namontoy/RobertUN/README.md

# RobertUN
Exploration Rover, inspired by the NASA's rovers that are exploring Mars. Developed at Universidad Nacional de Colombia - Sede Medellín, with the financial support from a research project.
