namontoy/RobertUN/docs/dev/environment/PROJECT_CONTEXT_WHEEL_FW_REF_MCU.md

# RobertUN wheel firmware — reference: MCU, pins, CAN and firmware modules

> Reference tier. Moved verbatim from `PROJECT_CONTEXT_WHEEL_FW.md` on 2026-09-26.
> Do not read whole: `grep -n '^#' <this file>` and read the section you need.
> Contents: CAN peripheral and bit timing, pin allocation, timers, firmware modules (debug_uart, can_bus, console), CAN error counters, bus load

## CAN BUS — STM32 PERIPHERAL & BIT TIMING

### STM32 CAN peripheral
- **STM32F4xx uses bxCAN peripheral** (Basic Extended CAN)
  - Full layer 2 implementation in hardware: frame construction, arbitration,
    CRC, ACK, fault confinement, acceptance filters — all in silicon
  - bxCAN outputs logic-level CAN_TX / CAN_RX to the SN65HVD230 transceiver
  - No built-in transceiver — external IC always required (same as Jetson)
- **CAN1 pins on the WeAct board: PB9 (TX) / PB8 (RX).** The alternate CAN1
  mapping PA11/PA12 is wired to the board's USB-C connector and must not be
  used. Use CAN1, not CAN2 — on the F446 CAN2 is a slave peripheral that cannot
  run without CAN1's clock enabled anyway.
- **bxCAN SJW maxes out at 4 tq** (the register field is 2 bits wide), and must
  also be <= BS2. Orion's `sjw 16` therefore does *not* transfer literally to
  the STM32. The rule that carries across is **"set SJW explicitly on every
  node, at the highest value that node's hardware allows"** — not the number 16.

#### Bit timing @ 250 kbps (derived Aug 9, 2026, from 8 MHz HSE)

| Parameter | Value | Notes |
|---|---|---|
| HSE | 8 MHz | crystal on WeAct board, scope-verified |
| SYSCLK | 180 MHz | PLL M=4, N=180, P=2 — see divider note below |
| APB1 (bxCAN clock) | 45 MHz | /4 |
| Prescaler (BRP) | 12 | tq = 266.67 ns |
| Bit Segment 1 (BS1) | 12 tq | HAL: `CAN_BS1_12TQ` |
| Bit Segment 2 (BS2) | 2 tq | HAL: `CAN_BS2_2TQ` |
| SJW | 2 tq | HAL: `CAN_SJW_2TQ` — hardware max here (<= BS2) |
| Total | 15 tq | 15 x 266.67 ns = 4.0 us = 250 kbps |
| Sample point | 86.7% | (1+12)/15 — closest achievable to Orion's 87.5% |

**Why 180 MHz and not the conventional 168 MHz:** 45 MHz on APB1 divides into
250 kbps with a better sample point than 42 MHz does. Consequence: USB's 48 MHz
must come from PLLSAI rather than PLLQ. Irrelevant unless USB is ever needed.

**PLL dividers — record corrected Aug 9, 2026.** An earlier revision of this
table recorded M=8, N=360. Both pairs reach 180 MHz, but they are not
equivalent: M=8 gives a 1 MHz PLL input, M=4 gives 2 MHz. RM0390 requires the
PLL input to be 0.95-2.1 MHz and explicitly recommends **2 MHz to limit PLL
jitter**. The firmware uses **M=4, N=180, P=2**, which is the better of the two
and the pair to replicate to the other five boards in W7. Verify against
`SystemClock_Config()` rather than this table if they ever disagree again.

**Oscillator tolerance check.** df <= SJW/(20 x NBT): STM32 = 2/(20x15) = 0.67%;
Orion = 16/(20x200) = 0.40%. Orion is the binding node. Two crystals at +/-30 ppm
(0.003%) sit two orders of magnitude inside that margin. This is the calculation
that rules out HSI (+/-1%) — see the W1 debrief in the roadmap.

- **bxCAN receives nothing until an acceptance filter is configured AND
  activated.** Default state is all filters disabled. Presents as "TX works
  perfectly, RX is dead" and gets misdiagnosed as wiring or termination. For
  bring-up use filter bank 0, mask mode, ID 0x000 / mask 0x000 (accept
  everything); narrow it once the CAN ID table is real.
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
