namontoy/RobertUN/docs/dev/environment/PROJECT_CONTEXT_WHEEL_FW_REF_TASK6_CAN_LATENCY.md

# Task 6 — CAN RX polled-vs-interrupt: latency/jitter bench procedure

Setup: daedalus + CANable V2.0 Pro (`1d50:606f`), orion not required (see
`_REF_MCU` "OPEN — polled vs interrupt-driven CAN RX" for why the decision
doesn't depend on orion being on the bus).

## Bring up `can0` on daedalus

```
sudo ip link set can0 type can bitrate 250000
sudo ip link set can0 up
```

## Firmware console

USB-TTL adapter, `/dev/ttyUSB0`, 115200 8N1 (ST-Link has no VCP — see
`_REF_DEVENV` "Debug probes"). Sent via a short pyserial script, one command
per write, echo read back:

```
heartbeat on
```

## Method

TIM7 drives the heartbeat (ID `0x500`) at a nominal 500 ms period from the
main loop (`_REF_MCU` line ~128). If the RX path (polled or interrupt) delays
the main loop under load, heartbeat inter-arrival jitter is a proxy for that
latency/coupling — this is the gap the Aug 11 throughput ramp explicitly did
not measure.

1. Start capture: `candump -tz can0 > <file>`
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
