namontoy/RobertUN/docs/dev/environment/figures/velocity_loop_stair_21min.png

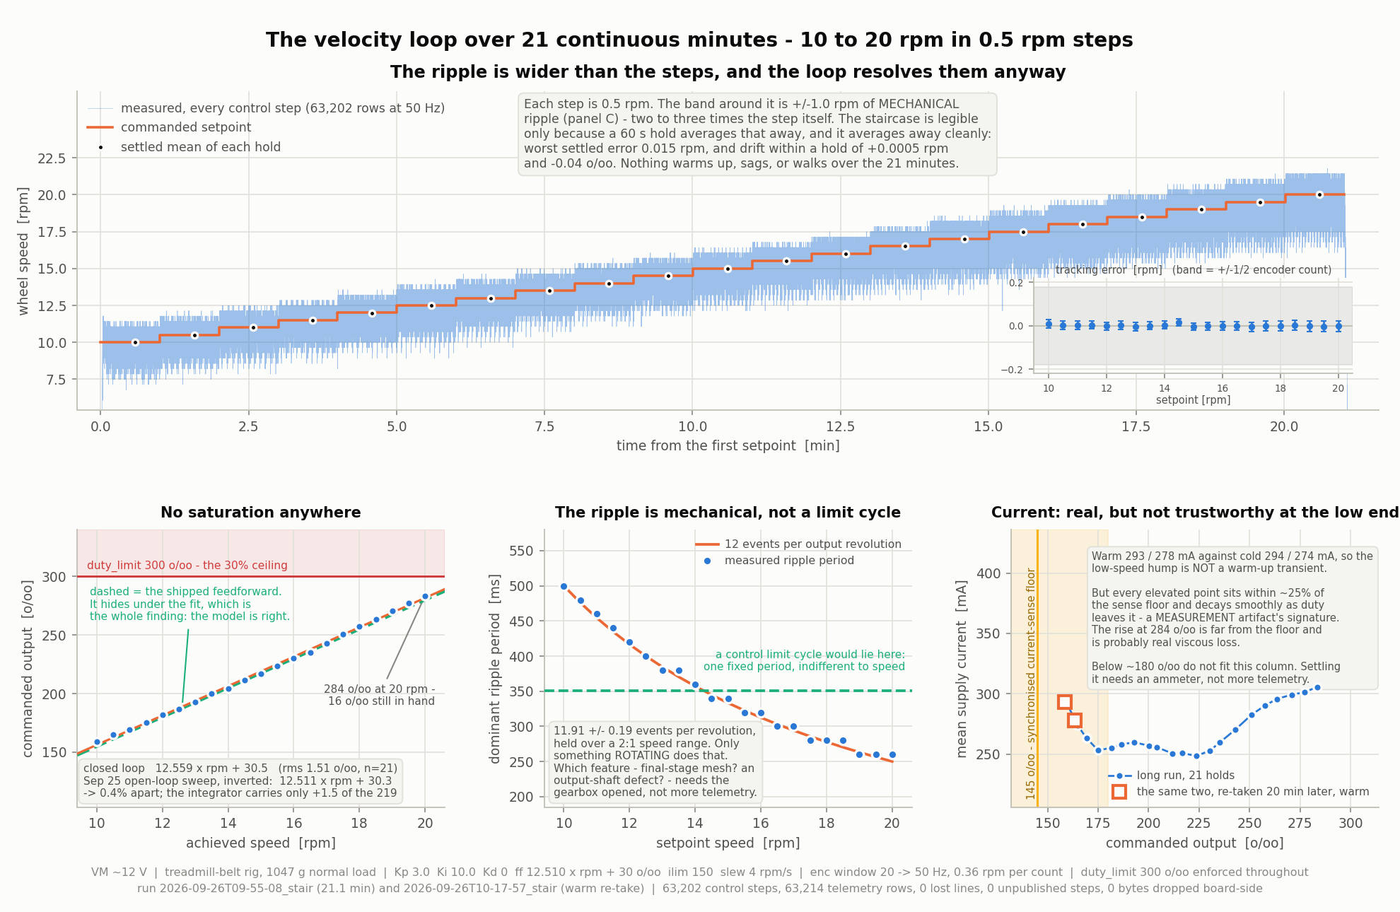
docs/dev/environment/figures/velocity_loop_stair_21min.png
