namontoy/RobertUN/docs/dev/environment/figures/velocity_loop_stair_direction.png

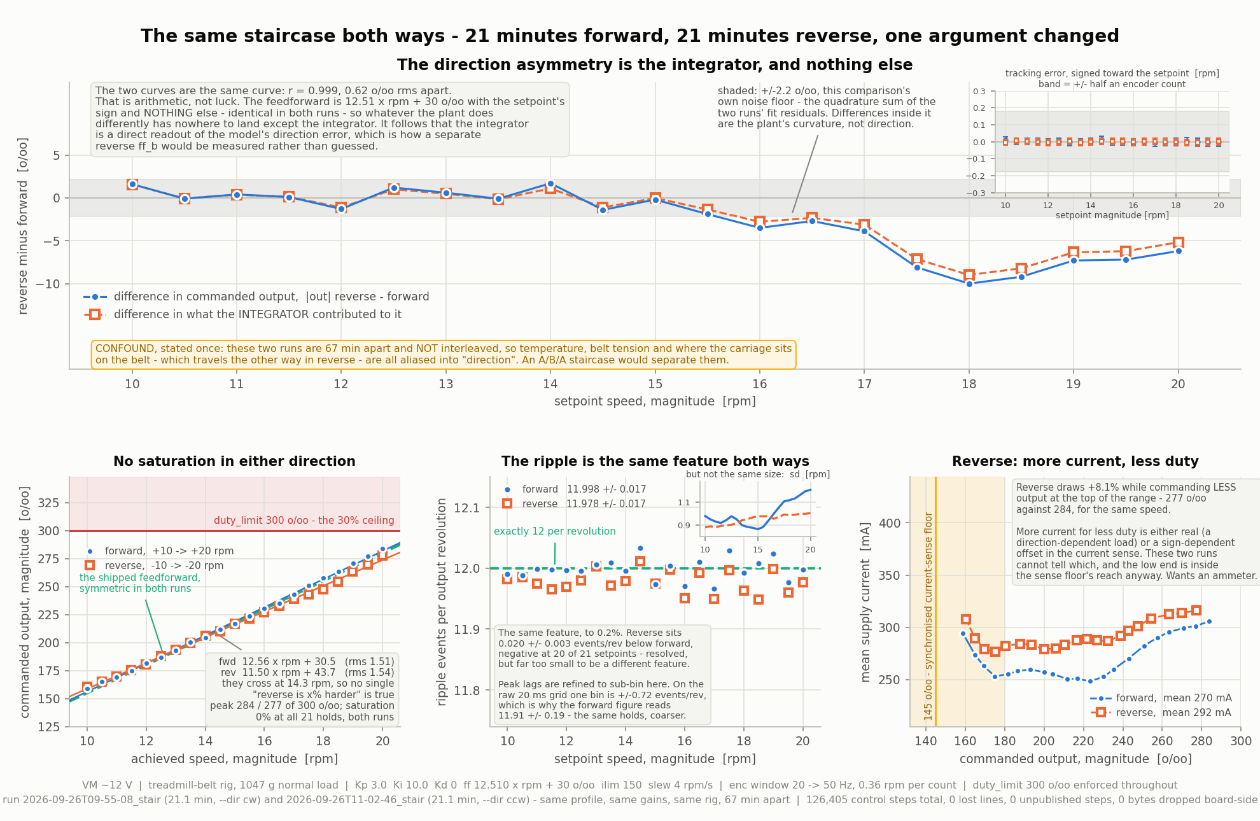
docs/dev/environment/figures/velocity_loop_stair_direction.png
