namontoy/RobertUN/docs/figures/driverwheels_bottom_mask.png

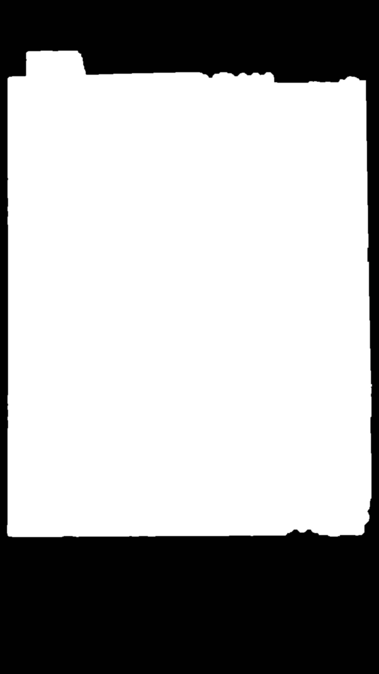
docs/figures/driverwheels_bottom_mask.png
