namontoy/RobertUN/docs/figures/driverwheels_mask.png

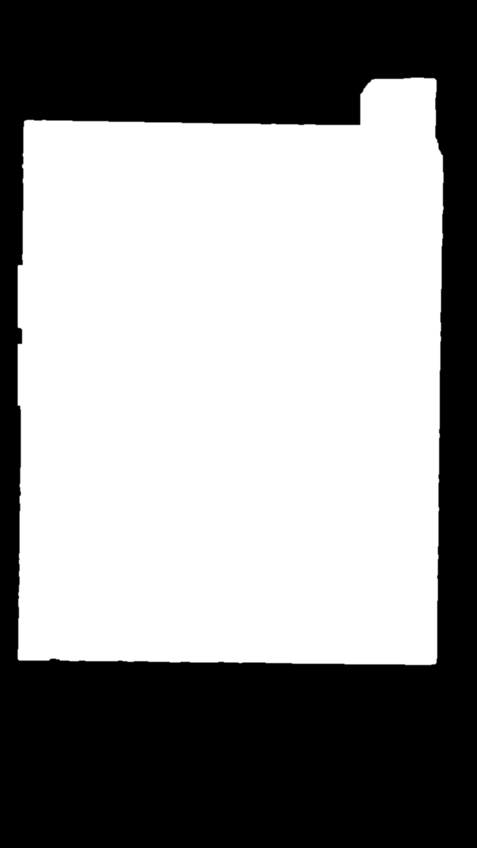
docs/figures/driverwheels_mask.png
