namontoy/RobertUN/docs/images/other_rovers/005_MarsRover_Fredj21.jpg

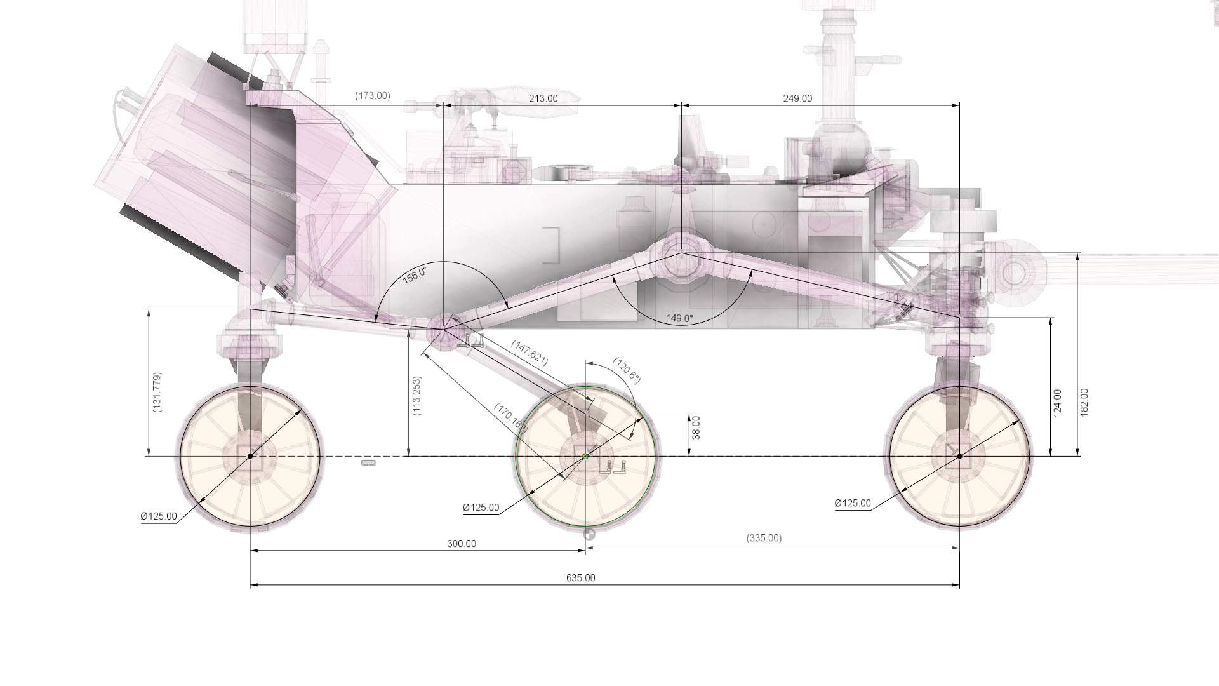
docs/images/other_rovers/005_MarsRover_Fredj21.jpg
