namontoy/RobertUN/docs/images/other_rovers/Mars_Exploration_Rover.jpg

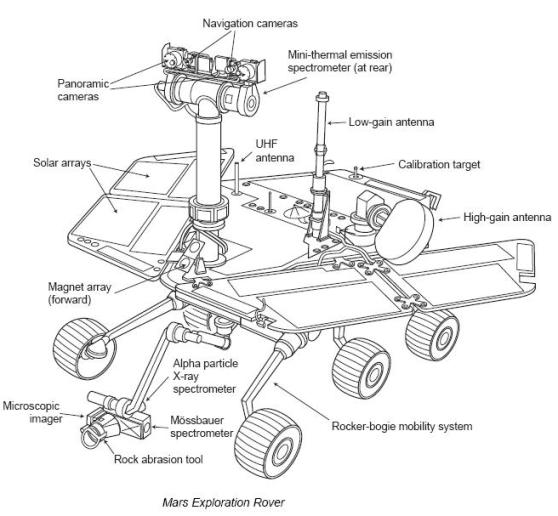
docs/images/other_rovers/Mars_Exploration_Rover.jpg
