namontoy/RobertUN/docs/images/other_rovers/MarsRover_Fredj21_no_meas.jpg

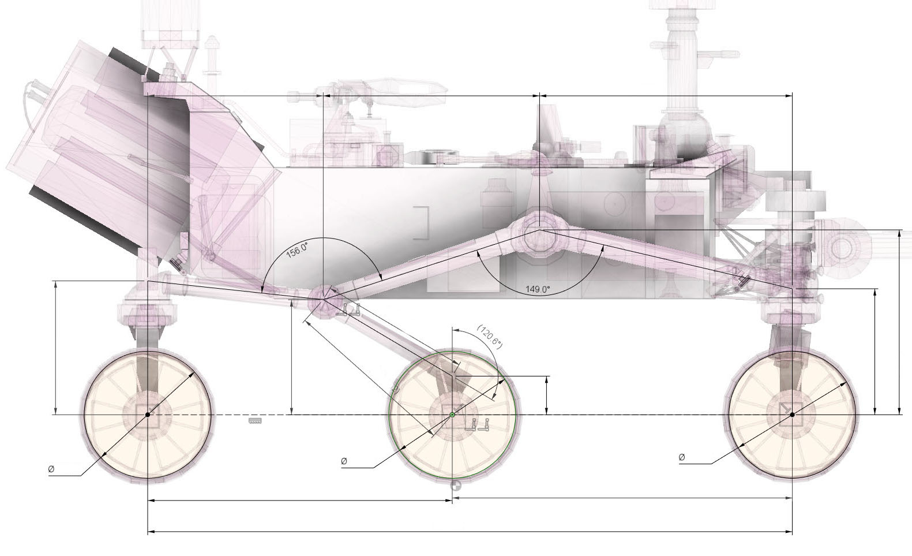
docs/images/other_rovers/MarsRover_Fredj21_no_meas.jpg
