namontoy/RobertUN/docs/images/other_rovers/MERs-bythenumbers-infographic.jpg

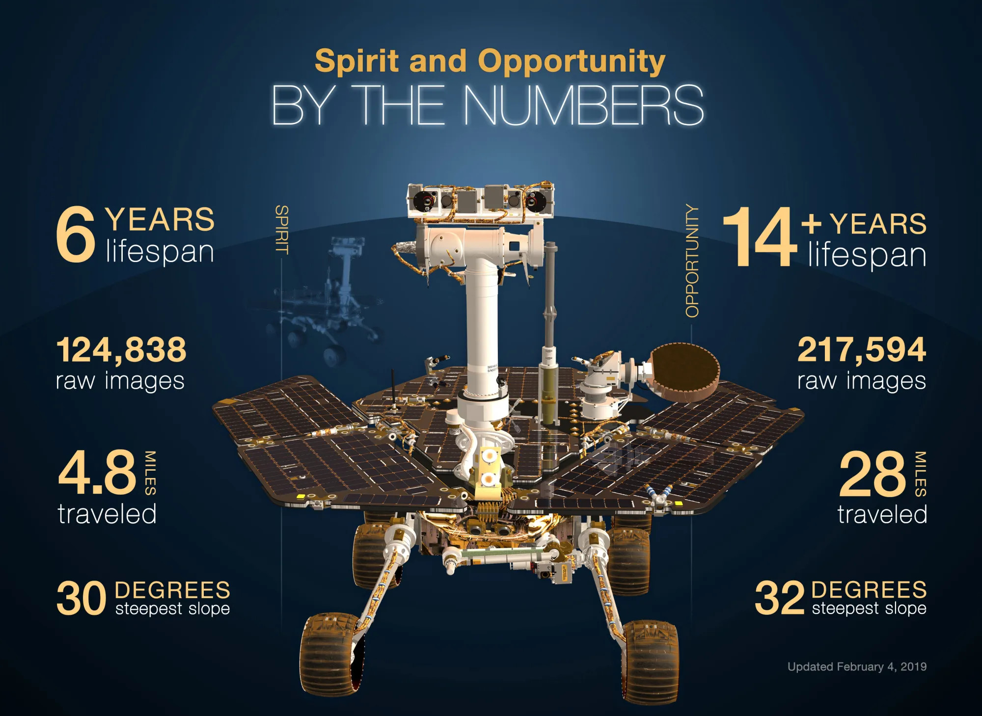
docs/images/other_rovers/MERs-bythenumbers-infographic.jpg
