namontoy/RobertUN/docs/images/other_rovers/Oppy_Front.png

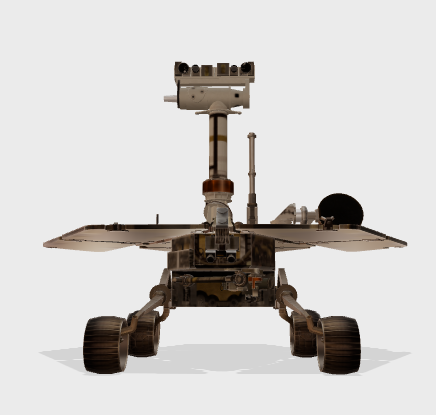
docs/images/other_rovers/Oppy_Front.png
