namontoy/RobertUN/docs/images/other_rovers/Oppy_Side.png

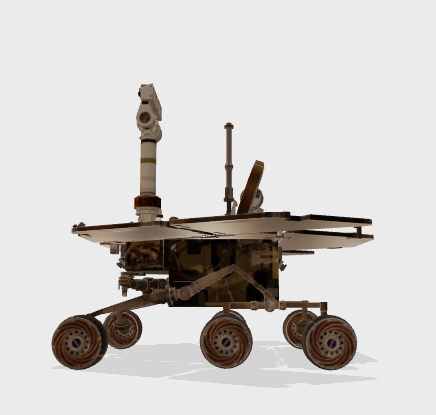
docs/images/other_rovers/Oppy_Side.png
