namontoy/RobertUN/docs/images/other_rovers/Rocker-Bogie_RoverUN_over_Curiosity.jpg

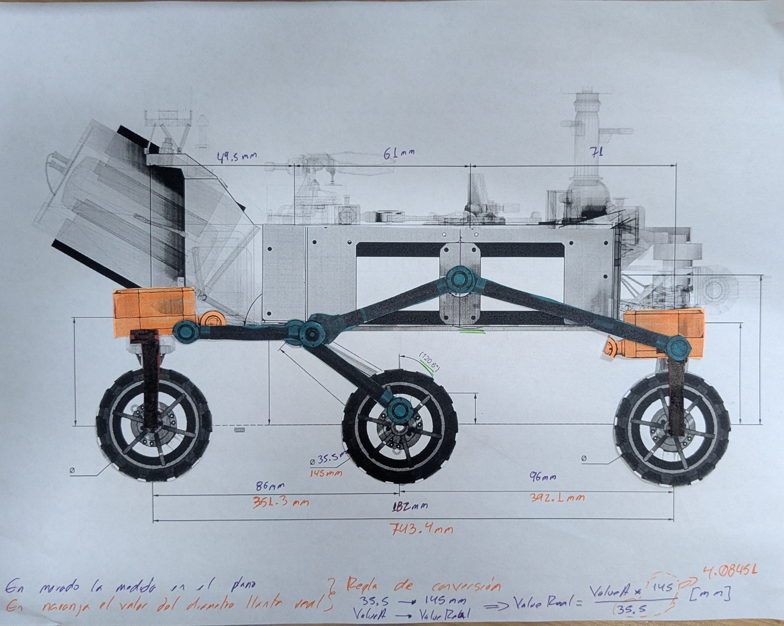
docs/images/other_rovers/Rocker-Bogie_RoverUN_over_Curiosity.jpg
