namontoy/RobertUN/docs/images/other_rovers/Rocker-Bugie-RoverUN_actual.jpg

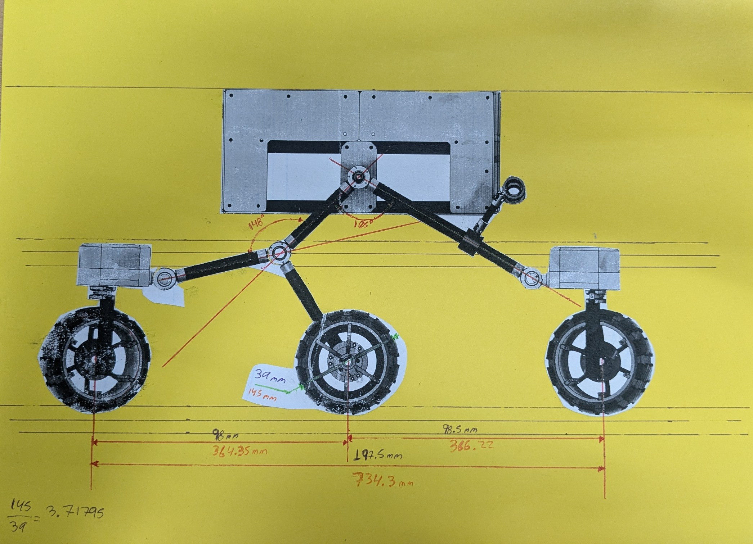
docs/images/other_rovers/Rocker-Bugie-RoverUN_actual.jpg
