namontoy/RobertUN/docs/images/other_rovers/Rocker-Bugie-RoverUN_modificacion.jpg

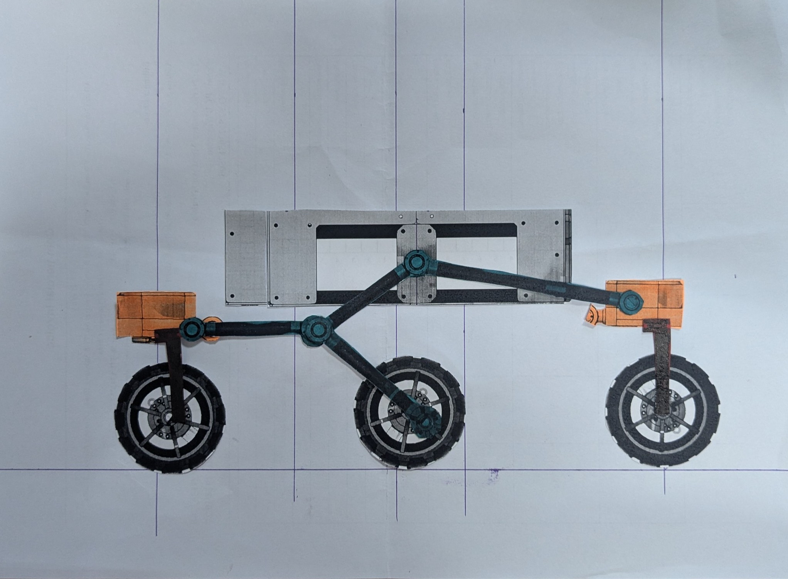
docs/images/other_rovers/Rocker-Bugie-RoverUN_modificacion.jpg
