namontoy/RobertUN/docs/images/other_rovers/Rover_UN_model.PNG

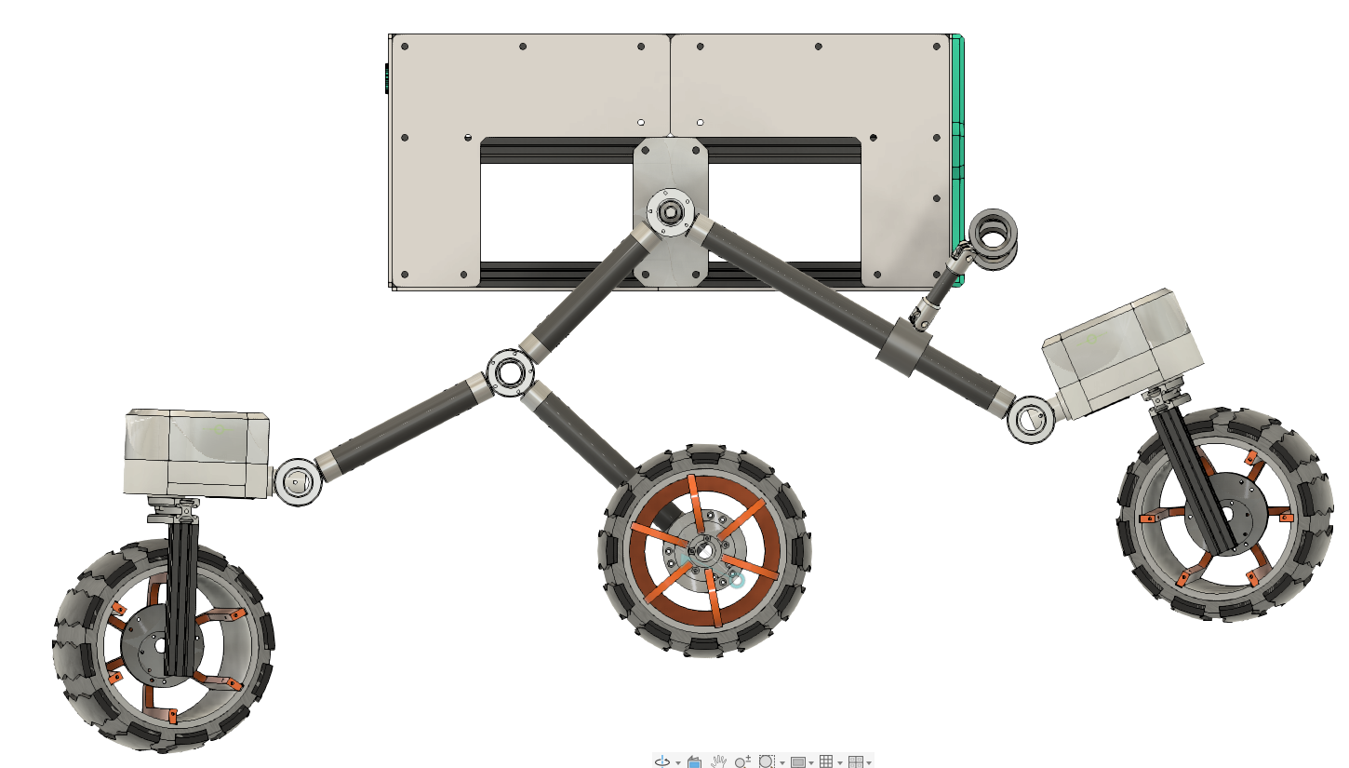
docs/images/other_rovers/Rover_UN_model.PNG
