namontoy/RobertUN/docs/images/other_rovers/Rover_UN_model_disasembled.jpg

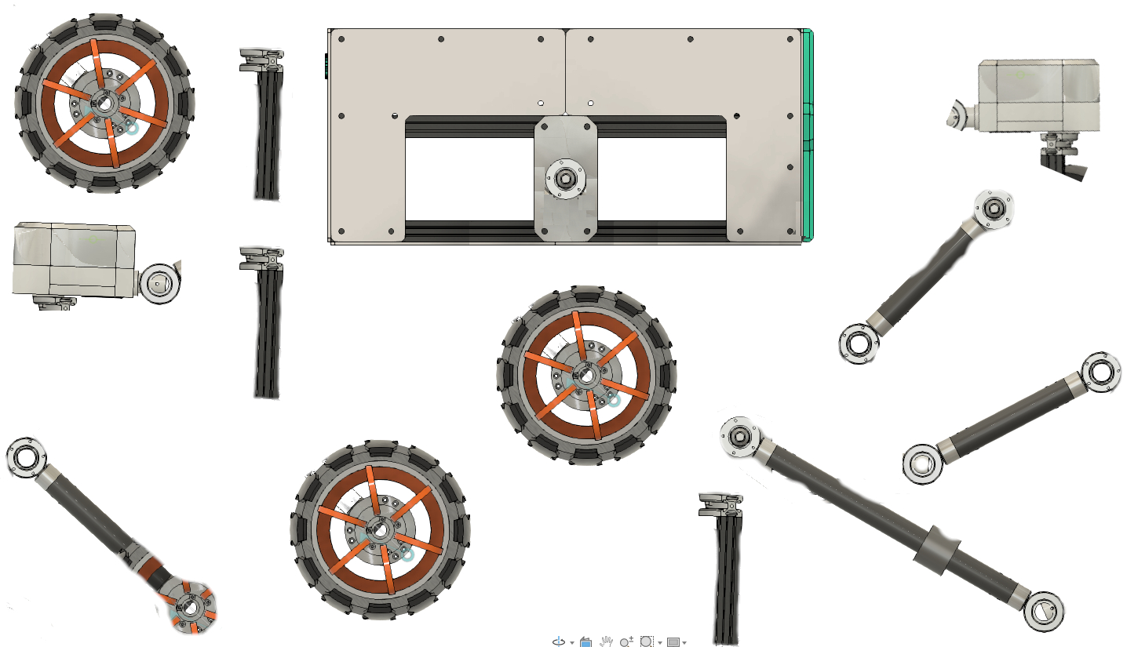
docs/images/other_rovers/Rover_UN_model_disasembled.jpg
