namontoy/RobertUN/docs/images/other_rovers/Rover_UN_model_Top.PNG

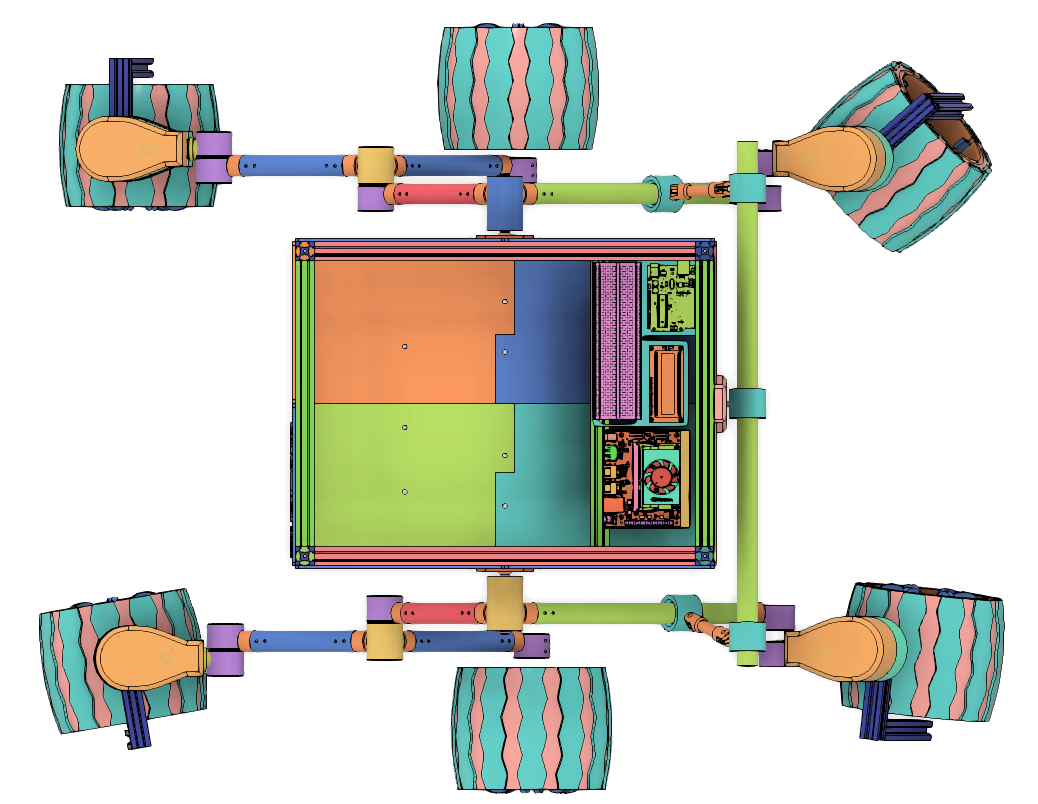
docs/images/other_rovers/Rover_UN_model_Top.PNG
