namontoy/RobertUN/docs/images/other_rovers/Scketch_TopView_OpportunityRover.png

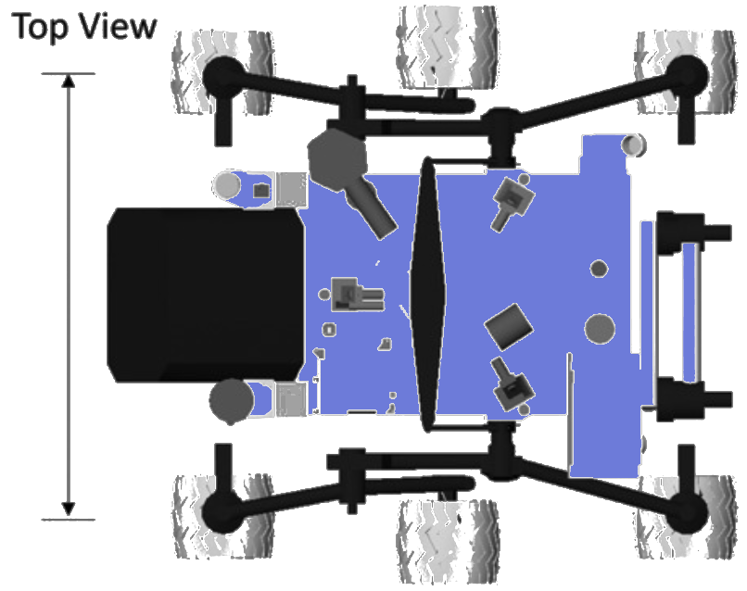
docs/images/other_rovers/Scketch_TopView_OpportunityRover.png
