namontoy/RobertUN/docs/images/other_rovers/Wheels_detail_of_ExoMars_Amalia_rover.jpg

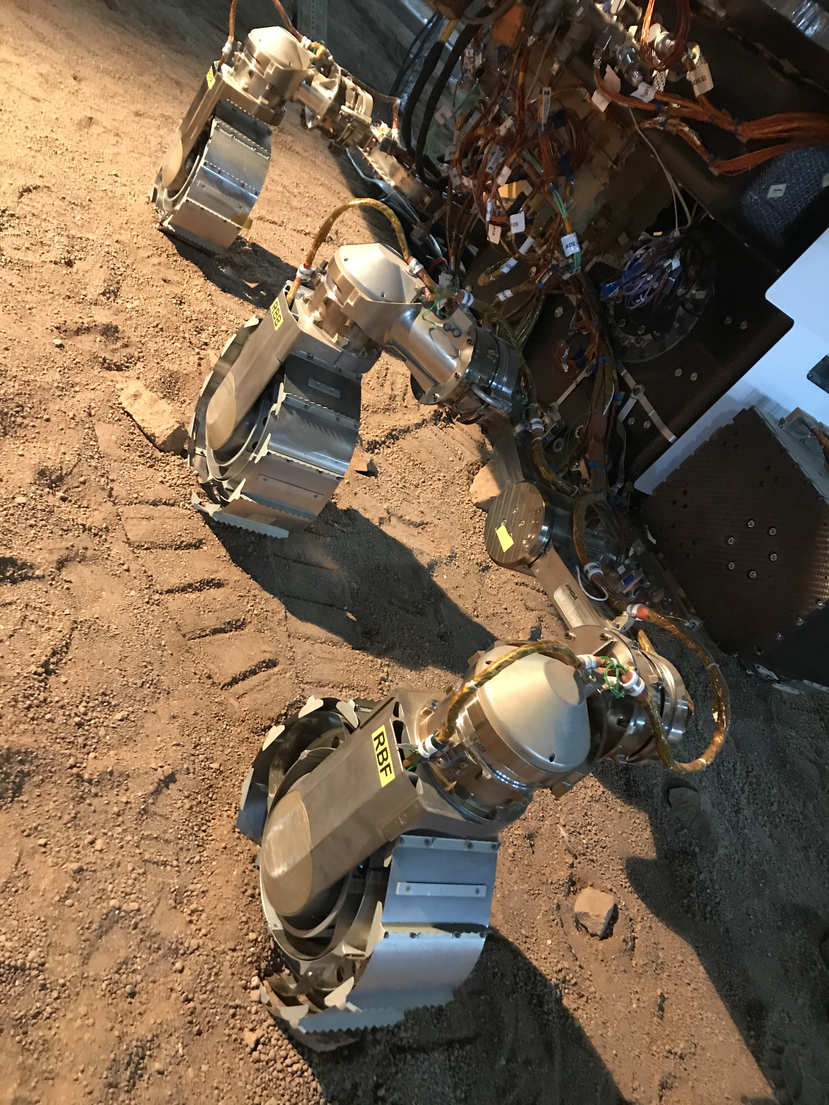
docs/images/other_rovers/Wheels_detail_of_ExoMars_Amalia_rover.jpg
