namontoy/RobertUN/docs/images/prototype/Prototype_DriverWheels.jpg

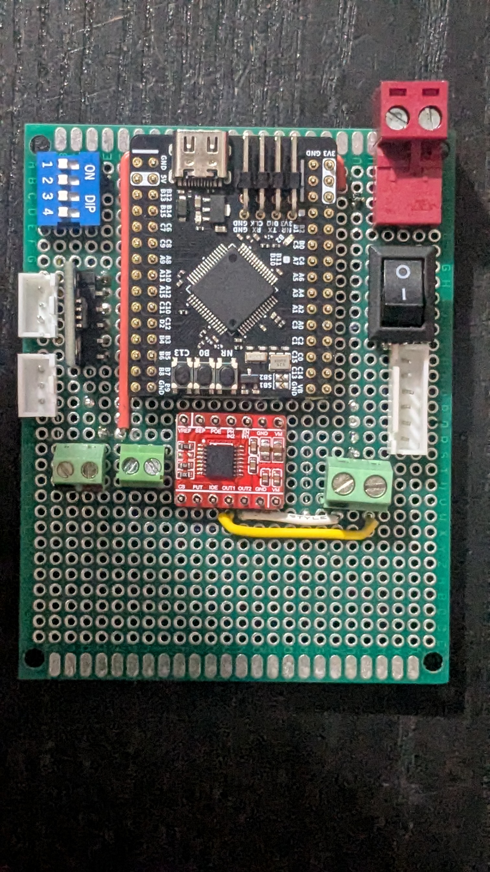
docs/images/prototype/Prototype_DriverWheels.jpg
