namontoy/RobertUN/docs/images/prototype/Prototype_DriverWheels_Bottom.jpg

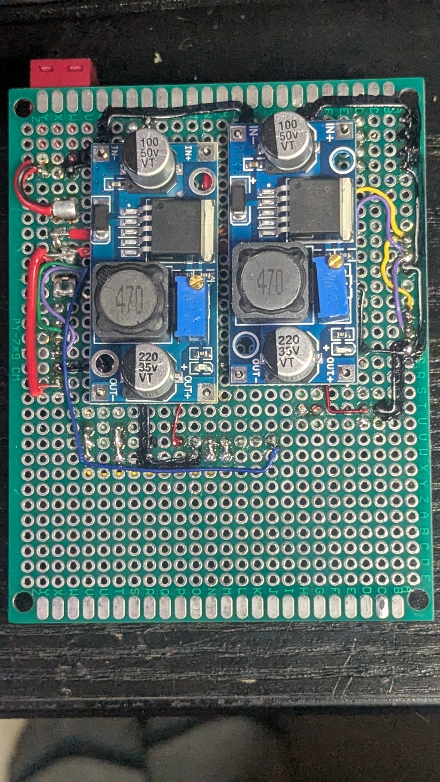
docs/images/prototype/Prototype_DriverWheels_Bottom.jpg
