namontoy/RobertUN/docs/images/prototype/Prototype_DriverWheels_Bottom_boxes.jpg

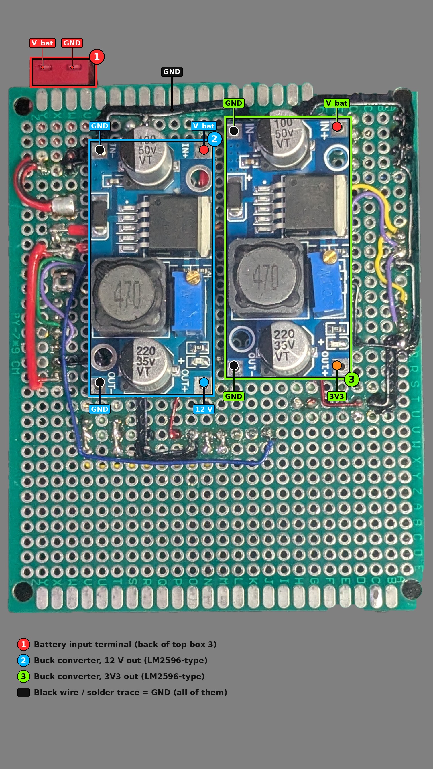
docs/images/prototype/Prototype_DriverWheels_Bottom_boxes.jpg
