namontoy/RobertUN/docs/images/prototype/Prototype_DriverWheels_boxes.jpg

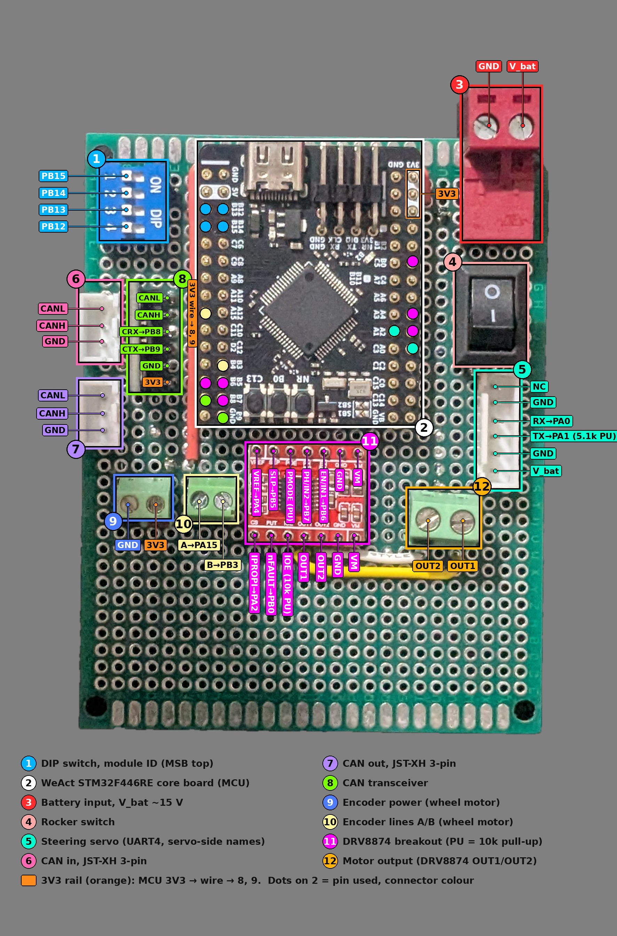
docs/images/prototype/Prototype_DriverWheels_boxes.jpg
