namontoy/RobertUN/docs/dev/environment/figures/velocity_step_slew_anchor.png

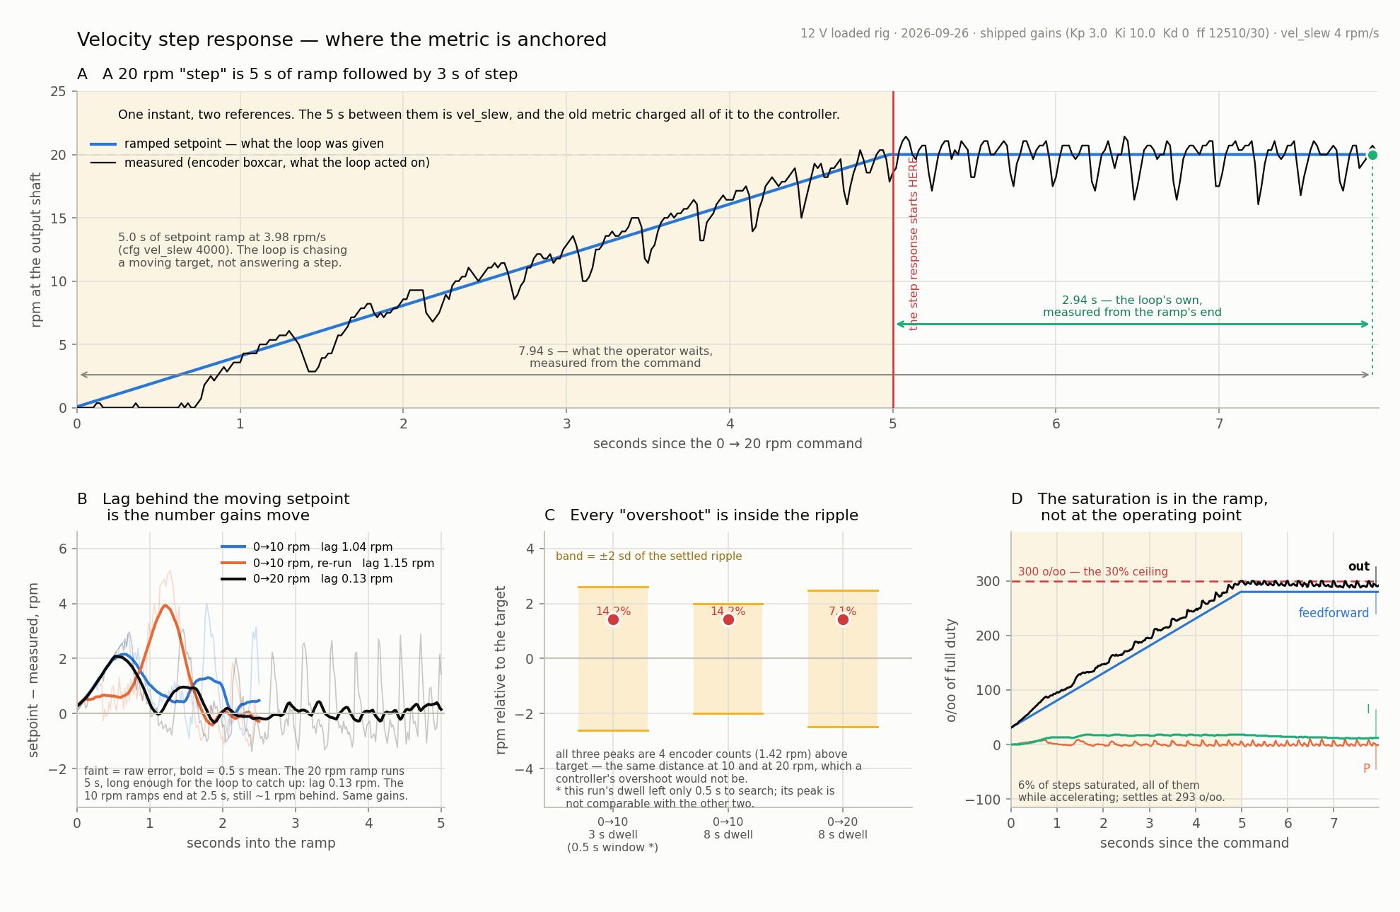
docs/dev/environment/figures/velocity_step_slew_anchor.png
