namontoy/RobertUN/hardware/BoardRover2/BoardRover2-B_Cu.pdf

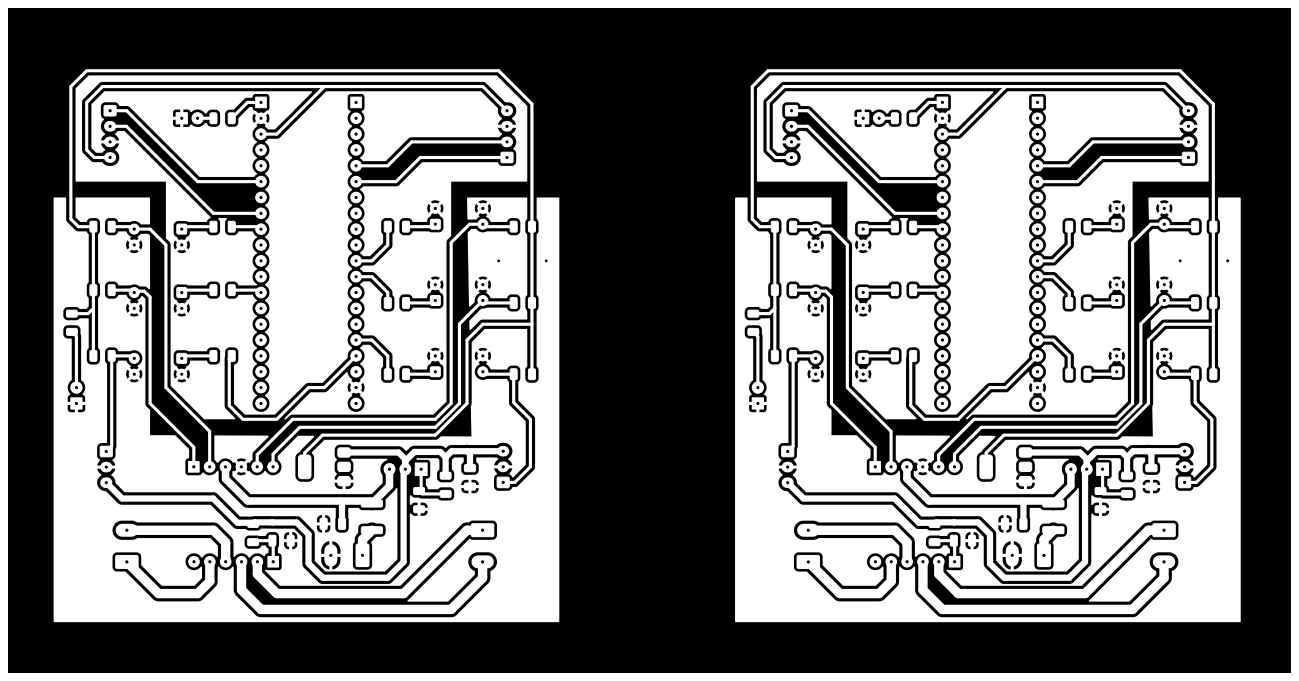
[picture p27: page 1]
