namontoy/RobertUN/hardware/BoardRover2/BoardRover2-Edge_Cuts.pdf

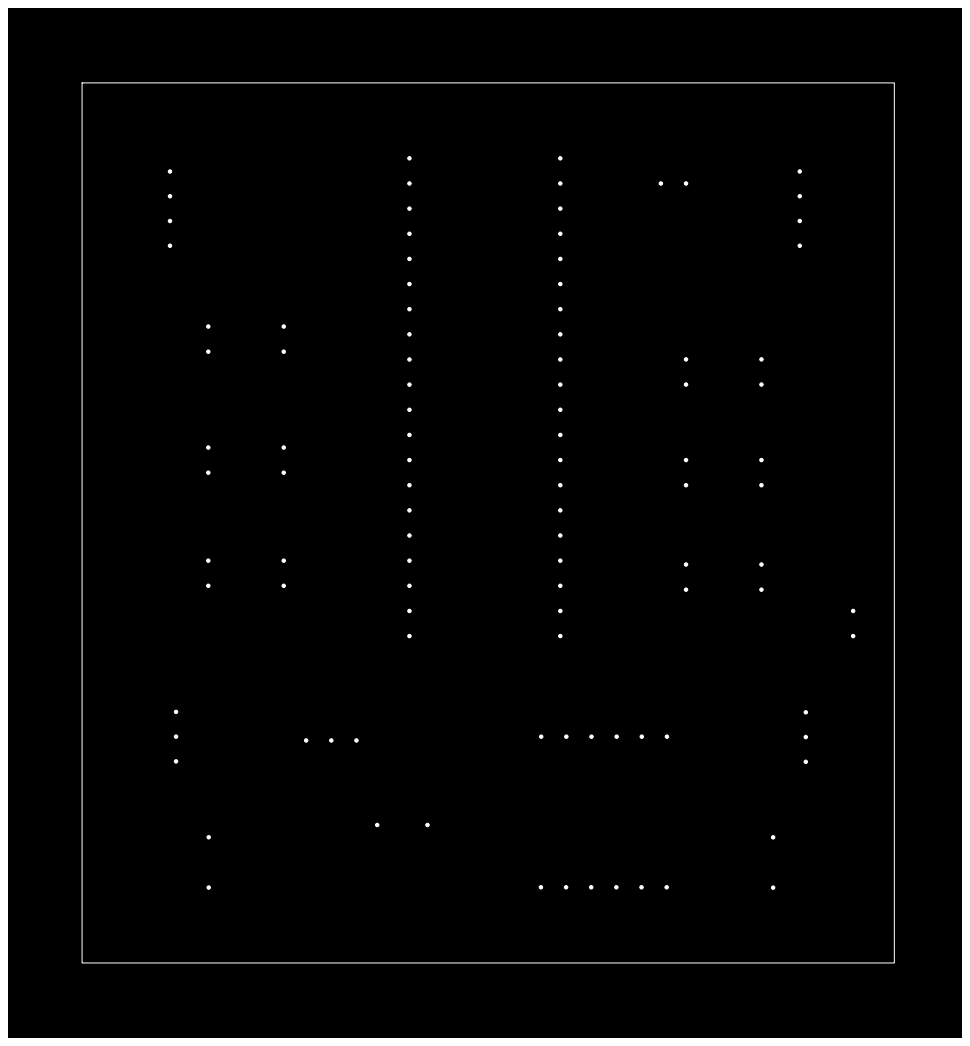
[picture p28: page 1]
