namontoy/RobertUN/hardware/BoardRover2/BoardRover2-Margin.pdf

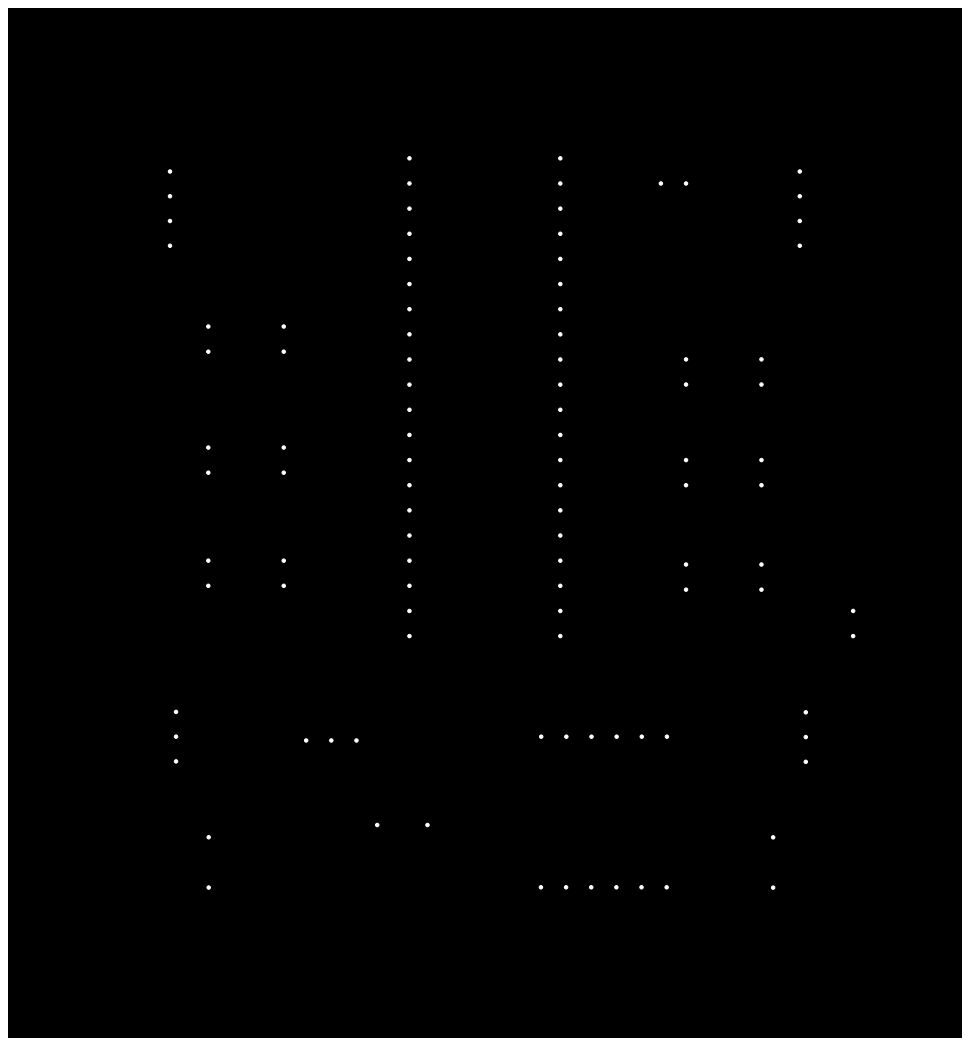
[picture p29: page 1]
