namontoy/RobertUN/hardware/BoardRover2/pdfBoard.pdf

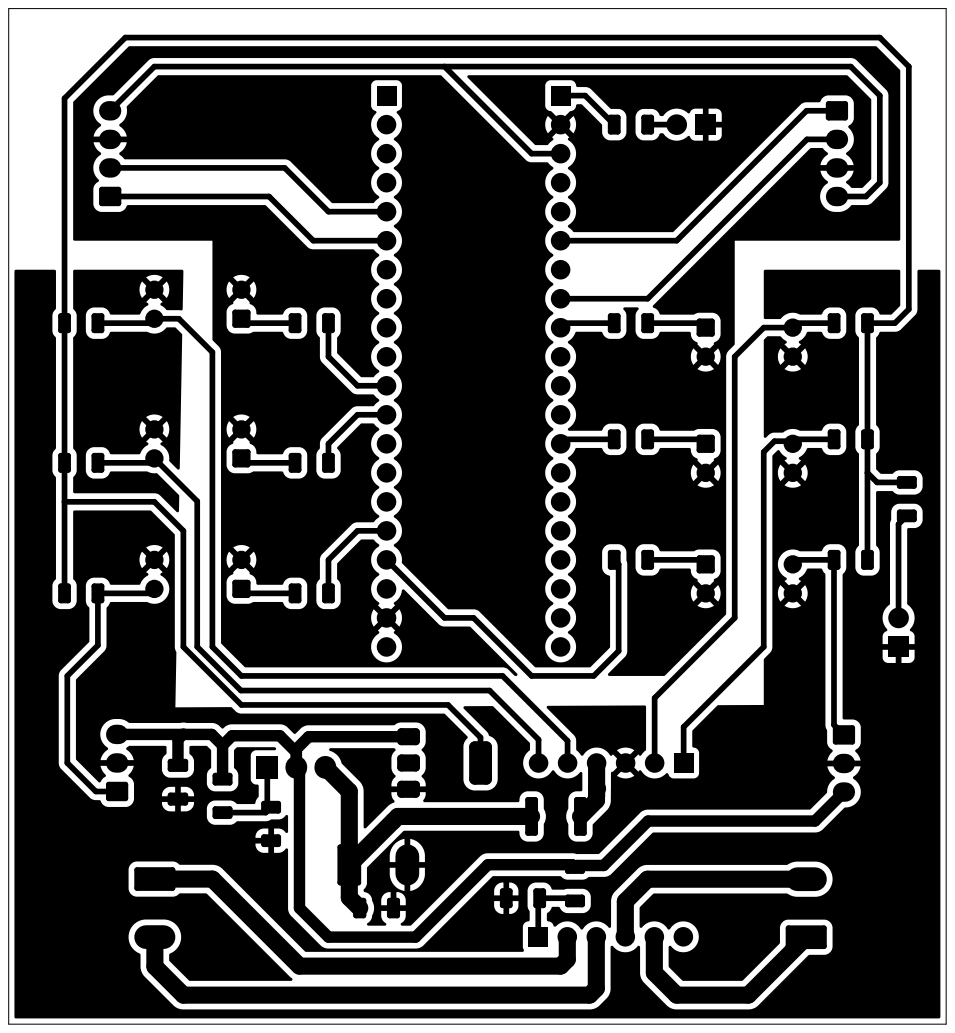
[picture p30: page 1]
