namontoy/RobertUN/hardware/BoardRover2/BoardRover2.kicad_pcb

## KiCad design hardware/BoardRover2/BoardRover2.kicad_pcb (2026-01-29)

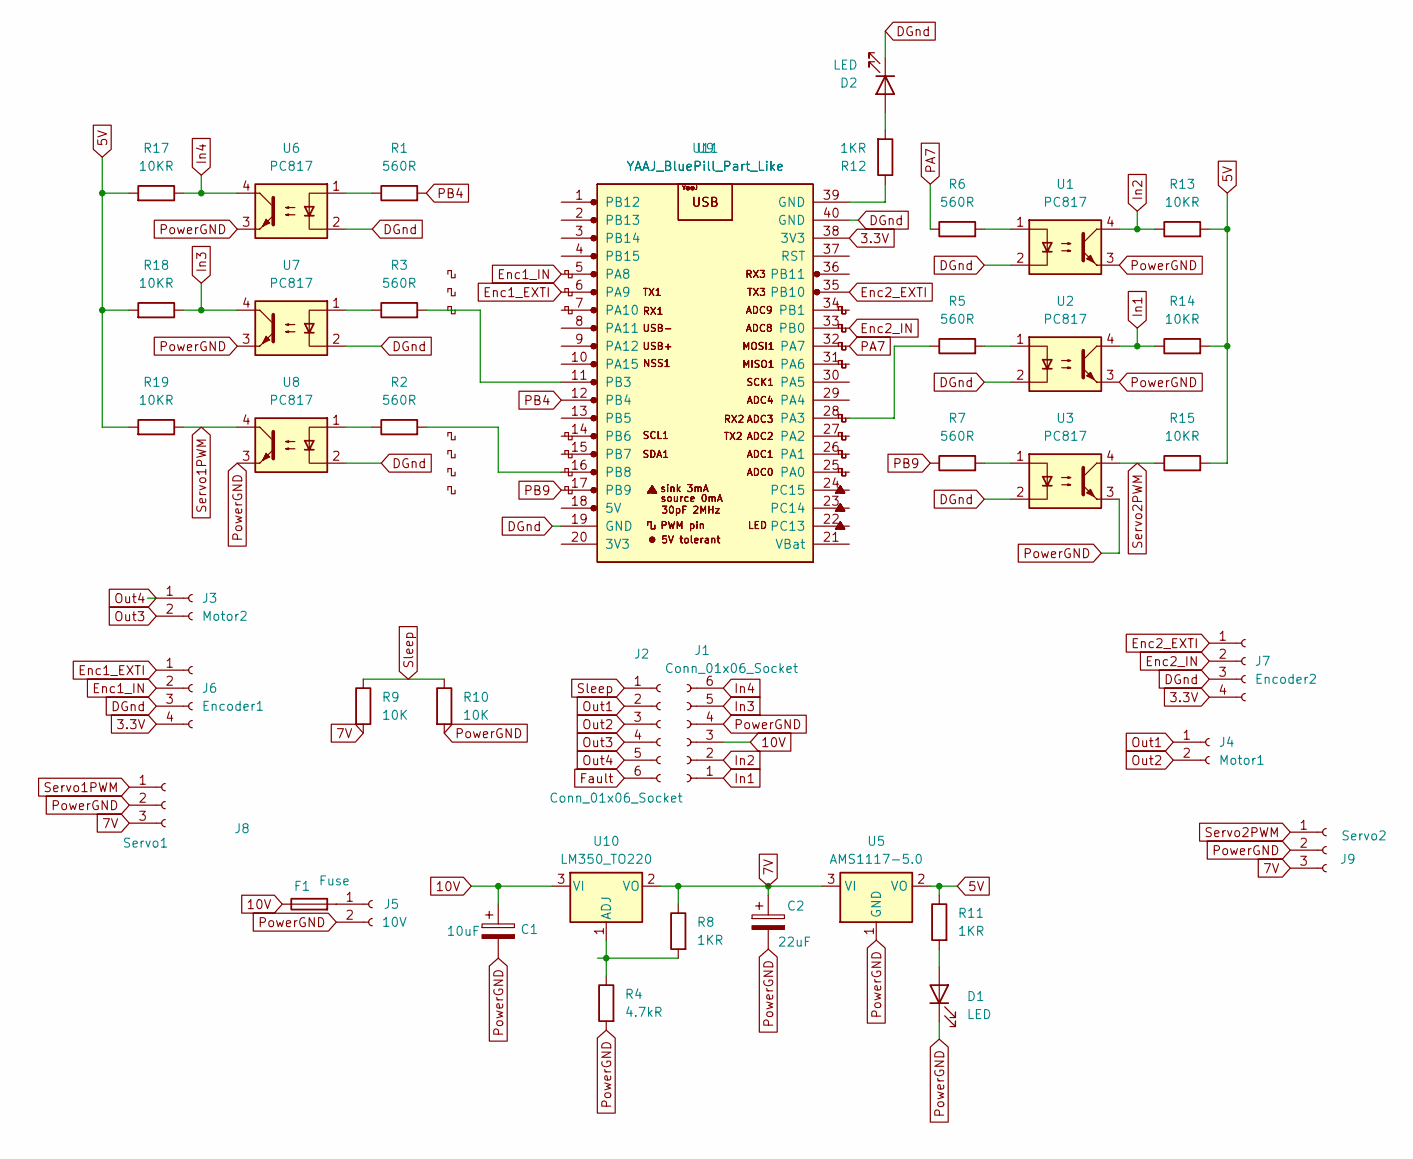
[picture p31: schematic BoardRover2.kicad_sch]

Parts:
C1: 10uF; C_1206_3216Metric
C2: 22uF; C_1206_3216Metric
D1, D2: LED; LED_D3.0mm_Clear
F1: Fuse; Fuse_1812_4532Metric
J1, J2: Conn_01x06_Socket; PinSocket_1x06_P2.54mm_Vertical
J3: Motor2; PhoenixContact_MSTBA_2,5_2-G-5,08_1x02_P5.08mm_Horizontal
J4: Motor1; PhoenixContact_MSTBA_2,5_2-G-5,08_1x02_P5.08mm_Horizontal
J5: 10V; PhoenixContact_MSTBA_2,5_2-G-5,08_1x02_P5.08mm_Horizontal
J6: Encoder1; JST_EH_S4B-EH_1x04_P2.50mm_Horizontal
J7: Encoder2; JST_EH_S4B-EH_1x04_P2.50mm_Horizontal
J8: Servo1; JST_EH_S3B-EH_1x03_P2.50mm_Horizontal
J9: Servo2; JST_EH_S3B-EH_1x03_P2.50mm_Horizontal
R1, R2, R3, R5, R6, R7: 560R; R_1206_3216Metric
R4: 4.7kR; R_1206_3216Metric
R8, R11, R12: 1KR; R_1206_3216Metric
R9, R10: 10K; R_1206_3216Metric
R13, R14, R15, R17, R18, R19: 10KR; R_1206_3216Metric
U1, U2, U3, U6, U7, U8: PC817; DIP-4_W7.62mm
U5: AMS1117-5.0; SOT-223-3_TabPin2
U9, U11: YAAJ_BluePill_Part_Like; PinSocket_1x20_P2.54mm_Vertical
U10: LM350_TO220; TO-220-3_Vertical

Connections:
3.3V: J6.4, J7.4, U11.38 (3V3)
5V: R11.1, R13.2, R14.2, R15.2, R17.2, R18.2, R19.2, U5.2 (VO)
7V: C2.1, J8.3, J9.3, R8.1, R9.2, U5.3 (VI), U10.2 (VO)
10V: C1.1, F1.1, J1.3 (MotorGND), U10.3 (VI)
DGnd: D2.1 (K), J6.3, J7.3, U1.2, U2.2, U3.2, U6.2, U7.2, U8.2, U9.19 (GND), U11.40 (GND)
Enc1_EXTI: J6.1, U9.6 (PA9)
Enc1_IN: J6.2, U9.5 (PA8)
Enc2_EXTI: J7.1, U11.35 (PB10)
Enc2_IN: J7.2, U11.33 (PB0)
Fault: J2.6 (Fault)
In1: J1.1 (In4), R14.1, U2.4
In2: J1.2 (In3), R13.1, U1.4
In3: J1.5 (In2), R18.1, U7.4
In4: J1.6 (In1), R17.1, U6.4
unnamed: D1.2 (A), R11.2
unnamed: D2.2 (A), R12.2
unnamed: F1.2, J5.1
unnamed: R1.1, U6.1
unnamed: R2.1, U8.1
unnamed: R3.1, U7.1
unnamed: R5.2, U2.1
unnamed: R6.2, U1.1
unnamed: R7.2, U3.1
unnamed: R12.1, U11.39 (GND)
unnamed: R3.2, U9.11 (PB3)
unnamed: R2.2, U9.16 (PB8)
unnamed: R4.1, R8.2, U10.1 (ADJ)
unnamed: R5.1, U11.28 (PA3)
Out1: J2.2 (Out1), J4.1
Out2: J2.3 (Out2), J4.2
Out3: J2.4 (Out3), J3.2
Out4: J2.5 (Out4), J3.1
PA7: R6.1, U11.32 (PA7)
PB4: R1.2, U9.12 (PB4)
PB9: R7.1, U9.17 (PB9)
PowerGND: C1.2, C2.2, D1.1 (K), J1.4 (MotorVCC), J5.2, J8.2, J9.2, R4.2, R10.2, U1.3, U2.3, U3.3, U5.1 (GND), U6.3, U7.3, U8.3
Servo1PWM: J8.1, R19.1, U8.4
Servo2PWM: J9.1, R15.1, U3.4
Sleep: J2.1 (Sleep), R9.1, R10.1

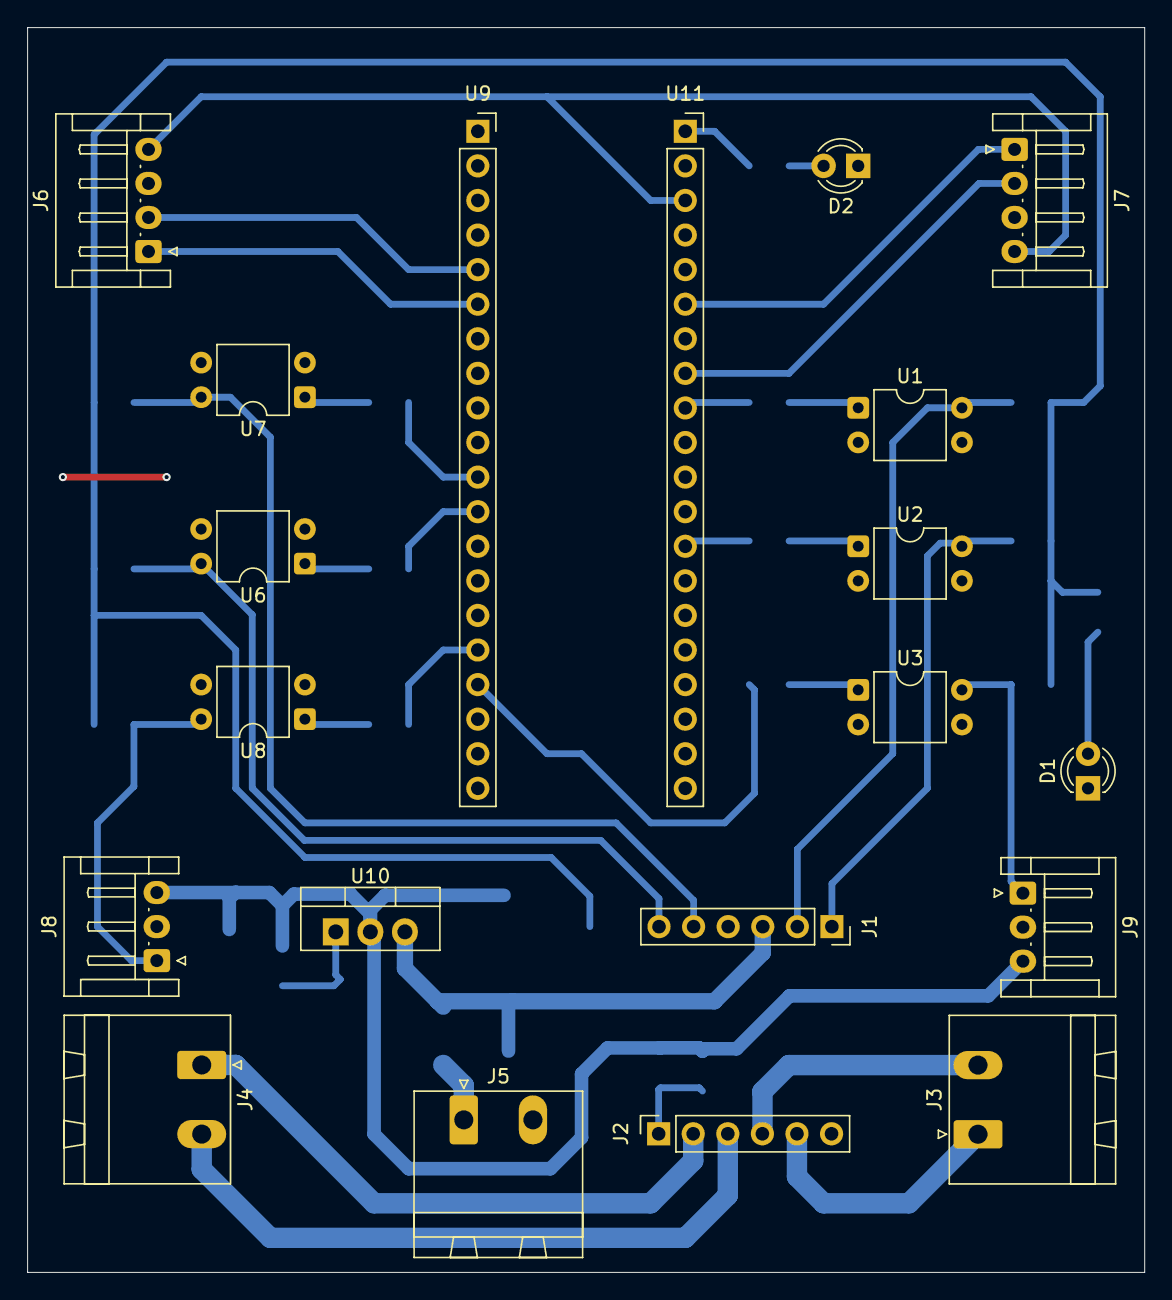
[picture p32: board BoardRover2.kicad_pcb from above]

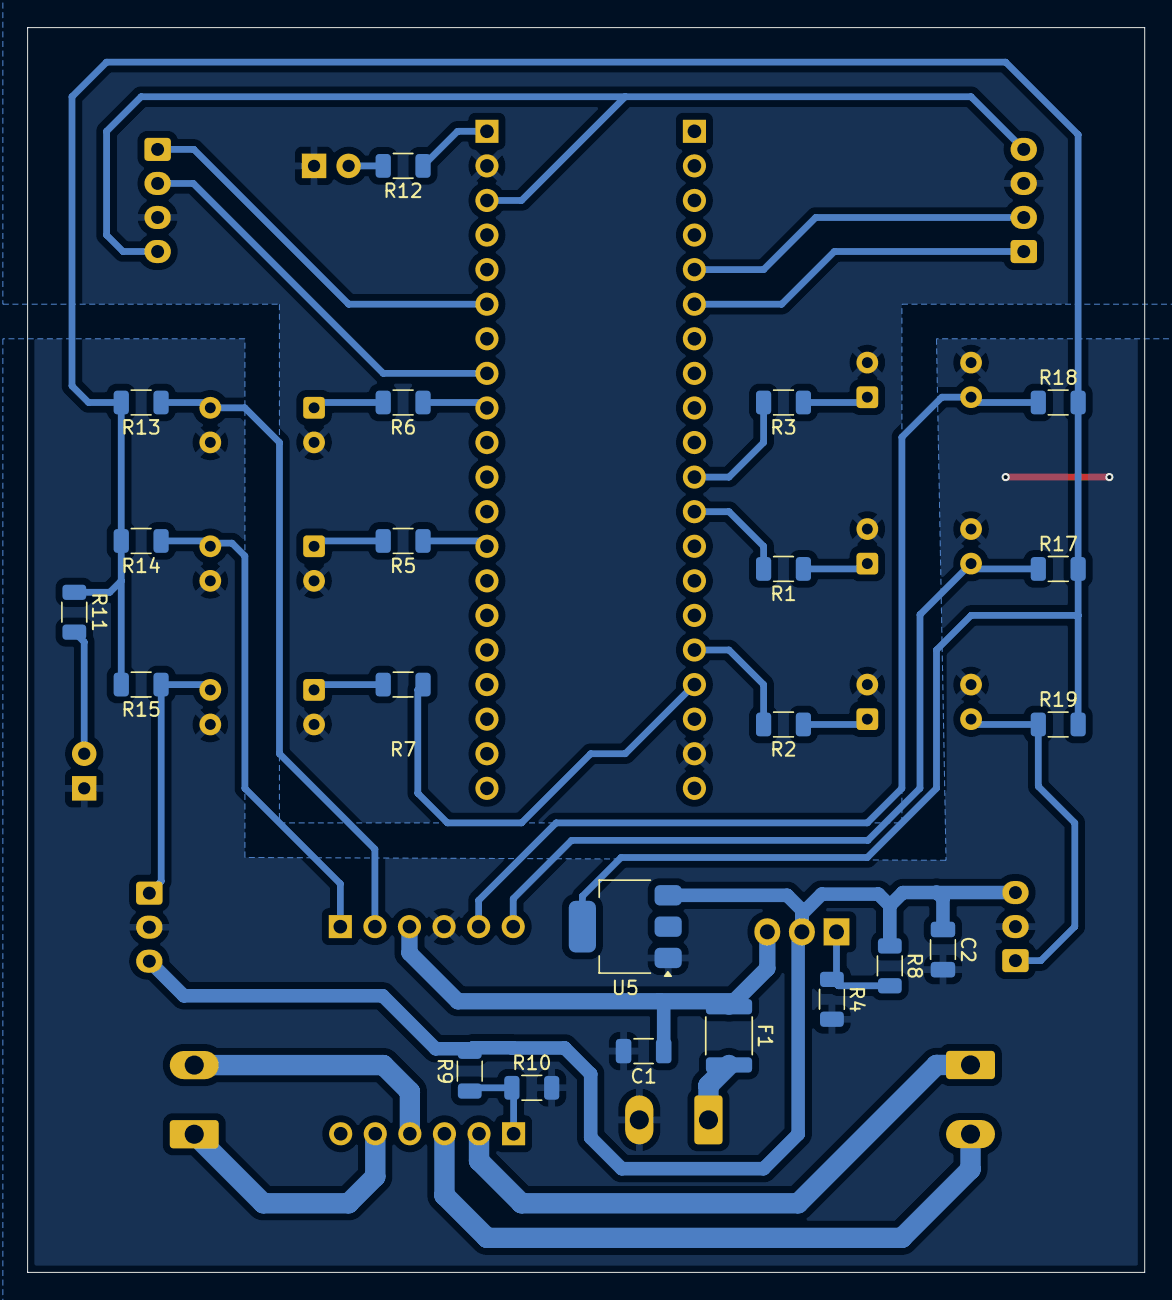
[picture p33: board BoardRover2.kicad_pcb from below]

Board: 2 copper layers, 82.1 x 91.4 mm, 42 parts (22 on the bottom side), 38 nets.
