namontoy/RobertUN/firmware/projects/RobertUN_ModuleNode/Core/Src/main.c

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
/* Includes ------------------------------------------------------------------*/
#include "main.h"

/* USER CODE BEGIN Includes */
/* claude --resume 436a6188-32d4-441d-abe8-485a62b8645e */
#include "debug_uart.h"
#include "can_bus.h"
#include "console.h"
#include "mks_servo.h"
#include "encoder.h"
#include "drive.h"
#include "velocity.h"
#include "isense.h"
#include "config.h"
#include "dipsw.h"
#include "motion.h"
#include "can_cmd.h"
#include "steer.h"
/* USER CODE END Includes */

ADC_HandleTypeDef hadc1;

CAN_HandleTypeDef hcan1;

DAC_HandleTypeDef hdac;

TIM_HandleTypeDef htim2;
TIM_HandleTypeDef htim4;
TIM_HandleTypeDef htim6;
TIM_HandleTypeDef htim7;

UART_HandleTypeDef huart4;
UART_HandleTypeDef huart1;
DMA_HandleTypeDef hdma_uart4_rx;
DMA_HandleTypeDef hdma_uart4_tx;
DMA_HandleTypeDef hdma_usart1_rx;
DMA_HandleTypeDef hdma_usart1_tx;

/* USER CODE BEGIN PV */
static volatile bool heartbeat_due;   /* set by the TIM7 ISR, cleared in main */
/* USER CODE END PV */

void SystemClock_Config(void);
static void MX_GPIO_Init(void);
static void MX_DMA_Init(void);
static void MX_CAN1_Init(void);
static void MX_TIM2_Init(void);
static void MX_TIM4_Init(void);
static void MX_TIM6_Init(void);
static void MX_TIM7_Init(void);
static void MX_USART1_UART_Init(void);
static void MX_UART4_Init(void);
static void MX_ADC1_Init(void);
static void MX_DAC_Init(void);
/**
  * @brief  The application entry point.
  * @retval int
  */
int main(void)
{

  /* MCU Configuration--------------------------------------------------------*/

  /* Reset of all peripherals, Initializes the Flash interface and the Systick. */
  HAL_Init();

  /* Configure the system clock */
  SystemClock_Config();

  /* Initialize all configured peripherals */
  MX_GPIO_Init();
  MX_DMA_Init();
  MX_CAN1_Init();
  MX_TIM2_Init();
  MX_TIM4_Init();
  MX_TIM6_Init();
  MX_TIM7_Init();
  MX_USART1_UART_Init();
  MX_UART4_Init();
  MX_ADC1_Init();
  MX_DAC_Init();
  /* USER CODE BEGIN 2 */
  /* Identity first, and never again - see dipsw.h. Nothing below may read the
     pins; everything reads the latch. */
  dipsw_init();

  /* FIRST. drive_init() takes its duty cap from here and isense_init() takes
     the trip and the whole current scale, so anything that reads a config key
     must start after this line. Reported below, once the console is up. */
  config_load_t cfg_status = config_init();

  /* Assert the off state by name, rather than depending on a reader noticing
     that Pulse = 0 in generated code. */
  drive_init();
  encoder_init();
  isense_init();

  /* AFTER drive_init() and encoder_init(): it reads drive_limit() to know its
     own output ceiling and encoder_velocity_seq() to seed its freshness test.
     It comes up DISARMED - velocity_enable() is a deliberate act. */
  velocity_init();

  debug_uart_status_t uart_status = debug_uart_init();

  debug_uart_puts("\r\n\r\n=== RobertUN node - USART1 console up (115200 8N1) ===\r\n");

  if (uart_status != DEBUG_UART_OK)
  {
    debug_uart_puts("WARNING: RX not running - set USART1_RX DMA to Circular in CubeMX\r\n");
  }

  if (!can_bus_init())
  {
    debug_uart_puts("ERROR: CAN1 failed to start\r\n");
  }

  can_cmd_init();

  if (!mks_init())
  {
    debug_uart_puts("ERROR: MKS link not running - check UART4_RX DMA is Circular\r\n");
  }

  {
    uint16_t used, total;
    config_usage(&used, &total);

    debug_uart_printf("config: %s (slot %u/%u)\r\n",
                      config_load_str(cfg_status), (unsigned)used, (unsigned)total);
  }

  /* Said twice on purpose. A board silently running on defaults because its
     stored record failed a CRC looks exactly like one deliberately left at
     defaults, and the difference matters when the numbers stop adding up. */
  if ((cfg_status == CONFIG_LOAD_CORRUPT) ||
      (cfg_status == CONFIG_LOAD_VERSION) ||
      (cfg_status == CONFIG_LOAD_CLAMPED))
  {
    debug_uart_puts("WARNING: stored configuration was not usable as-is."
                    " Check 'cfg', then 'cfg save' to rewrite it.\r\n");
  }

  debug_uart_printf("module: ID %u, %s\r\n",
                    (unsigned)dipsw_id(), dipsw_role_str(dipsw_role()));

  /* The one boot line that decides whether this board is allowed on the bus.
     0b1111 is what an unfitted switch block reads, so this fires on a bare
     bench board - which is the design working, not a fault. The role text
     above already says which invalid code it is (unconfigured or broadcast). */
  if (!dipsw_valid())
  {
    debug_uart_puts("WARNING: no module identity - CAN transmit is disabled."
                    " Set DIP_SW_0..3 (PB12..PB15) to an ID 1-14.\r\n");
  }
  else
  {
    debug_uart_printf("        CAN node ID 0x%03lX\r\n",
                      (unsigned long)dipsw_can_id());
  }

  debug_uart_printf("drive: disabled (nSLEEP low, PWM 0%%, %u kHz), nFAULT=%s\r\n",
                    (unsigned)(DRIVE_PWM_HZ / 1000u),
                    drive_faulted() ? "ASSERTED" : "clear");
  debug_uart_printf("encoder: TIM2 32-bit, %.1f counts/output-rev, tick 1 kHz\r\n",
                    (double)ENCODER_COUNTS_PER_OUTPUT_REV);
  /* Both numbers, every boot. The carrier is modified — VREF is no longer
     tied to nSLEEP — so the ceiling and the trip are independent and a log
     that records only one of them cannot be interpreted later. */
  debug_uart_printf("isense: ADC1_IN2 on PA2, ceiling %u mA"
                    " (R_IPROPI %ld ohm, MODIFIED carrier)\r\n",
                    (unsigned)isense_full_scale_ma(),
                    (long)config_get(CFG_R_IPROPI_OHM));
  debug_uart_printf("vref:   DAC1_OUT1 on PA4, trip armed at %lu mA"
                    " (%u mV, buffer %s)\r\n",
                    (unsigned long)isense_trip_ma(),
                    (unsigned)isense_vref_mv(),
                    isense_vref_buffered() ? "on" : "off");

  if (isense_trip_ma() == 0u)
  {
    debug_uart_puts("WARNING: trip is 0 mA - VREF is not being driven, and the"
                    " motor will not turn.\r\n"
                    "  Check MX_DAC_Init() exists and PA4 is DAC_OUT1.\r\n");
  }

  console_init();
  /* USER CODE END 2 */

  /* Infinite loop */
  /* USER CODE BEGIN WHILE */
  while (1)
  {
    /* USER CODE END WHILE */

    /* USER CODE BEGIN 3 */
    console_poll();

    mks_poll();            /* advance the SERVO42C transaction state machine */
    motion_poll();         /* a pending ESTOP/STOP servo stop goes out here */
    steer_poll();          /* CAN steering: its own completions, queued target */
    console_report_mks();  /* print its outcome once it lands */
    console_report_encoder();  /* live counts while `enc watch on` */
    console_report_telem();    /* machine stream while `telem on`  */

    /* Heartbeat: one frame per TIM7 tick (~0.5 s), same cadence as the LED so
       the blink doubles as a visual "this node is transmitting". */
    if (heartbeat_due)
    {
      heartbeat_due = false;   /* cleared even when muted, so re-enabling
                                  waits for the next tick instead of firing
                                  on a stale flag */

      if (console_heartbeat_enabled())
      {
        static uint32_t seq;
        uint8_t payload[8];
        can_bus_err_t err;

        can_bus_errors(&err);   /* one ESR read for the frame and the log line */

        payload[0] = (uint8_t)(seq >> 24);
        payload[1] = (uint8_t)(seq >> 16);
        payload[2] = (uint8_t)(seq >> 8);
        payload[3] = (uint8_t)seq;
        payload[4] = err.tec;
        payload[5] = err.rec;
        payload[6] = err.lec;
        payload[7] = (uint8_t)((err.bus_off ? 0x04u : 0u) |
                               (err.passive ? 0x02u : 0u) |
                               (err.warning ? 0x01u : 0u));

        /* Identity gates the transmit, not just the ID. A board with no
           switches fitted would otherwise heartbeat at the base address and
           collide with module 0 - and on a six-node bus that does not present
           as "wrong ID", it presents as arbitration chaos. */
        bool sent = dipsw_valid() &&
                    can_bus_send(dipsw_can_id(), payload, sizeof(payload));
        seq++;

        /* TEC/REC and the last-error code are the on-chip equivalent of Orion's
           berr-counter — with no second node answering, expect lec=ack. */
        debug_uart_printf("hb %lu %s | tec %u rec %u lec %s%s%s%s\r\n",
                          (unsigned long)seq,
                          sent ? "queued"
                               : (dipsw_valid() ? "NO MAILBOX" : "NO ID"),
                          err.tec,
                          err.rec,
                          can_bus_lec_str(err.lec),
                          err.warning ? " WARN"    : "",
                          err.passive ? " PASSIVE" : "",
                          err.bus_off ? " BUS-OFF" : "");
      }
    }

    /* Drain anything the accept-all filter let through. The FIFO is emptied
       whether or not it is being printed — leaving frames queued would stall
       reception once all three slots fill. */
    can_frame_t rx;

    while (!console_can_hold_active() && can_bus_receive(&rx))
    {
      if (console_monitor_enabled())
      {
        debug_uart_printf("can rx %s 0x%03lX [%u] ",
                          rx.ext ? "ext" : "std",
                          (unsigned long)rx.id,
                          rx.dlc);
        debug_uart_write_hex(rx.data, rx.dlc);
        debug_uart_puts("\r\n");
      }

      can_cmd_handle(&rx);   /* W6 command layer: decode, act, answer */
    }

    can_cmd_poll();          /* pending FAULT frames, rate-limited */
  }
  /* USER CODE END 3 */
}

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
/* USER CODE BEGIN 4 */
void HAL_TIM_PeriodElapsedCallback(TIM_HandleTypeDef *htim){
  if(htim->Instance == TIM7){
      HAL_GPIO_TogglePin(LED_BLINKY_GPIO_Port, LED_BLINKY_Pin);
      heartbeat_due = true;   /* the frame itself is sent from the main loop */
  }
  else if(htim->Instance == TIM6){
      /* Sampled here rather than in the main loop on purpose: velocity is a
         difference divided by an interval, so jitter in WHEN the counter is
         read shows up directly as noise in the reading. The call reads one
         register and does integer arithmetic. */
      encoder_on_tick();

      /* nFAULT is open-drain and the driver may assert it for a few hundred
         microseconds and recover. Sampling here rather than in the main loop
         is what makes a transient visible at all: the console runs whenever it
         runs, and a fault that clears before the next `drv` leaves no trace. */
      drive_on_tick();

      /* LAST, and after drive_on_tick() specifically. The loop's output goes
         through drive_set_duty(), so it must run against a bridge whose slew
         limiter and watchdog have already advanced this tick - otherwise the
         loop reads drive_slewing() one tick stale and freezes its integrator
         at the wrong moments. It returns immediately unless the encoder's
         velocity window has closed, so it costs almost nothing 19 ticks in
         20. */
      velocity_on_tick();
  }
}
/* USER CODE END 4 */
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
