namontoy/RobertUN/firmware/projects/RobertUN_ModuleNode/RobertUN_ModuleNode.ioc

Mcu.UserName=STM32F446RETx
PA0-WKUP.Signal=UART4_TX
PA1.Signal=UART4_RX
PA10.Signal=USART1_RX
PA15.Signal=S_TIM2_CH1_ETR
PA2.Signal=ADCx_IN2
PA4.Signal=COMP_DAC1_group
PA8.Signal=RCC_MCO_1
PA9.Signal=USART1_TX
PB0.GPIO_Label=DRV_nFAULT
PB0.Signal=GPIO_Input
PB12.GPIO_Label=DIP_SW_0
PB12.Signal=GPIO_Input
PB13.GPIO_Label=DIP_SW_1
PB13.Signal=GPIO_Input
PB14.GPIO_Label=DIP_SW_2
PB14.Signal=GPIO_Input
PB15.GPIO_Label=DIP_SW_3
PB15.Signal=GPIO_Input
PB2.GPIO_Label=LED_BLINKY
PB2.Signal=GPIO_Output
PB3.Signal=S_TIM2_CH2
PB5.GPIO_Label=DRV_nSLEEP
PB5.Signal=GPIO_Output
PB6.Signal=S_TIM4_CH1
PB7.Signal=S_TIM4_CH2
PB8.Signal=CAN1_RX
PB9.Signal=CAN1_TX
PC14-OSC32_IN.Signal=RCC_OSC32_IN
PC15-OSC32_OUT.Signal=RCC_OSC32_OUT
PH0-OSC_IN.Signal=RCC_OSC_IN
PH1-OSC_OUT.Signal=RCC_OSC_OUT
