namontoy/RobertUN/firmware/projects/RobertUN_ModuleNode/Core/Inc/drive.h

/**
  ******************************************************************************
  * @file           : drive.h
  * @brief          : Drive-motor H-bridge control — TIM4 PWM + nSLEEP + nFAULT
  ******************************************************************************
  *
  * WHAT THIS IS FOR
  * ----------------
  * Owns the four pins that reach the motor driver, and nothing else. No PID,
  * no ramping, no policy — those belong above this layer, so that W5 can
  * change how the motor is commanded without touching how the bridge is
  * driven.
  *
  *     PB6  TIM4_CH1  ->  IN1 (+ IN3, paralleled)
  *     PB7  TIM4_CH2  ->  IN2 (+ IN4, paralleled)
  *     PB5  GPIO out  ->  nSLEEP     low = bridge disabled
  *     PB0  GPIO in   ->  nFAULT     open-drain, active low
  *
  *
  * DRIVER-AGNOSTIC BY DESIGN
  * -------------------------
  * The DRV8833 carrier in use today and the DRV8874 arriving ~Sep 15 share the
  * same IN1/IN2 truth table, the same active-low nSLEEP with a 1 ms wake, and
  * the same open-drain active-low nFAULT. Nothing in this module distinguishes
  * them, so the swap is a wiring change and a PMODE strap, not a firmware
  * change.
  *
  *
  * THE TRUTH TABLE, AND WHY BOTH DECAY MODES EXIST
  * -----------------------------------------------
  *     IN1  IN2   result
  *      0    0    coast   — outputs Hi-Z, current decays through the diodes
  *      1    0    forward
  *      0    1    reverse
  *      1    1    brake   — both outputs low, current recirculates
  *
  * Vendor documentation for the DRV8833 carrier calls both 00 and 11 "motor
  * off". They are not the same, and the difference is the whole reason this
  * module has a decay setting:
  *
  *   FAST decay (sign-magnitude) — PWM between drive and COAST.
  *     forward: IN1 = PWM(D), IN2 = 0
  *     Current falls quickly during the off phase, so duty maps less linearly
  *     onto speed at low duty, and ripple is larger.
  *
  *   SLOW decay (drive-brake) — PWM between drive and BRAKE.
  *     forward: IN1 = 1 (always), IN2 = PWM inverted, high for (1 - D)
  *     Current is held up by the shorted winding during the off phase. Better
  *     duty-to-speed linearity at low duty and smaller ripple, which is what a
  *     velocity PID wants. This is the default.
  *
  * Both are reachable because PB6 and PB7 are two independent PWM channels on
  * one timer. That was the reason for choosing two PWM outputs over a
  * PWM+direction pair, and it costs nothing to keep the choice open until W5
  * measures which behaves better.
  *
  *
  * ZERO DUTY IS COAST, IN BOTH MODES — AND THAT IS THE SAFE STOP
  * -------------------------------------------------------------
  * Setting duty 0 in slow-decay mode would, taken literally, mean 100% brake —
  * IN1 and IN2 both high, motor actively held. Duty 0 therefore always
  * produces coast (00) regardless of decay mode. Call drive_brake() to
  * actually brake.
  *
  * That default is not merely tidier, it is the safe one. Measured Aug 26,
  * 2026: Ke = 0.138 V/rpm at the output shaft, so a brake at speed drives
  * I = E / R_winding through the low-side FETs:
  *
  *     65 rpm -> 4.73 A        40 rpm -> 2.91 A
  *     50 rpm -> 3.64 A        20 rpm -> 1.45 A
  *
  * Braking from full speed draws essentially STALL current — above the DRV8833
  * carrier's 4 A paralleled peak — and dissipates it in the driver. Coasting
  * is a zero-current event at any speed; the residual inductive energy is
  * 1/2·L·I² = 19 uJ at 155 mA.
  *
  * **On the interim carrier, brake only below ~40 rpm.** Emergency stop should
  * be COAST, not brake: the 131.3:1 spur reduction holds the rover on any
  * slope it can climb, and if the emergency is a wiring fault then 4.7 A is
  * the worst possible current to have looking for a path.
  *
  * Note the two stops use different current LOOPS. Driving current runs out to
  * the PDB and back, so the branch return wire is inside the loop. Brake
  * current circulates locally — motor, OUT1, low-side FET, PGND, low-side FET,
  * OUT2 — and never traverses that wire. Braking is therefore less exposed to
  * the ground-loop failure mechanism, but it does put high current across the
  * board's local star point.
  *
  * The DRV8874's current regulation caps brake current at the VREF setting, so
  * the 40 rpm threshold can be lifted once it is fitted.
  *
  *
  * DUTY IS SIGNED PER-MILLE
  * ------------------------
  * -1000..+1000, sign selecting direction. Integer, so the control path never
  * needs floating point, and the resolution (0.1%) is finer than the timer's
  * 4500 steps can resolve anyway. Values outside the range are clamped, not
  * wrapped.
  *
  *
  * VERIFYING THE WAVEFORM — AND WHY TIME BEATS VOLTAGE
  * ---------------------------------------------------
  * For a rectangular wave switching between 0 and V_H at duty D:
  *
  *     V_avg = D      * V_H
  *     V_rms = sqrt(D) * V_H        (mean of v^2 is D*V_H^2, then square root)
  *
  * Rearranged, two voltmeter readings give both unknowns:
  *
  *     D    = (V_avg / V_rms)^2
  *     V_H  = V_rms^2 / V_avg       so V_rms is the geometric mean of the two
  *
  * The form factor V_rms/V_avg = 1/sqrt(D) is always >= 1 and grows as duty
  * falls — at 25% duty the RMS is twice the average.
  *
  * Both readings inherit the scope's DC gain AND offset error, though, and the
  * offset dominates at low duty where the true average is under a volt.
  * Measured on the bench Aug 26, 2026, this method returned a consistent
  * V_H of 3.08-3.25 V (correct for a 3.3 V pin) but a duty compressed toward
  * 50% — 33.5% read for 25% commanded, 75.5% for 80%.
  *
  * That compression cannot be real: CCR = duty * 4500 / 1000 is exact integer
  * division at both those points (1125 and 3600 of 4500). Cursor measurements
  * confirmed it — 12.6 us high of 50.0 us for 25%, 39.8 us of 49.8 us for 80%.
  *
  * **So measure the high TIME, not the voltage.** Timebase accuracy beats
  * vertical accuracy by orders of magnitude and is immune to offset entirely.
  * The same argument applies to frequency: the scope's counter read 19.92 kHz
  * at asymmetric duty, while the cursor period of 50.0 us gives 20.000 kHz.
  *
  * One consequence worth carrying into W5: V_avg sets the SPEED (back-EMF
  * balances the average applied voltage) while I_rms sets the HEATING. The
  * voltage form factor above looks alarming at low duty, but it does not reach
  * the winding — with L/R = 0.90 ms against a 50 us period the inductance
  * smooths the current to ~99 mA of ripple, so I_rms is very nearly I_avg.
  * That is the second, less obvious payoff of choosing 20 kHz.
  *
  *
  * nSLEEP NEEDS 1 ms
  * -----------------
  * Both drivers take up to 1 ms to wake. drive_enable() therefore BLOCKS for
  * 2 ms and must not be called from the control loop — enable once at start-up
  * or from the console, then command duty freely.
  *
  *
  * WHAT THIS MODULE DELIBERATELY DOES NOT DO
  * -----------------------------------------
  * It does not react to nFAULT. drive_faulted() is provided so the control
  * layer can act; this module never disables itself behind the caller's back.
  *
  * It DOES now slew-limit, which reverses a position this header held until
  * 2026-09-26, and the reversal is worth recording rather than quietly editing
  * away. The argument for keeping the ramp out of here was that a step from 0 to
  * full duty draws stall current — 5.0 A at the 9.5 V rail — because back-EMF is
  * zero at t=0, which is a fact about the MOTOR, so the response to it is policy
  * and policy belongs above. That is still true, and the rate still comes from
  * above; what changed is where the mechanism can physically live:
  *
  *   1. drive_set_duty() calls drive_kick(), deliberately, because a duty
  *      command is proof the caller is alive. A ramp module sitting above this
  *      one has to reach the bridge through that function, so it would refresh
  *      the command watchdog 1000 times a second forever and a dead host would
  *      never again be detected. The watchdog is the one safety property that
  *      exists specifically for the unattended case; a ramp that defeats it is a
  *      bad trade however clean the layering looks.
  *
  *   2. A limiter that any caller can go around is advisory. In here the
  *      invariant is unconditional: nothing can step the bridge, because there
  *      is no path to the CCRs that does not pass through the limiter.
  *
  * So this follows the command watchdog's split exactly — MECHANISM, NOT POLICY.
  * The rate defaults to 0, meaning step instantly, so nothing that worked before
  * behaves differently until something arms it. See the slew-limiter section
  * below.
  *
  * Ramping the velocity SETPOINT, once a loop exists, is a different thing and
  * does still belong to the control layer: limiting the setpoint is what keeps a
  * PID from winding up against its own ramp, and this module has no setpoint.
  *
  ******************************************************************************
  */
#ifndef DRIVE_H
#define DRIVE_H

#ifdef __cplusplus
extern "C" {
#endif

#include <stdbool.h>
#include <stdint.h>

/** @brief Full scale for the signed per-mille duty. */
#define DRIVE_DUTY_MAX  1000

/** @brief PWM carrier frequency, Hz — TIM4 at 90 MHz, PSC 0, ARR 4499.
  *        Chosen so that L/R = 0.90 ms is ~18x the 50 us period, which holds
  *        current ripple near 99 mA peak-to-peak. */
#define DRIVE_PWM_HZ    20000u

typedef enum
{
  DRIVE_DECAY_SLOW = 0,  /*!< drive-brake. Better low-duty linearity. Default */
  DRIVE_DECAY_FAST       /*!< sign-magnitude, PWM against coast               */
} drive_decay_t;

/**
  * @brief  Bring the driver up in its off state.
  *
  * Leaves nSLEEP low and both inputs low. Call after MX_TIM4_Init(); safe to
  * call again at any time.
  */
void drive_init(void);

/**
  * @brief  Raise nSLEEP and wait for the driver to wake.
  * @note   BLOCKS for 2 ms. Never call from the control loop.
  */
void drive_enable(void);

/** @brief Drop duty to zero, then drop nSLEEP. Order matters: the inputs reach
  *        a defined level before the bridge is torn down. */
void drive_disable(void);

/** @brief Whether nSLEEP is currently asserted high. */
bool drive_is_enabled(void);

/**
  * @brief  Command duty and direction.
  * @param  permille  -1000..+1000; clamped to that range and then to the
  *                   configured limit. 0 always produces coast.
  * @note   Does not touch nSLEEP. A non-zero duty with the driver disabled
  *         sets the pins and moves nothing, which is intentional — it lets the
  *         waveform be scoped with the bridge safely off.
  * @note   With the slew limiter armed this sets a TARGET and returns without
  *         touching the timer; the bridge arrives over the next few hundred ms.
  *         Read it back with drive_duty(), not by assuming. */
void drive_set_duty(int16_t permille);

/** @brief Duty the bridge is ACTUALLY running, after clamping and after any
  *        slew limiting. Equal to drive_duty_target() unless a ramp is in
  *        flight. This is the one telemetry prints. */
int16_t drive_duty(void);

/** @brief Both inputs high — actively brake. Duty reads back as 0. */
void drive_brake(void);

/** @brief Both inputs low — coast, outputs Hi-Z. Equivalent to duty 0. */
void drive_coast(void);

/** @brief True while nFAULT is pulled low (over-current, over-temperature or
  *        under-voltage). Note that a HIGH reading does not prove the driver
  *        is alive: with VM absent the pin floats up through the pull-up. */
bool drive_faulted(void);

/** @brief Select fast or slow decay. Takes effect on the next duty command. */
void drive_set_decay(drive_decay_t decay);

/** @brief Current decay mode. */
drive_decay_t drive_decay(void);

/**
  * @brief  Cap the magnitude of any commanded duty.
  * @param  permille  0..1000. Applied after the range clamp, so a limit of 400
  *                   turns a command of +1000 into +400.
  *
  * Exists for bench work on the interim DRV8833 carrier, whose paralleled peak
  * is 4 A against a 5.0 A stall at the 9.5 V rail. A limit of 400 keeps stall
  * current near 2 A. Defaults to no limit; set it deliberately.
  */
void drive_set_limit(uint16_t permille);

/** @brief Current duty limit, per-mille. */
uint16_t drive_limit(void);

/**
  * @brief  Sample nFAULT and latch it. Call from the 1 kHz control tick.
  *
  * OBSERVATION, NOT POLICY. This does not disable the bridge, drop the duty or
  * decide anything — the module still never acts behind the caller's back, and
  * what to DO about a fault is still W5's. All it does is make sure a fault
  * that happened leaves a mark.
  *
  * It exists because nFAULT was previously read only at boot and by the `drv`
  * command, which means an over-current that trips, auto-retries and clears
  * between two console commands is completely invisible. During a stall test
  * on a loaded wheel that is precisely the event worth knowing about, and it
  * is the one you are least likely to be looking at when it happens.
  */
void drive_on_tick(void);

/** @brief True if nFAULT has been seen low since the last clear. Sticky: it
  *        stays true after the pin recovers, which is the whole point. */
bool drive_fault_latched(void);

/** @brief Ticks (≈ms) nFAULT has been observed low since the last clear.
  *        1-2 is a glitch worth noting; hundreds is a driver shutting down
  *        and retrying. The distinction matters and costs one counter. */
uint32_t drive_fault_ticks(void);

/** @brief Duty commanded at the moment the latch first set. Answers "what were
  *        we doing when it faulted?" without a log. Zero if never latched. */
int16_t drive_fault_duty(void);

/** @brief Drop the latch. Deliberately manual — a fault record that clears
  *        itself is a fault record nobody reads. */
void drive_clear_fault(void);

/* --- Command watchdog ---------------------------------------------------- *
 *
 * MECHANISM, NOT POLICY — the same split as drive_on_tick() above. This module
 * provides a deadline and coasts when it passes; it does not decide whether
 * there is a deadline or how long it is. Disabled by default, so nothing that
 * worked before behaves differently.
 *
 * It exists because an UNATTENDED HOST is a new failure mode. A person typing
 * `drv duty 20` is themselves the watchdog — they are looking at the wheel.
 * A bench script that dies to SIGKILL, or a USB cable that falls out, leaves
 * the bridge driving at the last commanded duty indefinitely, and no amount of
 * cleanup code on the host can cover that case, because no host code runs.
 *
 * COAST, not brake, on expiry. Braking from speed drives I = E/R through the
 * low-side FETs — see the Ke table earlier in this file, where 50 rpm is 3.6 A —
 * and a dead host is precisely when nobody is watching the driver dissipate it.
 * Coasting is a zero-current event at any speed.
 * -------------------------------------------------------------------------- */

/**
  * @brief  Arm the command watchdog, and kick it.
  * @param  ms  deadline in milliseconds; 0 disables.
  *
  * Re-issuing the same value refreshes the deadline, so a host keepalive needs
  * no separate verb. Arming also clears the expiry latch, since arming is a
  * deliberate act that starts a new run.
  */
void drive_set_timeout(uint32_t ms);

/** @brief Configured watchdog period in ms; 0 when disabled. */
uint32_t drive_timeout(void);

/**
  * @brief  Refresh the deadline without changing the period.
  *
  * Called implicitly by drive_set_duty(), so a live command stream keeps itself
  * alive and only a genuinely silent host expires. Does NOT clear the expiry
  * latch — see drive_timeout_expired().
  */
void drive_kick(void);

/** @brief Milliseconds until expiry; 0 when disabled or already expired. */
uint32_t drive_timeout_remaining(void);

/**
  * @brief  True if the watchdog has expired since it was last armed.
  *
  * Sticky, and deliberately NOT cleared by drive_kick(), for the same reason
  * the fault latch is sticky: a motor that stopped itself must not be
  * indistinguishable from one that was told to stop. A host reconnecting after
  * a crash needs to be able to find out which happened. drive_set_timeout()
  * clears it.
  */
bool drive_timeout_expired(void);

/* --- Duty slew limiter --------------------------------------------------- *
 *
 * MECHANISM, NOT POLICY, like the watchdog above: a rate the caller arms, and
 * nothing more. Disabled by default.
 *
 * WHY IT EXISTS. An un-ramped duty step was tripping the 1580 mA regulation
 * limit on the loaded rig. The same 12 -> 29% move walked up at 5%/s peaked at
 * 572 mA - 2.8x headroom - measured 2026-09-25. Back-EMF opposes the applied
 * voltage, and at the instant of a step there is none, so the winding sees the
 * whole terminal voltage across 1.87 ohms. Giving the wheel time to spin up is
 * the entire trick.
 *
 * COMMANDED IS NOT APPLIED. With a rate armed, drive_set_duty() sets a TARGET
 * and returns; drive_on_tick() walks the bridge toward it. drive_duty() keeps
 * reporting what the bridge is actually running - that is what telemetry prints
 * and what the plant fits, so the ramp shows up in the data as a ramp, which is
 * how it gets measured. drive_duty_target() is the commanded value.
 *
 * THE RATE IS BOUNDED AT BOTH ENDS. Too fast and it is a step again: the plant's
 * fast pole is 0.219 s (measured two independent ways, 2026-09-25), and on the
 * rover, whose inertia is ~2.87x the rig's, it is longer still - the rig's tau
 * is a LOWER bound. Too slow and the wheel sits energised below breakaway, which
 * is stall current with no back-EMF - see drive_set_ramp_floor().
 *
 * WHAT IS NOT RAMPED, AND WHY. coast and brake are immediate. Coast is the safe
 * stop and the watchdog's action; a dead host is not the moment to ease off over
 * six seconds. Brake is an explicit act. The standing "ramp duty down before
 * braking" policy is therefore written ABOVE this module, as
 * drive_set_duty(0) -> wait for !drive_slewing() -> drive_brake(), which is what
 * drive_slewing() is for. Tightening drive_set_limit() is immediate too: it is
 * protection, not a command.
 * -------------------------------------------------------------------------- */

/**
  * @brief  Arm the slew limiter.
  * @param  permille_per_s  0..10000. 0 disables it - duty steps immediately,
  *                         which is the behaviour this module had before the
  *                         limiter existed.
  *
  * 50 (5%/s) is the rate proven on the loaded rig. Arming takes effect on the
  * next tick and does not disturb a ramp already in flight.
  *
  * DISARMING MID-RAMP HOLDS THE BRIDGE WHERE IT IS - the target is adopted from
  * the applied duty rather than the other way round. A configuration command
  * must not produce the very current step this exists to prevent.
  */
void drive_set_ramp(uint16_t permille_per_s);

/** @brief Configured slew rate, per-mille per second; 0 when disabled. */
uint16_t drive_ramp(void);

/**
  * @brief  Duty the ramp jumps straight to when leaving rest.
  * @param  permille  0..300; 0 disables the floor.
  *
  * A ramp that starts at zero crosses the whole sub-breakaway band slowly. At
  * 5%/s and a breakaway of 9-11% duty that is two seconds stalled with no
  * back-EMF, drawing 275-467 mA measured - exactly the condition the trip is
  * there to catch. So the ramp starts ABOVE breakaway and walks up from there,
  * which is what bench.py's --ramp-from did by hand.
  *
  * It applies only when departing rest, never at a zero crossing: a reversal
  * walks +200 -> -200 through zero with the wheel still turning, and a turning
  * wheel has back-EMF and does not need the floor. The jump is clipped to the
  * target, so a command smaller than the floor is not overshot.
  *
  * The right value is a property of the LOAD - about 120 on the loaded rig,
  * 60-70 on a free wheel - which is why it is set here and stored in config
  * rather than compiled in.
  */
void drive_set_ramp_floor(uint16_t permille);

/** @brief Configured ramp floor, per-mille; 0 when disabled. */
uint16_t drive_ramp_floor(void);

/** @brief Duty most recently COMMANDED, after clamping. Differs from
  *        drive_duty() only while a ramp is in flight. */
int16_t drive_duty_target(void);

/** @brief True while the applied duty has not yet reached the target. The hook
  *        for "ramp down, then brake" — see the section header. */
bool drive_slewing(void);

/* --- PWM phase, for synchronised current sampling ------------------------ *
 *
 * The bridge draws from VM for only part of each 50 us period, and with the
 * carrier's 20 kOhm IMODE strap IPROPI is BLANKED for the rest of it. A sampler
 * that free-runs across the period therefore measures I_motor x D at best - and
 * at worst aliases against the carrier and measures nothing at all. That is not
 * hypothetical: on 2026-09-14 a 1024-sample average at 13% duty returned raw 1
 * while the wheel was visibly turning under load, with raw 16 and raw 12 either
 * side of it. Averaging harder cannot fix it, because every sample lands at the
 * same wrong phase.
 *
 * The fix is to sample at a KNOWN phase instead of hoping an average covers the
 * period. This module places that trigger, because this module owns TIM4 and is
 * the only thing that knows where the drive phase sits: it moves with the duty
 * AND with the decay mode, which put it at opposite ends of the period. Slow
 * decay holds one input high and inverts the other, so the drive phase is the
 * TAIL of the period; fast decay drives from the start, so it is the HEAD.
 * isense.c owns the ADC and consumes the trigger - see isense.h.
 *
 * TIM4_CH4 raises the event. It maps to PB9, which is CAN1_TX on this board, so
 * the channel is configured and enabled but never routed to a pin: the compare
 * event is internal and the CAN pin is untouched. isense.h called this door
 * when the 28-cycle sampling time was chosen; this is it being opened.
 * -------------------------------------------------------------------------- */

/* ---------------------------------------------------------------------------
   THE SAMPLING TIMING BUDGET - MEASURED 2026-09-20
   ---------------------------------------------------------------------------
   Every number below is in TIM4 ticks: 11.11 ns at 90 MHz, 4500 to the 50 us
   period. They live here rather than in isense.h because they are properties of
   the DRIVE WINDOW, and because drive.c cannot include isense.h without a
   circular include - isense.c already includes this file.

   The settle figure is the one that was wrong for four days. The DRV8874
   datasheet quotes 1.6 us of tDELAY for IPROPI; the bench says 5.6 us. At 20%
   duty the drive edge is at tick 3600 and the reading rings through 1757, 212,
   1659, 1275 and 994 raw before going flat from tick 4100. Almost certainly the
   sense network rather than the mirror itself, but the cause does not change the
   budget - what matters is that a guard band derived from the datasheet admitted
   readings that were pure ringing, and the console reported them as current.

   Placement follows from these directly: back off the END of the window by
   APERTURE + MARGIN, and refuse any window that cannot hold all three. See
   place_trigger() in drive.c.
   --------------------------------------------------------------------------- */

/** @brief How long IPROPI takes to settle after the bridge turns on. MEASURED,
  *        5.6 us - 3.5x the datasheet tDELAY. Do not restore the datasheet
  *        figure without re-running the iscan that produced this one. */
#define DRIVE_IPROPI_SETTLE_TICKS   500u

/** @brief The ADC's sampling aperture: 28 cycles at PCLK2/4 = 22.5 MHz is
  *        1.24 us. Only the SAMPLE needs the input stable - the 12 conversion
  *        cycles that follow hold the charge - so this is the aperture, not the
  *        1.78 us full conversion. */
#define DRIVE_ADC_APERTURE_TICKS    112u

/** @brief Guard band between the end of the aperture and the falling edge.
  *        0.44 us of slop for jitter and for the settle figure being a little
  *        optimistic on some other board. */
#define DRIVE_TRIGGER_MARGIN_TICKS   40u

/** @brief Narrowest drive window that can hold a defensible sample: settle,
  *        then the aperture, then the guard. 652 ticks is 14.5% duty.
  *
  *        This replaced a floor of 192 ticks (4.3% duty) on 2026-09-20, which
  *        was derived from the aperture alone and ignored the settle entirely -
  *        so it green-lit readings whose whole window was shorter than the time
  *        IPROPI needs to be worth reading. Everything measured below ~13% duty
  *        before that date is ringing, including two figures that were recorded
  *        as real: 87 mA at 13% duty and 211 mA at 8%. */
#define DRIVE_PHASE_MIN_TICKS  (DRIVE_IPROPI_SETTLE_TICKS + \
                                DRIVE_ADC_APERTURE_TICKS + \
                                DRIVE_TRIGGER_MARGIN_TICKS)

/** @brief How long IPROPI takes to settle after the drive->brake edge. MEASURED
  *        2026-09-26, stalled iscans at 5-20% duty: ringing (1774, 854, 665,
  *        792 ...) is gone by ~1000 ticks (11 us) - twice the drive-side settle. */
#define DRIVE_DECAY_SETTLE_TICKS   1000u

/** @brief Width of the brake-phase region a spread burst averages over, ending
  *        at the end-relative trigger. The plateau slopes ~1% per 500 ticks, and
  *        the 0.690 calibration was taken near its end, so the region stays
  *        near the end rather than spanning the whole (long) brake phase. */
#define DRIVE_DECAY_SPAN_TICKS      500u

/**
  * @brief Which phase of the PWM period the ADC trigger samples.
  *
  * DRIVE - the drive phase, >= DRIVE_PHASE_MIN_TICKS wide; reads motor current
  *         1:1 (verified +0.4% against D x Vm / R, 2026-09-21).
  * DECAY - slow decay only, when the drive phase is too narrow: the brake phase,
  *         where the low-side mirror reads a FIXED FRACTION of motor current
  *         (0.690, 2026-09-26). isense.c applies the fraction and the minimum
  *         duty; this module only reports the geometry.
  * NONE  - nothing defensible to sample (coast, brake, duty 0, or a narrow
  *         drive window in fast decay, whose off phase is uncalibrated coast).
  */
typedef enum
{
  DRIVE_SENSE_NONE = 0,
  DRIVE_SENSE_DRIVE,
  DRIVE_SENSE_DECAY
} drive_sense_t;

/** @brief The phase the trigger currently samples. See drive_sense_t. */
drive_sense_t drive_sense_kind(void);

/** @brief First and last admissible trigger tick of the settled region inside
  *        the sensed phase - what a spread burst may use. Both 0 when the kind
  *        is DRIVE_SENSE_NONE. */
uint16_t drive_sense_first(void);
uint16_t drive_sense_last(void);

/**
  * @brief  Width of the drive phase, in TIM4 ticks (11.11 ns each, 4500 to the
  *         period).
  * @return 0 when there is no drive phase at all - duty 0, or braking.
  *
  * The whole timing budget above has to fit inside this. Callers compare against
  * DRIVE_PHASE_MIN_TICKS rather than assuming: at 20 kHz a 4% duty is only 2 us
  * wide, which is shorter than IPROPI takes to settle, never mind sampling it.
  */
uint16_t drive_phase_ticks(void);

/**
  * @brief  First tick of the drive phase.
  * @return 0 when there is no drive phase - check drive_phase_ticks() first.
  *
  * Slow decay drives the TAIL of the period and fast decay the head, so this is
  * not derivable from the duty alone. It is also not derivable from
  * drive_phase_trigger() any more: the trigger used to sit at the midpoint, and
  * `drv iscan` reconstructed the window as `trigger - ticks/2` from it. That
  * arithmetic broke the moment the trigger moved to the end of the window, which
  * is why this accessor exists rather than the caller doing the sum.
  */
uint16_t drive_phase_start(void);

/**
  * @brief  TIM4 count at which the ADC trigger is armed - near the END of the
  *         drive phase, or of the brake phase when drive_sense_kind() is
  *         DRIVE_SENSE_DECAY, or CCR_FULL when there is no phase to sample.
  * @note   Diagnostic. `drv current` prints it, so a reading taken at the wrong
  *         phase shows up as a number rather than being inferred from nonsense
  *         further down the line.
  */
uint16_t drive_phase_trigger(void);

/**
  * @brief  Park the ADC trigger at an arbitrary tick, ignoring the drive phase.
  * @param  tick  0..CCR_FULL; CCR_FULL means "never fire"
  *
  * DIAGNOSTIC ONLY. This deliberately breaks the invariant the rest of this
  * module exists to hold - that the trigger is inside the driven window - so
  * that the IPROPI waveform can be mapped across the whole period instead of
  * guessed at. Every ordinary CCR write reasserts the correct placement, so an
  * override survives only until the next duty, brake or coast command; call
  * drive_trigger_restore() to end it deliberately.
  */
void drive_trigger_override(uint16_t tick);

/** @brief Put the trigger back where the current duty says it belongs. */
void drive_trigger_restore(void);

#ifdef __cplusplus
}
#endif

#endif /* DRIVE_H */
