namontoy/RobertUN/firmware/projects/RobertUN_ModuleNode/tools/bench/bench.py

#!/usr/bin/env python3
"""
Bench runner for the RobertUN wheel node.

    ./bench.py list
    ./bench.py run sweep --duty 5,10,15,20,25,30 --dwell 4
    ./bench.py run sweep --dir ccw
    ./bench.py run step --rpm 20           # velocity-loop step response
    ./bench.py status                      # last run
    ./bench.py status runs/2026-...._sweep

WHY IT IS SHAPED LIKE THIS
--------------------------
The point of this tool is the run you are NOT watching. So there is no daemon
and no IPC: the runner owns the port for the duration, and everything an
observer wants is a file on disk. `status.json` is rewritten once a second and
is the cheap thing to read when checking in — one small file, rather than
tailing a CSV that is still growing.

SAFETY, IN THE ORDER IT MATTERS
-------------------------------
1. try/finally around everything, plus a SIGTERM handler, so a normal exit, an
   exception, Ctrl-C, or `kill` all end at the same stop sequence.
2. `drv timeout` armed on the board and kicked while dwelling. This is the part
   try/finally CANNOT do: SIGKILL and a yanked USB cable run no Python at all.
   The board stops itself.
3. A duty ceiling, defaulting to the rover's stated operating band.
4. Pre-flight refusal on a latched fault, rather than a run whose conditions
   were already wrong at the start.
5. Post-flight integrity: tx_dropped and seq gaps are recorded, and a run with
   either is marked SUSPECT. A stream with holes must not be quietly fitted.
"""

from __future__ import annotations

import argparse
import csv
import datetime
import json
import os
import signal
import statistics
import sys
import time

sys.path.insert(0, os.path.dirname(os.path.abspath(__file__)))
from node import Node, NodeError, Telem, Veloc  # noqa: E402

COUNTS_PER_REV = 8403.2          # TIM2 quadrature, at the output shaft
RUNS_DIR = os.path.join(os.path.dirname(os.path.abspath(__file__)), "runs")

DEFAULT_MAX_DUTY = 30.0          # percent; the rover runs slow — 30% is the stated ceiling
# The setpoint ceiling is the duty ceiling pushed through the plant fit:
# 0.7993 x 300 o/oo / 10 - 2.42 = 21.6 rpm at 30% duty. 22 is that, rounded up.
# Ask for more only the way --max-duty is asked for: explicitly.
DEFAULT_MAX_RPM = 22.0
WATCHDOG_MS = 2000
KICK_INTERVAL = 0.5
# How long after the setpoint stops moving an overshoot peak is still an
# overshoot. The loaded plant's slow pole is 2.75 s (figures/plot_plant_12v_tau.py),
# so everything the loop is going to do it has done by 3 s. The bound matters
# because the peak is a MAXIMUM: search a longer window and the +/-1 rpm
# mechanical ripple alone hands back a larger "overshoot", which would make the
# number a function of --dwell rather than of the gains.
OVERSHOOT_WINDOW_S = 3.0


class Aborted(Exception):
    """SIGTERM arrived. Exists so the finally-block stop runs for a kill the
    same way it does for Ctrl-C."""


def _on_sigterm(signum, frame):
    raise Aborted("SIGTERM")


# -- run directory ---------------------------------------------------------


class Run:
    """One run directory and the files in it."""

    def __init__(self, profile: str, args: argparse.Namespace):
        stamp = datetime.datetime.now().strftime("%Y-%m-%dT%H-%M-%S")
        self.dir = os.path.join(RUNS_DIR, f"{stamp}_{profile}")
        os.makedirs(self.dir, exist_ok=True)
        self.profile = profile
        self.args = args
        self.t0 = time.monotonic()
        self.started_iso = datetime.datetime.now().isoformat(timespec="seconds")

        self.raw = open(os.path.join(self.dir, "console.log"), "w", buffering=1)

        self._telem_f = open(os.path.join(self.dir, "telemetry.csv"), "w", newline="")
        self.telem = csv.writer(self._telem_f)
        self.telem.writerow(
            ["host_s", "seq", "board_ms", "duty_permille", "count", "mrpm", "ma", "flags"]
        )

        # The V channel gets its own file rather than more columns on
        # telemetry.csv: the two streams are sampled on different clocks (T on
        # the telem timer, V once per control step) and every committed run
        # directory holds a 7-field telemetry.csv. Joining them is the
        # analysis's job, on board_ms, and only when an analysis wants both.
        self._veloc_f = open(os.path.join(self.dir, "velocity.csv"), "w", newline="")
        self.veloc = csv.writer(self._veloc_f)
        self.veloc.writerow(
            ["host_s", "seq", "board_ms", "sp_mrpm", "meas_mrpm",
             "out", "ff", "p", "i", "d", "flags"]
        )

        self._events_f = open(os.path.join(self.dir, "events.csv"), "w", newline="")
        self.events = csv.writer(self._events_f)
        self.events.writerow(["host_s", "kind", "detail"])

        self.samples: list[Telem] = []
        self.velocs: list[Veloc] = []
        self.state = "starting"
        self._status_due = 0.0

    def elapsed(self) -> float:
        return time.monotonic() - self.t0

    def sink(self, s: Telem) -> None:
        """Called by Node for every telemetry line. Writes through to disk
        immediately AND keeps the sample, so a profile can compute a settled
        figure without re-reading its own file."""
        self.samples.append(s)
        self.telem.writerow(
            [f"{s.host_t - self.t0:.4f}", s.seq, s.ms, s.duty, s.count, s.mrpm, s.ma, s.flags]
        )

    def veloc_sink(self, v: Veloc) -> None:
        """Called by Node for every V line. Same contract as sink(): written
        through immediately, and kept so a profile can compute its metrics
        without re-reading its own file."""
        self.velocs.append(v)
        self.veloc.writerow(
            [f"{v.host_t - self.t0:.4f}", v.seq, v.ms, v.sp_mrpm, v.meas_mrpm,
             v.out, v.ff, v.p, v.i, v.d, v.flags]
        )

    def event(self, kind: str, detail: str = "") -> None:
        self.events.writerow([f"{self.elapsed():.4f}", kind, detail])
        self._events_f.flush()

    def write_meta(self, meta: dict) -> None:
        with open(os.path.join(self.dir, "meta.json"), "w") as f:
            json.dump(meta, f, indent=2)

    def write_status(self, node: Node, force: bool = False, **extra) -> None:
        """Rewritten once a second. Deliberately tiny — this is what gets read
        by someone checking in mid-run."""
        now = time.monotonic()
        if not force and now < self._status_due:
            return
        self._status_due = now + 1.0

        last = self.samples[-1] if self.samples else None
        status = {
            "profile": self.profile,
            "state": self.state,
            "elapsed_s": round(self.elapsed(), 1),
            "samples": node.telem_count,
            "seq_gaps": node.telem_gaps,
            "echo_mismatches": node.echo_mismatches,
            "veloc_samples": node.veloc_count,
            "veloc_gaps": node.veloc_gaps,
            "veloc_steps_missed": node.veloc_steps_missed,
            "last": None
            if last is None
            else {
                "duty_pct": last.duty_pct,
                "rpm_filtered": last.rpm,
                "mA": last.ma,
                "count": last.count,
                "sync": last.sync,
                "fault": last.fault,
                "saturated": last.saturated,
                "watchdog_expired": last.watchdog,
            },
        }
        status.update(extra)
        # Flush the telemetry buffer on the same beat. A SIGKILL runs no Python,
        # so whatever is still sitting in stdio is lost; at 8 kB of default
        # buffering that was ~2 s of samples. console.log is line-buffered and
        # keeps them regardless, but the CSV should not need recovering from it.
        self._telem_f.flush()
        self._veloc_f.flush()
        # Write-then-rename, so a reader never catches a half-written file.
        tmp = os.path.join(self.dir, "status.json.tmp")
        with open(tmp, "w") as f:
            json.dump(status, f, indent=2)
        os.replace(tmp, os.path.join(self.dir, "status.json"))

    def close(self) -> None:
        self._telem_f.flush()
        self._telem_f.close()
        self._veloc_f.flush()
        self._veloc_f.close()
        self._events_f.close()
        self.raw.close()


# -- shared mechanics ------------------------------------------------------


def dwell(node: Node, run: Run, seconds: float, vel_kick: int | None = None,
          **status_extra) -> None:
    """Spend time. Pumps the serial link, kicks the board watchdogs, and keeps
    status.json current. Never time.sleep() alone — that would let the OS
    buffer fill and destroy the arrival timing of everything in the gap.

    `vel_kick` is the current setpoint in MILLI-rpm, and must be passed for
    every dwell taken with the velocity loop armed. The loop carries its own
    setpoint watchdog (`vel_tmo`, 1000 ms by default) and **only `vel target`
    refreshes it** — `drv timeout` kicks the layer below and does nothing for
    it. Without this a 6 s dwell coasts the wheel one second in, in the middle
    of the measurement, and the data looks like a plant that cannot hold speed.
    """
    end = time.monotonic() + seconds
    next_kick = time.monotonic() + KICK_INTERVAL
    while True:
        node.pump()
        now = time.monotonic()
        if now >= end:
            break
        if now >= next_kick:
            node.command(f"drv timeout {WATCHDOG_MS}", timeout=1.0)
            if vel_kick is not None:
                # Re-commanding the same setpoint is a no-op to the loop other
                # than refreshing the countdown: velocity_set_setpoint() writes the
                # target and refreshes the countdown, and touches nothing else.
                node.command(f"vel target {vel_kick}m", timeout=1.0)
            next_kick = now + KICK_INTERVAL
        run.write_status(node, **status_extra)
        time.sleep(0.002)


def ramp(node: Node, run: Run, start: float, end: float, rate: float,
         hold_s: float = 0.0) -> None:
    """Walk duty from `start` to `end` at `rate` percent per second.

    A host-side stand-in for the firmware slew-rate limiter, which is still
    owed. Two honest limitations: `drv duty` takes integer PERCENT, so the
    finest available step is 1% and this is a staircase rather than a ramp;
    and each step costs a console round-trip, so the achieved rate is a little
    slower than the one asked for. The firmware could do both properly on the
    1 kHz tick at per-mille resolution.

    It exists because a step to a high duty from rest demands 12 V / 1.87 Ohm
    at the instant of the step, which is what fired the trip on every duty step
    in the Sep 23 session.

    `start` is stepped to directly and held: below breakaway the wheel does not
    move at all, so there is nothing for a ramp to do down there — it has to be
    crossed in one step, and then the ramp begins from a turning wheel.

    Telemetry through the ramp is recorded like any other. A ramp slow against
    the mechanical time constant is a quasi-static sweep in its own right, and
    can be read back against the settled points.
    """
    run.state = f"ramp {start:+.0f}% -> {end:+.0f}%"
    node.command(f"drv duty {int(round(start))}")
    run.event("ramp_start", f"{start:+.0f} -> {end:+.0f} @ {rate:g}%/s")
    if hold_s > 0:
        dwell(node, run, hold_s, point=f"ramp hold {start:+.0f}%")

    d, target = int(round(start)), int(round(end))
    step = 1 if target >= d else -1
    interval = 1.0 / rate if rate > 0 else 0.0
    while d != target:
        d += step
        node.command(f"drv duty {d}")
        if interval:
            dwell(node, run, interval, point=f"ramp {d:+.0f}%")
    run.event("ramp_end", f"{end:+.0f}")


def rpm_from_counts(samples: list[Telem]) -> float | None:
    """Velocity by least-squares slope of count against board time.

    `count` is the real measurement: exact and unfiltered. The `mrpm` column is
    a boxcar average over `enc window` ticks and lags the truth, so fitting it
    would partly measure the filter. Board `ms` is used rather than host arrival
    time because it is stamped at emission, before any USB or OS latency.
    """
    pts = [(s.ms, s.count) for s in samples]
    if len(pts) < 3:
        return None
    n = len(pts)
    mt = sum(p[0] for p in pts) / n
    mc = sum(p[1] for p in pts) / n
    num = sum((t - mt) * (c - mc) for t, c in pts)
    den = sum((t - mt) ** 2 for t, c in pts)
    if den == 0:
        return None
    counts_per_ms = num / den
    return counts_per_ms * 1000.0 * 60.0 / COUNTS_PER_REV


def preflight(node: Node, run: Run, expect_duty_zero: bool = True) -> dict:
    """Record the conditions rather than trusting them, and refuse to start on
    a latched fault.

    The fault check reads the telemetry `flags` bit instead of parsing the human
    `drv` text — the bit is defined by the line format this tool owns, so it
    cannot drift with a wording change in console.c.

    THE ORDER HERE IS THE WHOLE POINT. drive_faulted() reads the nFAULT pin
    directly, and the DRV8874 holds nFAULT low the entire time nSLEEP is low.
    So a freshly reset board ALWAYS reports a latched fault, and a check made
    before waking the driver would refuse every run on an artifact. Wake it,
    clear the latch, and only then look: a fault that re-asserts while the
    driver is awake and the duty is zero is a real one.
    """
    node.command("monitor off")      # CAN frame lines would interleave
    node.command("heartbeat off")

    conditions = {name: node.ask(name) for name in ("info", "cfg", "drv", "enc")}
    run.event("preflight", "captured info/cfg/drv/enc")

    node.command("drv enable")
    node.command("drv clearfault")
    run.event("preflight", "driver awake, fault latch cleared")

    node.command("telem rate 10")
    node.command("telem on")
    dwell_end = time.monotonic() + 0.8
    while time.monotonic() < dwell_end:
        node.pump()
        time.sleep(0.002)
    node.command("telem off")

    if not run.samples:
        raise NodeError(
            "no telemetry received during pre-flight. Either the firmware "
            "predates the `telem` command (reflash needed) or RX is not getting "
            "through."
        )
    s = run.samples[-1]
    if s.fault:
        raise NodeError(
            "nFAULT re-asserted with the driver awake and the duty at zero. "
            "That is a real fault, not the sleep-mode artifact — find out why "
            "before running. A run started into a fault produces data whose "
            "conditions were already wrong."
        )
    if expect_duty_zero and s.duty != 0:
        raise NodeError(f"motor is already commanded to {s.duty_pct:+.1f}% — stop it first.")

    run.samples.clear()             # pre-flight samples are not run data
    run.velocs.clear()
    return conditions


# -- profiles --------------------------------------------------------------


def profile_sweep(node: Node, run: Run, a: argparse.Namespace) -> dict:
    """Duty list, dwell at each, record settled speed and current.

    This is the task-17 table, automated — and it is how the CCW direction gets
    taken. Its acceptance test is that its CW numbers reproduce the hand-taken
    Sep 23 table.
    """
    duties = [float(x) for x in a.duty.split(",")]
    sign = -1.0 if a.dir == "ccw" else 1.0

    over = [d for d in duties if abs(d) > a.max_duty]
    if a.ramp_from is not None and abs(a.ramp_from) > a.max_duty:
        over.append(a.ramp_from)
    if over:
        raise NodeError(
            f"duty {over} exceeds the {a.max_duty:.0f}% ceiling. Raise it "
            f"explicitly with --max-duty if that is really intended."
        )

    window = 100 if a.window is None else a.window
    a.window = window               # so meta.json records what actually ran
    node.command(f"enc window {window}")
    # The boot default is 999 mA, which is BELOW the from-rest stall current
    # (12 V / 1.87 Ohm = 6.4 A demanded at the instant of a step), so current
    # regulation would chop every breakaway. Set it explicitly and record it,
    # rather than depending on whatever the last session left in RAM.
    node.command(f"drv trip {a.trip}")
    node.command(f"drv timeout {WATCHDOG_MS}")
    node.command("drv decay slow")   # the driver was woken during pre-flight
    node.command(f"telem rate {a.rate}")
    node.command("telem on")
    run.event("telem_on", f"{a.rate} Hz")

    # The entry ramp runs after `telem on`, so the ramp is in the data rather
    # than in the gap before it.
    if a.ramp_from is not None:
        ramp(node, run, sign * a.ramp_from, sign * duties[0], a.ramp, hold_s=1.0)

    results = []
    for duty in duties:
        commanded = sign * duty
        run.state = f"duty {commanded:+.1f}%"
        # `drv duty <n>p` commands per-mille directly, so fractional percent
        # duties (0.1% resolution) reach drive_set_duty() unrounded.
        node.command(f"drv duty {int(round(commanded * 10))}p")
        run.event("duty", f"{commanded:+.1f}")

        mark = len(run.samples)
        dwell(node, run, a.dwell, point=f"{commanded:+.1f}%")

        # Fit only the settled tail. The leading fraction is the transient,
        # and including it would bias the slope low on every ascending step.
        window = run.samples[mark:]
        tail = window[int(len(window) * a.settle):]
        rpm = rpm_from_counts(tail)
        ma = [s.ma for s in tail]
        sync = all(s.sync for s in tail) if tail else False

        row = {
            "duty_pct": commanded,
            "rpm": None if rpm is None else round(rpm, 3),
            "rpm_filtered": round(sum(s.rpm for s in tail) / len(tail), 3) if tail else None,
            "mA_mean": round(sum(ma) / len(ma), 1) if ma else None,
            "mA_min": min(ma) if ma else None,
            "mA_max": max(ma) if ma else None,
            # Below 14.5% duty the phase-synchronised window does not exist, so
            # the current figure is supply current, not motor current. Recorded
            # per point because it changes partway up any sweep that starts low.
            "current_is_motor": sync,
            "samples": len(tail),
        }
        results.append(row)
        run.event("point", json.dumps(row))
        print(
            f"  {commanded:+6.1f}%  {row['rpm'] if row['rpm'] is not None else float('nan'):7.2f} rpm"
            f"  {row['mA_mean']:6.1f} mA  {'Imot' if sync else 'Isup'}  n={row['samples']}"
        )

    run.state = "stopping"
    # The braking half. safe_stop() in the runner's finally block stays a hard
    # stop on purpose — that is the emergency path, and it must not be slow.
    if a.ramp and duties:
        ramp(node, run, sign * duties[-1], 0.0, a.ramp)
    node.command("drv duty 0")
    node.command("telem off")

    with open(os.path.join(run.dir, "sweep.csv"), "w", newline="") as f:
        w = csv.DictWriter(f, fieldnames=list(results[0].keys()))
        w.writeheader()
        w.writerows(results)

    return {"points": results}


def step_metrics(rows: list[Veloc], from_rpm: float, to_rpm: float) -> dict:
    """Reduce one step segment to the four numbers a tuning decision is made
    from, plus the three that say whether those numbers mean anything.

    READ THE CAVEAT BEFORE READING THE NUMBERS. Every timing here is computed
    from `meas_mrpm`, which is encoder_rpm() — the boxcar over `enc window`
    ticks. That is deliberate: it is what the controller actually saw and acted
    on, so these figures describe the closed loop as the loop experienced it,
    which is the right frame for choosing gains. It is NOT the frame for a
    plant time constant: the same warning that governs rpm_from_counts() applies
    with more force inside a loop, because the filter's lag is now inside the
    feedback path. Plant-side timing comes from the T rows and `count`.

    Time is board `ms`, relative to the first row after the step command, so
    host scheduling and USB latency are outside every figure below.

    THE SLEW ANCHOR — why overshoot and settling are not measured from the
    command. `vel_slew` ramps the SETPOINT, and it ships at 4 rpm/s, so a
    0 -> 10 rpm "step" spends its first 2.5 s with the loop tracking a moving
    target. Nothing in that window is a step response: there is no step for the
    loop to overshoot, and a rise time measured across it is a division of the
    step size by the slew rate with the controller barely involved. The first
    version of this function anchored everything at the command instant and so
    reported the slew limiter's properties under the loop's name — a 0 -> 10 rpm
    step returned "rise 2.0 s" no matter what Kp was, which is the tell.

    So the segment is split at the instant the RAMPING flag clears, which is
    when the setpoint stops moving and the loop is first regulating to a fixed
    number:

      during the ramp   `track_lag_rpm` — how far behind the moving setpoint
                        the loop runs. This is the real measure of loop
                        bandwidth when a ramp is in force, and it is the same
                        estimator the Sep 25 tau figure used on the entry ramp.
      after the ramp    `overshoot_pct`, `settle_s` — anchored at ramp end,
                        because that is the only part that is a regulation
                        problem.

    `rise_s` is still reported from the command instant, because that is the
    conventional definition and it is a true statement about the response. It
    is reported NEXT TO `rise_slew_floor_s`, the rise time the ramp alone would
    produce against an infinitely fast loop: when the two are close, `rise_s`
    measured the ramp, and `ramp_limited` says so outright rather than leaving
    it to be noticed. Run with `--slew 0` to measure the loop's own rise.
    """
    out: dict = {
        "from_rpm": round(from_rpm, 3),
        "to_rpm": round(to_rpm, 3),
        "samples": len(rows),
    }
    if not rows:
        return out

    t0 = rows[0].ms
    t = [(r.ms - t0) / 1000.0 for r in rows]
    y = [r.meas_rpm for r in rows]
    change = to_rpm - from_rpm
    sign = 1.0 if change >= 0 else -1.0

    # Health of the segment first. These are fractions of the steps taken, and
    # they are what says whether the timing figures are describing the
    # controller or describing something that got in its way.
    n = float(len(rows))
    frozen = [r for r in rows if r.frozen]
    out["sat_fraction"] = round(sum(1 for r in rows if r.saturated) / n, 4)
    out["freeze_fraction"] = round(len(frozen) / n, 4)
    # Split by reason, because they want opposite corrections. Anti-windup
    # freezing under saturation is the mechanism working; freezing because the
    # bridge is unavailable or drv's own slew limiter is active means the run
    # measured the obstruction, not the loop.
    out["freeze_antiwindup"] = round(
        sum(1 for r in frozen if not r.slewing and not r.nobridge) / n, 4)
    out["freeze_drv_slewing"] = round(sum(1 for r in frozen if r.slewing) / n, 4)
    out["freeze_no_bridge"] = round(sum(1 for r in frozen if r.nobridge) / n, 4)
    out["watchdog_expired"] = any(r.watchdog for r in rows)
    out["steps_missed"] = sum(1 for r in rows if r.missed)

    # The settled tail: the last quarter of the segment.
    tail = rows[int(len(rows) * 0.75):] or rows[-1:]
    mean_tail = sum(r.meas_rpm for r in tail) / len(tail)
    out["final_rpm"] = round(mean_tail, 3)
    out["ss_error_rpm"] = round(mean_tail - to_rpm, 3)
    # How much the integrator is carrying once everything has settled is how
    # much the feedforward missed by, in the units the output is written in.
    # A large steady i with a small ss error means ff_a/ff_b want re-fitting,
    # not that Ki wants raising.
    out["i_at_rest_permille"] = round(sum(r.i for r in tail) / len(tail), 1)
    out["ff_at_rest_permille"] = round(sum(r.ff for r in tail) / len(tail), 1)
    out["out_at_rest_permille"] = round(sum(r.out for r in tail) / len(tail), 1)
    # The noise the overshoot figure has to be judged against. On this rig it is
    # ~1 rpm of mechanical ripple at 12 events per output revolution, which is
    # not the loop's doing and must not be read as the loop's overshoot.
    if len(tail) > 1:
        m = sum(r.meas_rpm for r in tail) / len(tail)
        out["tail_sd_rpm"] = round(
            (sum((r.meas_rpm - m) ** 2 for r in tail) / len(tail)) ** 0.5, 3)
    else:
        out["tail_sd_rpm"] = None

    # -- the slew anchor -----------------------------------------------------
    # Where the commanded setpoint stopped moving. The firmware says so
    # directly via VFLAG_RAMPING, which is better than comparing sp to target
    # here: the flag is set by the same code that does the ramping, so it
    # cannot disagree with it the way a host-side epsilon can.
    ramp_rows = [i for i, r in enumerate(rows) if r.ramping]
    if ramp_rows:
        i0, i1 = ramp_rows[0], min(ramp_rows[-1] + 1, len(rows) - 1)
        out["ramp_s"] = round(t[i1] - t[i0], 4)
        dt = t[i1] - t[i0]
        out["slew_rpm_s"] = (round((rows[i1].sp_rpm - rows[i0].sp_rpm) / dt, 3)
                             if dt > 1e-9 else None)
        # Skip the first fifth of the ramp: the lag needs roughly a plant time
        # constant to reach the constant value the estimator assumes, and
        # averaging the approach into it biases the answer low.
        lag_rows = rows[i0 + max(1, (i1 - i0) // 5):i1 + 1]
        out["track_lag_rpm"] = (
            round(sum(sign * (r.sp_rpm - r.meas_rpm) for r in lag_rows)
                  / len(lag_rows), 4) if len(lag_rows) >= 5 else None)
    else:
        i1 = 0
        out["ramp_s"] = 0.0
        out["slew_rpm_s"] = None
        out["track_lag_rpm"] = None
    out["anchor_s"] = round(t[i1], 4)

    if abs(change) < 1e-6:
        # A zero-magnitude step — `--rpm 0` from rest, which is the parser and
        # plumbing check. There is no rise time or overshoot to report, and
        # inventing one from noise would be worse than saying so.
        return out

    def first_at(frac: float) -> float | None:
        level = from_rpm + frac * change
        for ti, yi in zip(t, y):
            if sign * (yi - level) >= 0.0:
                return ti
        return None

    t10, t90 = first_at(0.10), first_at(0.90)
    out["t10_s"] = None if t10 is None else round(t10, 4)
    out["t90_s"] = None if t90 is None else round(t90, 4)
    out["rise_s"] = None if (t10 is None or t90 is None) else round(t90 - t10, 4)

    # What the ramp alone costs: the commanded setpoint's own 10->90% time. A
    # loop with infinite bandwidth cannot beat this, so a `rise_s` near it is a
    # measurement of `vel_slew` wearing the loop's name.
    floor = 0.8 * out["ramp_s"]
    out["rise_slew_floor_s"] = round(floor, 4)
    out["ramp_limited"] = bool(floor > 1e-6 and out["rise_s"] is not None
                               and out["rise_s"] < 1.3 * floor)

    # -- regulation, measured from the anchor --------------------------------
    after = rows[i1:]
    ta = [(r.ms - rows[i1].ms) / 1000.0 for r in after]
    ya = [r.meas_rpm for r in after]

    wt = [(tv, v) for tv, v in zip(ta, ya) if tv <= OVERSHOOT_WINDOW_S] or \
         list(zip(ta[:1], ya[:1]))
    peak = max((v for _, v in wt), key=lambda v: sign * v)
    out["peak_rpm"] = round(peak, 3)
    out["overshoot_rpm"] = round(max(0.0, sign * (peak - to_rpm)), 3)
    out["overshoot_pct"] = round(out["overshoot_rpm"] / abs(change) * 100.0, 2)
    # A maximum over a SHORTER window is a smaller maximum. If --dwell did not
    # leave OVERSHOOT_WINDOW_S of data after the ramp, this run's overshoot is
    # not comparable with one that did, and saying which window was actually
    # searched is the only way a reader can tell.
    out["overshoot_window_s"] = round(wt[-1][0], 3)
    # Truncated means the DATA ran out early enough to matter, not that the
    # last sample landed at 2.98 s instead of 3.00. A 50 Hz stream never has a
    # sample exactly on the boundary, so the test allows one control period —
    # otherwise every run in existence is flagged and the flag means nothing.
    period = (ta[-1] - ta[0]) / max(1, len(ta) - 1)
    out["overshoot_window_truncated"] = bool(
        ta[-1] < OVERSHOOT_WINDOW_S - 2.0 * period)
    # A single maximum drawn from a rippling signal overshoots by construction.
    # The peak has to beat the settled tail's OWN worst excursion in the same
    # direction, plus one encoder count, before it is the controller's. The
    # first version compared it with 2 sd of the tail, which assumes the ripple
    # is roughly Gaussian — it is not: the 12-per-rev feature is a train of
    # sharp dips whose extremes sit well past 2 sd, so every down-step was
    # flagged for a dip the settled hold also shows (Sep 26, runs 19-31-06 and
    # 19-32-19: flagged minima one count from the tail's own). Comparing like
    # with like — an extreme against an extreme — is what separates "14%
    # overshoot, lower Kp" from "no overshoot resolvable on this rig".
    tail_exc = max(sign * (r.meas_rpm - to_rpm) for r in tail)
    out["tail_excursion_rpm"] = round(max(0.0, tail_exc), 3)
    quantum = 60000.0 / (COUNTS_PER_REV * 20.0)
    out["overshoot_above_ripple"] = (
        None if len(tail) < 2
        else bool(out["overshoot_rpm"] > out["tail_excursion_rpm"] + quantum))
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
