namontoy/RobertUN/(commit log)

2025-12-18 Board Kicad
    [BoardRover2.kicad_pcb, BoardRover2.kicad_sch]
2025-12-18 LED Y FUSIL
    [BoardRover2-B_Cu.gbr, BoardRover2-B_Mask.gbr, BoardRover2-B_Paste.gbr, BoardRover2-B_Silkscreen.gbr, BoardRover2-Edge_Cuts.gbr, BoardRover2-F_Cu.gbr, BoardRover2-F_Mask.gbr, BoardRover2-F_Paste.gbr]
2026-01-29 doble board y correxion
    [BoardRover2-B_Cu.gbr, BoardRover2-B_Mask.gbr, BoardRover2-B_Paste.gbr, BoardRover2-B_Silkscreen.gbr, BoardRover2-Edge_Cuts.gbr, BoardRover2-F_Cu.gbr, BoardRover2-F_Mask.gbr, BoardRover2-F_Paste.gbr]
2026-04-02 Add development environment context document for Dell, IsaacUN and Jetson setup
2026-04-02 Add initial development environment context - Dell laptop + Jetson setup (March 25, 2026)
2026-04-02 Add CAN bus research document - Jetson Orin Nano hardware and software guide
2026-04-02 Network update - gigabit switch installed, static Ethernet IPs, DDS over wired (April 2, 2026)
2026-04-03 ZED 2i camera fully operational - USB 3.00 verified, depth pipeline confirmed (April 2, 2026)
2026-04-04 ZED 2i camera fully operational - USB 3.00 verified, ZED ROS2 Wrapper installed (April 3, 2026)
2026-04-04 Add ZED SDK headers to Dev Container for IntelliSense support
    - Install ZED SDK 5.2.2 headers-only in Dev Container (ubuntu22/cu12)
    - Fix permissions: chmod a+rX on /usr/local/zed and /usr/local/zed/include
    - IntelliSense now resolves sl::Camera, sl::Mat, sl::InitParameters etc.
    - Add Cyclone DDS loopback peer (127.0.0.1) to host and devcontainer configs
2026-04-04 Update project_context and new file about ZED2i - Jetson - ROS2 (April 3, 2026)
2026-04-06 Update project_context - updating CAN bus ideas - CANopen OSI Layer (April 5, 2026)
2026-04-08 Actualizando el archivo .gitignore
2026-04-08 Actualizando documentacion: carpeta de comandos utlizados en linx, carpeta con documentos de desarrollo de otros Rocker-Bogie, carpeta con imagens que sirven de guia
2026-05-29 Archivos relacionados con la tarjeta xavier para analizar cual es el mejor modelo
2026-05-29 actualizacion del context y agregando el log de comandos del trabajo realizado con la xavier
2026-08-04 documentos relacionados con CAN bus: paginas importantes, proyectos de ejemplo, info sobre CANopen
2026-08-05 Actualizando el contexto con info de Forge y pruebas preliminares al CAN-bus en Orion
2026-08-07 Actualizancon del contexto, el CAN-Bus funciona por primera vez entre Orion y Deadelus
2026-08-07 Incluyendo las pruebas de torque de los motores de giro, que fue realizada el 8 de junio y no se incluyó en ese momento
2026-08-07 Corrigiendo una apresiación sobre la direccion de los motores stepper para el giro de las 4 ruedas de las esquinas. Es el mismo firmware para todas
2026-08-09 Iniciando la semana 2 del roadmap (phase 1). Se Configura el ambiente VScode para hacer el desarrollo del proyecto.
2026-08-11 Avances en la semana 2, el firmware básico del nodo está funcionando, pero hace falta preparar la conexion
2026-08-11 Semana 2 completa, se han realizado hasta pruebas de estres, todo parece funcionar con tres nodos: MCU, Orion, Deadelus
2026-08-11 Semana 2 completa. Agregando la informacion de las pruebas realizadas y de algunos temas pendiente para resolver a medida que se desarrolla el equipo.
2026-08-16 week 3 firmware working on test bench. Circuit on breadboard but with considerations for avoiding ground-loops
2026-08-16 Actualizando la forma como esta el resumen-log de los avances realizados dia a dia, ahora con bulle-points por cada dia reportado
2026-08-16 firmware: import module node firmware as RobertUN_ModuleNode
    The STM32F446 firmware started as a throwaway bench test called
    "Testing_F446RE_VScode" and lived outside version control for three
    weeks. After W2 (CAN bring-up) and W3 (MKS SERVO42C UART) it is now the
    real thing, so it moves into the repo under its own name.
    One binary serves all six modules - four steering corners and two centre
    drive modules - with identity coming from DIP switches at runtime, so the
    name deliberately says "ModuleNode" rather than "corner".
    Renamed in five places only: the .ioc filename, ProjectManager.ProjectName
    and .ProjectFileName inside it, CMAKE_PROJECT_NAME, and the .elf path in
    launch.json. Everythin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
2026-08-16 docs: track the roadmap, and close W3
    The roadmap was the last major artefact outside version control - it was
    being backed up by hand as roadmap.bak2 / roadmap.bak3, which is version
    control with worse ergonomics. It now lives in docs/, with a symlink left
    at the old ~/1_RoverUN/ path so existing references keep working.
    Also fixes a contradiction it had been carrying: the W3 row said its
    acceptance criterion was MET on Aug 13, while the status marker still said
    in-progress. W3 is now closed, on the same terms W1 and W2 were closed.
    The two items that were blocking it are not part of W3's criterion, which
    says bench test, single motor, no CAN. Both are re-homed to the week that
    actually o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
2026-08-16 docs(roadmap): record the real grounding answer in the W3 record
    Replaces the italic placeholder that asked what the specific measure was.
    The answer is the POWER DISTRIBUTION & GROUNDING section added to
    PROJECT_CONTEXT.md on Aug 14.
    Corrects one thing the W3 record implied: ground is deliberately shared,
    not avoided. The UART link is single-ended and has no valid signal
    reference without it, and MKS's own reference wiring ties STM32 GND to the
    12V supply negative. What is avoided is a SECOND ground path, not the
    first one.
    Pulls forward the two findings that change bench practice immediately -
    the power-sequencing rule and the no-back-powering rule - since both apply
    to the breadboard no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
2026-08-16 docs(roadmap): add hardware track HW1-HW4 parallel to W4-W7
    The roadmap described only firmware and bring-up. W7 assumes six populated
    node boards with DIP switches exist, but nothing in the plan produced them
    - that work lived only as item 16 of PROJECT_CONTEXT's NEXT TASKS.
    Boards are milled in-house on the ANT CNC, so there is no fab queue and no
    shipping wait. The schedule driver is replication effort instead: seven
    node boards plus a PDB to mill, populate and test by hand. The track
    mirrors the roadmap's own build order - HW3 proves one reference board
    during W6 integration, HW4 replicates it.
    The node PCB is a carrier, not an MCU board: the STM32 stays on the WeAct
    module, so the har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
2026-08-16 docs: record drive motor + DRV8833, and flag the 10.8V rail conflict
    Drive hardware is settled and in hand: 7x CQRobot DC geared motor with
    encoder (6V/12V, 131.3:1) and a commercial DRV8833 breakout per motor with
    both H-bridges paralleled. The driver is off-board, like steering's MKS, so
    the node PCB stays a carrier and HW1 no longer inherits W4/W5 risk.
    Two corrections that came out of checking the TI datasheet:
    1. The DRV8833's operating VM range is 2.7-10.8 V. The PDB branch rail is
    planned at 13-13.5 V to pre-compensate wire drop against the SERVO42C's
    12 V floor. The rail is above the driver's absolute maximum, so it cannot
    reach the DRV8833 directly. Recommended fix is a s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
2026-08-25 docs: commission lycus — second Orin Nano, ZED SDK 5.2.3, install guide
    Record the Aug 17 lycus commissioning in PROJECT_CONTEXT.md: SD-card boot
    with a 120GB SATA SSD at /data (the ASM1166 M.2-to-SATA adapter cannot be a
    boot target — SDK Manager fails its "nvme unavailable" check at ~18%), CUDA
    12.6, ROS 2 Humble with three-way Cyclone DDS peering across daedalus/orion/
    lycus, and ZED SDK 5.2.3 + zed-ros2-wrapper validated against real hardware.
    Two traps captured: a libusb-1.0-0 downgrade that segfaulted ZED_Diagnostic's
    USB enumeration, root-caused to the jammy-updates pocket missing from this
    board's apt sources; and MAXN_SUPER as a third nvpmodel mode, so -m 0 is 15W
    rather than m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
2026-08-25 docs: record the W4 pin allocation and characterise the DRV8833 carrier
    Pin map for the module node is settled and building clean. New PIN ALLOCATION
    section carries the full table plus the reasoning that is expensive to
    rediscover: encoder mode is CH1+CH2 only in silicon, which ruled out PA2/PA3;
    TIM2 and TIM5 are the only 32-bit counters and TIM5's CH1/CH2 are already the
    SERVO42C UART, so TIM2 on PA15/PB3 was the only route to a 32-bit encoder;
    PA5/PA6/PA7 and PB10/PB11 are held free for SPI1 and I2C2. Heartbeat moved
    TIM3 -> TIM7 to free the encoder interface, then the encoder moved again to
    TIM2 — rollover horizon 11.3 -> ~743,000 output revolutions.
    DRV8833 carrier characterised fro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
2026-08-25 firmware(W4): TIM2 encoder, TIM4 PWM, DRV8833 pins initialised disabled
    Opens W4 on the module node. Three peripheral changes plus the DRV8833
    safe-state handling.
    Heartbeat moved TIM3 -> TIM7. TIM7 is a basic timer on the same APB1 clock, so
    prescaler 1800 / period 25000 carry over unchanged at ~0.5 s. Being a basic
    timer it has no clock-source select and no CKD, so HAL_TIM_ConfigClockSource()
    is dropped — it would fail its IS_TIM_CLOCKSOURCE_INSTANCE check on TIM7. This
    frees TIM3's encoder interface, though the encoder ultimately went elsewhere.
    Encoder on TIM2 (PA15/PB3, AF1) in TIM_ENCODERMODE_TI12, period 0xFFFFFFFF.
    TIM2 is one of only two 32-bit counters on this part and TIM5's C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
    [RobertUN_ModuleNode.ioc, main.c, main.h]
2026-08-25 docs(W4): require scope verification of the PWM before a motor is connected
    Adds the bring-up gate that was missing from the W4 plan: the motor is the
    last thing wired, not the first. The PWM gets driven from new `drv` console
    commands and verified on a scope with nothing attached — frequency (which
    also catches a wrong APB1 timer-clock assumption, since a x2 error shows as
    10 or 40 kHz), duty linearity, channel alignment, the waveform pair for the
    chosen drive scheme, direction reversal, and that disable returns both pins
    to 0 V and drops nSLEEP.
    The `drv` commands follow the existing `mks <sub>` pattern in console.c, for
    the same reason that module exists: the probe is an ST-Link/V2 wit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
2026-08-25 docs(research): capture the drive motor and DRV8833 carrier source pages
    Two new reference documents under docs/research/drive-motor/, each carrying
    the vendor content verbatim plus a clearly separated derived section.
    The motor spec overturns a recorded assumption: the encoder is 64 CPR at the
    motor shaft, not the estimated 11 PPR. Output-shaft resolution is therefore
    8403.2 counts/rev under x4 decoding, not 5777.2 — about 45% higher. This also
    makes the W4 hand-rotation test diagnostic rather than merely confirmatory,
    since 8403 / 4202 / 2101 distinguish x4 / x2 / x1 decoding.
    It also shows the motor comfortably out-muscles the driver. Winding
    resistance cross-checks cleanly at ~2.18 o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
2026-08-25 docs: change the drive driver to DRV8874, and correct the encoder resolution
    Two findings from the CQRobot motor spec, recorded across PROJECT_CONTEXT.md
    and a new four-way driver comparison in docs/research/drive-motor/.
    Encoder resolution: 64 CPR at the motor shaft, not the estimated 11 PPR.
    Output-shaft figure is 8403.2 counts/rev under x4 decoding, 45% higher than
    the 5777.2 on record. This also makes the W4 hand-rotation test diagnostic —
    8403 / 4202 / 2101 distinguish x4 / x2 / x1 decoding.
    Driver: winding resistance cross-checks at 2.18 ohm from both stall points,
    giving 4.1 A stall at 9 V and 6.2 A at the 13.5 V branch rail, against the
    DRV8833 carrier's ~1.7 A continuous. Starti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
2026-08-25 docs: record measured motor electricals, and set the motor rail at 9.5 V
    Two units measured on the bench. The first stall reading was taken while the
    supply sagged unnoticed; re-run with the terminal voltage read, it gives
    4.1 A at 7.8 V, so R ~= 1.90 ohm rather than the 2.18 ohm derived from the
    datasheet. Recorded as provisional, since the supply was current-limiting and
    the measurement therefore only bounds R from above. The clean way to pin it
    down is noted: set the limit to 1 A, stall, read the terminal voltage.
    Motor rail set at 9.5 V. Stall is then 5.0 A, inside the DRV8874's 6 A peak,
    which is simpler than feeding the 13.5 V branch rail direct and relying on
    current regulation to ho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
2026-08-25 docs: confirm the motor resistance with a clean low-current stall
    Supply set to CC at 1 A and the terminal voltage read: 2.042 V / 1.020 A =
    2.00 ohm, and 2.3 V / 1.00 A = 2.30 ohm with the leads reversed. The direction
    difference is rotor position rather than polarity - reversing torques the rotor
    the other way, so different armature coils sit on the brushes.
    Combining with the earlier 4.1 A / 7.8 V point separates the winding from the
    brush drop: R_w = 1.87 ohm with a 0.14 V fixed drop, which is why the
    high-current test appeared to read lower. Stall at the 9.5 V rail works out at
    5.0 A either way, so the recorded design figure stands and only loses its
    provisional caveat.
    Co-Authored-By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
2026-08-26 W4: encoder firmware, and the acceptance criterion is met
    Ten hand turns of the output shaft gave 83 949 counts = 8394.9 per revolution
    against the predicted 8403.2, 0.1% low. Both the 64 CPR and the 131.3:1
    figures are confirmed and no constant changes. The accumulator matched the raw
    counter difference exactly across 84 000 counts and 1310 motor revolutions, so
    the delta arithmetic loses nothing.
    Firmware added:
    - encoder.c/h — TIM2 read as a signed delta into a 64-bit accumulator, never
    as an absolute position. Velocity is averaged over a window because a single
    1 kHz tick quantises to 7.14 rpm against a motor that tops out near 60.
    - drive.c/h — TIM4 PWM, nSLEEP and nFAULT, driv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
2026-08-26 chore: ignore KiCad local preferences and the context export
    *.kicad_prl holds per-user window and view state, not design data, so it
    churns on every open and shows up as spurious working-tree noise. It was
    already tracked, so it is untracked here as well as ignored — the local file
    is left in place, but it will disappear on the next checkout elsewhere.
    Uses the *.kicad_prl pattern rather than the single path, since HW1-HW4 will
    add the node PCB and PDB projects alongside BoardRover2.
2026-08-27 W4: PWM scope-verified — 20.000 kHz, both decay modes correct
    The gate before any actuator is wired, run with the motor disconnected and the
    driver left disabled so the MCU pins could be scoped with nothing able to move.
    All four quadrants behave: in fast decay the driven pin carries the PWM and the
    other sits low; in slow decay the other sits high and the PWM'd pin is
    inverted, so its LOW time is the drive fraction. Brake and coast as expected.
    Two readings initially looked wrong and were both the instrument:
    The frequency counter reported 19.92 kHz at asymmetric duty and 20.0 kHz at
    50%. The period cannot vary with duty — it is set by ARR alone, and CCR only
    moves the compare point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
    [drive.h]
2026-08-27 W4: first powered motion, and the plant turns out to be very linear
    Free shaft, no load, console-driven on the interim DRV8833 carrier.
    Least-squares fit over both directions gives rpm = 0.672 * duty% - 1.8 with a
    2.6% deadband. The per-step increments vary by only +/-1.5% across 20-100%,
    so W5 will not need gain scheduling - the most useful thing this test settled.
    Sign convention confirmed: positive duty drives CW and produces positive
    encoder counts, consistent at every point, so no lead swap is needed and the
    PID sign follows directly.
    Drive-scheme choice is now closed rather than merely defaulted. Slow decay's
    deadband is ~2.6% duty against fast decay's >20% - fast decay would not mo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
2026-08-27 W4: stop policy is coast, and the motor rail is confirmed at 9.35 V
    Measured 9.45 V at the supply and 9.35 V at the motor terminals under 100%
    duty, a ~1% drop. So the rail was never near the DRV8833's 10.8 V ceiling and
    the earlier 65.5 vs 60.2 rpm discrepancy is simply the motor running ~11%
    faster than its datasheet - 7.01 rpm/V measured against a specified 6.33.
    Ordinary spec conservatism, and it closes that open item.
    That measurement gives Ke = 0.138 V/rpm at the output shaft, which settles how
    the motor should be stopped.
    Coast and brake are not two flavours of the same thing. Coasting is a
    zero-current event at any speed; the residual inductive energy is 19 uJ.
    Braking shorts the w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
    [drive.h]
2026-09-12 W5 opens: harness closed, DRV8874 in hand, and a loaded wheel rig exists
    The three-week gap in the log was bench and delegation work, not a stall.
    All seven motors (six wheels plus the spare) have had their encoders
    checked and their cable extensions re-terminated with crimped joints to
    NASA-STD-8739.4A, so the broken-VCC conductor found on two motors Aug 25
    is now ruled out fleet-wide rather than assumed. That closes both of W4's
    outstanding harness items.
    The DRV8874 arrived ahead of the ~Sep 15 estimate, so the HW3 collision
    the Aug 16 roadmap revision warned about never happened, and the bench is
    no longer capped at the DRV8833's ~1.7 A.
    The more consequential change is a static tread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
2026-09-12 DRV8874: connection map, and PA2/ADC1_IN2 prepared for IPROPI
    The bridges stop being paralleled. The DRV8833 carrier tied IN1+IN3 and
    IN2+IN4 together to share current across two half-bridge pairs; the
    DRV8874 is one full bridge rated 6 A on its own, so PB6 drives EN/IN1 and
    PB7 drives PH/IN2 directly. Any jumper still paralleling inputs is wrong.
    drive.c is untouched and should stay that way — nSLEEP polarity, the 1 ms
    wake, the IN1/IN2 truth table and the open-drain nFAULT are identical on
    both parts, which is what the module was written driver-agnostic for.
    PA2 added to the .ioc as ADC1_IN2, labelled DRV_IPROPI. Sampling time is
    deliberately 28 cycles rather than the maximum 480: at P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
    [RobertUN_ModuleNode.ioc]
2026-09-12 isense: current sensing on PA2/ADC1_IN2, scaled to the carrier as measured
    The DRV8874 carrier's straps were measured rather than assumed, and two of
    the three change the design rather than just a constant.
    R_IPROPI is 2.48 kOhm, not the 2.2 kOhm the selection document guessed. With
    A_IPROPI = 450 uA/A that gives 1.1160 V/A, a 2.957 A full scale, and a 0.7219 mA
    LSB. Integer form, no float in the loop: I_mA = raw * 2957 / 4096.
    nSLEEP feeds VREF through 10 kOhm, so VREF sits at ~3.3 V whenever the driver
    is awake. That is why current sensing works with no other parts fitted, but it
    also means the chip now enforces a hardware current limit at 2.957 A where the
    DRV8833 had none - a stalled m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
    [console.c, isense.c, isense.h, main.c]
2026-09-13 VREF under software control: DAC1 on PA4, trip independent of the ceiling
    The bench carrier was modified by hand. The 10 kOhm between nSLEEP and VREF is
    gone and R_IPROPI is now 2.0k || 5.6k = 1.474 kOhm, down from 2.48 kOhm. Seven
    spare carriers remain stock.
    What that buys is separation. On the stock board VREF followed nSLEEP, so the
    ADC full scale and the current-regulation trip were the same number and could
    not be moved apart - both pinned at 2.957 A, below the 5.0 A the motor draws
    stalled at the 9.5 V rail. Now R_IPROPI alone fixes the ceiling at 4.975 A and
    the DAC sets the trip anywhere below it. One DAC code is 1.215 mA, exactly one
    ADC LSB, since both converters are 12 bits acro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
    [RobertUN_ModuleNode.ioc, console.c, isense.c, isense.h, main.c]
2026-09-13 W4: the .ioc was invalid, and regenerating it silently stopped both timers
    Two faults, the second caused by fixing the first.
    PA15 had been red and unclickable in CubeMX for two sessions. The .ioc was not
    corrupted — it was invalid. It used signal names that do not exist in the
    device database:
    PA15.Signal S_TIM2_CH1 -> S_TIM2_CH1_ETR
    PB6.Signal TIM4_CH1 -> S_TIM4_CH1
    PB7.Signal TIM4_CH2 -> S_TIM4_CH2
    and omitted the SH.* shared-signal blocks those names require, with the pin
    modes written as separate P<pin>.Mode= lines instead of living inside the SH
    entry. CubeMX accepted the file, silently dropped TIM2 and TIM4, and left PA15
    Locked=true pinned to nothing — whi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
    [RobertUN_ModuleNode.ioc, drive.c, encoder.c, main.c, main.h]
2026-09-13 W4: IPROPI decoded — the reading is supply current, not motor current
    The 20 kOhm IMODE strap blanks the IPROPI mirror during slow-decay
    recirculation, so isense_read_ma() returns I_motor x D.
    Settled by stalling the output shaft, which removes back-EMF and makes the
    motor current pure Ohm's law — no friction model in the way. At 20% duty,
    Vm 9.35 V, R_motor 1.90 ohm:
    continuous (motor current) 0.20 x 9.35 / 1.90 = 984 mA
    drive-phase only (supply) 984 x 0.20 = 197 mA
    measured, 256-sample avg, twice 189, 190 mA
    A 5x discriminator landing within 4%. The residual is accounted for: the
    bridge's own RDS(on), ~0.16 ohm across the two conducting FET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
    [console.c, isense.h]
2026-09-13 Motor rail reopened 9.5 V -> 12 V, and a config module is needed
    Two items, both consequences of the DRV8874 replacing the DRV8833.
    The 9.5 V motor rail exists only because the DRV8833 could not exceed 10.8 V.
    It was reconsidered on Aug 25 when the DRV8874's 37 V range removed that limit,
    and deliberately reinstated the same day on the reasoning that 9.5 V keeps
    stall at 5.0 A, inside the 6 A peak, "which is simpler than relying on current
    regulation to hold back a 7.1 A stall at 13.5 V".
    That was right at the time, because current regulation was unproven. It is now
    built, metered and verified end to end, so the trade is no longer a gamble. The
    motor is a 6 V/12 V unit and 9.5 V leaves ~21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
2026-09-13 Correct the 12 V rail entry: the per-motor buck stays, only its set-point moves
    Two corrections to the previous commit.
    The buck is not in question. The architecture is a >13.5 V supply stepped down
    by a regulator on each node PCB per motor, and that does not change - only the
    output set-point moves 9.5 V -> 12 V. The idea of deleting it and capping duty
    off the raw rail is recorded as considered and rejected: it would put switching
    motor current on the same rail as the MCU supply, which is exactly what the
    independent-feed rule exists to prevent, and it would make motor voltage track
    battery state of charge.
    The stall current also needed reconciling rather than alarming about. The
    datashe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
2026-09-15 config: the tunables move out of the code and into FLASH sector 7
    R_IPROPI is a resistor somebody soldered; VDDA is whatever the regulator
    actually makes. As #defines they cost an edit-build-flash cycle to change,
    cannot differ across the seven nodes without seven builds, and — worst —
    cannot be read back from a running board, so what is in a device is only
    knowable by finding the commit it was built from.
    Eight keys to start: vdda_mv, r_ipropi, a_ipropi, trip_ma, duty_limit,
    rail_mv, isense_avg, sat_raw. One table in config.c carries name, units,
    range, default and a line of help per key; adding one is an enum entry plus
    a row. The numbers stay in isense.h as _DEFAULTs so the reasoning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
2026-09-15 isense: compare trips as DAC codes, not milliamps
    The "not persistent" hint on drv trip was gated on the live trip differing
    from the stored config value. It fired on every call, including when the two
    agreed: isense_trip_ma() is derived back from the code that was written, so
    it is always quantised, while a stored config value is not. The boot line
    shows it plainly — config 3000, live 2997, same intent.
    A gate that always fires is worse than no gate, so the comparison moves to
    DAC codes, the only space where "would a reset change this?" has a yes/no
    answer. trip_code() now single-sources the mA -> code derivation for both the
    set path and the new isense_code_for_trip_ma(), so the two can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
    [console.c, isense.c, isense.h]
2026-09-15 cfg: revert and default re-apply the keys that have live counterparts
    Both replace the stored values underneath a board still running on the old
    ones, and nothing pushed them back into the hardware. The harmless direction
    is the trip; the dangerous one is the duty cap, where cfg could report 40%
    while the bridge was still enforcing 100%.
    cfg_apply_live() runs unconditionally rather than only for the two coupled
    keys. Both calls are idempotent, and a hand-maintained list of "which keys
    need re-applying" is exactly what goes stale the next time a key is added.
    Both paths now print the resulting trip and limit, so the re-application is
    visible rather than assumed.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
    [console.c]
2026-09-15 docs: record the config-module bench verification
    Eight checks on hardware, all passing, plus two findings worth keeping.
    A reflash does not erase sector 7 - the toolchain sector-erases only what it
    writes. That is load-bearing for W7: without it every firmware update would
    wipe each node's calibration.
    Both bugs the verification turned up were the same class - a consistency check
    comparing two values in a space where they were not comparable. Worth naming
    as a class, because the next one will not look like either of these.
2026-09-15 dipsw: module identity comes from the board, not the build
    Three switches on PB13/PB14/PB15, read once at boot and latched. PB13 was
    already in the .ioc; PB14/PB15 are configured by dipsw_init() rather than by
    CubeMX, for the same reason drive_init() starts its own PWM - a regeneration
    has silently emptied a USER CODE block on this project once, and a file we own
    cannot lose its own init. Guarded macros, so telling the .ioc about those pins
    later changes nothing.
    The heartbeat now goes to 0x500 + module ID, as can_bus.h always said it would.
    Identity also gates the transmit, not just the address: a board with no
    switches fitted reads 0b111 and would otherwise heartbeat at the base address
    a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
2026-09-15 console: the heartbeat help and the no-identity case tell the truth
    The help string still named 0x500, which stopped being this module's address
    when the DIP switch started supplying it. Turning the heartbeat on without an
    identity now says so at the point of the command, rather than leaving the
    per-frame NO ID line as the only clue.
2026-09-15 docs: module identity verified, and the lone-node mailbox signature
    All eight DIP codes swept on a board with a real switch block. The latch held
    while the pins moved, which is the invariant that stops two boards sharing a
    CAN address mid-run, and the transmit gate was proven in both directions.
    Also worth writing down: NO MAILBOX after exactly three frames is the lone-node
    signature of AutoRetransmission = ENABLE, not a fault. An unacknowledged frame
    is retried forever and never releases its mailbox, so three frames fill all
    three. It reads as a failure and is not one - which is the kind of thing that
    costs an afternoon if it is not on the page.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
2026-09-15 docs: PMODE is settled, and the DRV8874 line was two weeks stale
    The checklist still said the driver was "not yet wired" a week after first
    motion on it.
    PMODE needed no bench test. drive.c at 20% duty emits IN1 high and IN2 at 80%;
    under either PH/EN assignment one of those is EN, so the command would have
    produced ~50-55 rpm. It produced 11.07, within 6% of the DRV8833 at the same
    command. The measurement that answers it was taken on Sep 12 for another
    reason entirely.
2026-09-15 docs: nFAULT pull-up confirmed, and nothing is watching the pin
    Shorted to GND it reads ASSERTED, released it reads a clean high - and the
    clean high is the half that proves the pull-up is there. Only the MCU side is
    proven; that the driver asserts on a real fault still needs a UVLO test.
    Separately: nFAULT is read at boot and by 'drv', nowhere else. drive.h defers
    fault policy to W5 on purpose and that is the right call, but a transient OCP
    during the loaded-wheel measurement would currently leave no trace at all. A
    sticky latch is observation, not policy, and belongs before the rig work.
2026-09-15 drive: latch nFAULT in the 1 kHz tick, so a transient leaves a mark
    nFAULT was read at boot and by 'drv', nowhere else. An over-current that trips,
    auto-retries and clears between two console commands was completely invisible -
    and during a stall test on a loaded wheel that is exactly the event worth
    knowing about, and the one you are least likely to be watching for.
    This is observation, not policy. Nothing is disabled, no duty is dropped, and
    what to DO about a fault is still W5's call - drive.h's promise that the module
    never acts behind the caller's back is intact. The latch records three things:
    that it happened, for how many ticks, and at what duty it first fired. The
    duration is what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
    [console.c, drive.c, drive.h, main.c]
2026-09-16 firmware: PWM-synchronised current sampling, and a PB7 pad diagnostic
    TIM4_CH4 raises a compare event at the middle of the drive phase and the
    ADC converts on it. drive.c owns the placement because it is the only
    module that knows which end of the period is driven: slow decay drives
    the tail [ccr, ARR], fast decay the head [0, ccr). CH4 is PB9/CAN1_TX
    (AF9), so enabling CC4E routes nothing to a pin and the event stays
    internal. Configured in drive_init() rather than the .ioc, for the same
    reason the PWM is started there.
    isense gains the triggered path (adc_trigger_set, sync_burst,
    isense_read_sync_avg/at) alongside the free-running one, and console
    gains `drv iscan` to sweep the sample poi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
2026-09-16 docs: PMODE was never strapped, and it cost PB7
    The Sep 14 note "PMODE confirmed to select PWM mode" was wrong, and is
    now marked SUPERSEDED. The test behind it ruled out PH/EN by its speed
    signature and stopped there - it never enumerated the third state.
    PMODE is tri-level (SLVSF66A Table 2): LOW = PH/EN, HIGH = PWM,
    Hi-Z = independent half-bridge. The pin was left open, and an open pin
    is not unset: the internal 156k-to-5V over 44k-to-GND divider
    self-biases it to ~1.1 V, which sits inside V_TIZ (0.9-1.2 V). The
    board had been running in independent half-bridge for five days.
    That mode hid itself. Under slow decay each output follows its own
    input, so the average motor voltage is identic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
2026-09-18 docs: split PROJECT_CONTEXT.md into three scoped files
    The single context file had reached ~4500 lines, so every session paid
    for the whole project's history regardless of what it was about. It is
    now three files, and PROJECT_CONTEXT.md is a 24-line router that points
    at whichever one matches the work:
    PROJECT_CONTEXT_WHEEL_FW.md ~2340 default for STM32 firmware work
    PROJECT_CONTEXT_REST.md ~1820 machines, network, ROS 2/Jetson,
    bus architecture, power, tooling
    PROJECT_CONTEXT_WHEEL_FW_LOG.md ~470 full session detail, on demand
    The split itself was done by hand; this commit verifies and finishes it.
    Verification: all 163 se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
2026-09-18 docs: move session records out of the wheel-firmware context file
    Six sections were historical bench records rather than current state, and
    by the writing rule added in the previous commit they belong in the log:
    Verification log - Aug 9 (toolchain end-to-end) 51 lines
    Verification log - Aug 10 (W2 acceptance) 31
    Floating CAN_RX - Aug 10 (the three-run narrative) 19
    Bus-load ramp - Aug 11 (method + step table) 42
    Verification log - Aug 13 (W3 first motion) 36
    Torque characterisation - Jun 8 (rig, method, 15 rows) 34
    They moved verbatim into a new "Verification & characterisation logs"
    section of PROJECT_CONTEXT_WHEEL_FW_L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
2026-09-18 docs: move the DRV8833 and the finished tasks out of the session file
    The wheel-firmware context file is read whole at the start of every firmware
    session, so anything in it that is no longer live costs context on every
    session forever. Two things had stopped being live.
    The DRV8833 was replaced by the DRV8874 on Sep 11 — its characterisation, the
    J1 cut, the 10.8 V ceiling and the seven unused carriers are project history
    now, not working knowledge. The 114-line block moves to the log. What stays is
    the one rule buried in it that is still load-bearing: the node PCB carries a
    second buck off the 13.0-13.5 V PDB branch rail, now set to 12 V to protect the
    motor rather than the driver, and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
2026-09-18 docs: session close — MCU replaced, PB7 check is the first move
    Records that the board was swapped on Sep 18 and that nothing has been measured
    on the new one yet. Task 19 now opens with the bare-board check instead of
    burying it third: flash, leave PB6/PB7 unwired, run `drv pin`, and compare
    against the expected pass output, which is written out so next session does not
    have to re-derive why a bare pad matters. PB6/PB7 stay put — TIM3/PC6-PC7 is
    only a fallback if the replacement board fails too.
2026-09-19 docs: replacement board passes both PB7 pad checks, PMODE strapped
    Task 19's first item is retired. Bare `drv pin` gave both pads mode 2 af 2
    with IDR 0, and `drv pin pd` gave PB7 IDR 0 where the dead board read 1 —
    the pull-down test being the one that separates a live pad from a blown
    clamp. PMODE strapped with 10k to 3V3, latch still unconfirmed.
    Also records the VREF pull-down as considered and rejected: an unmodelled
    divider on that net would be indistinguishable from the internal divider
    the plateau sweep exists to measure.
2026-09-19 firmware: remove the temporary `drv pin` diagnostic
    The command was added Sep 15 to answer whether PB7's pad could still pull
    down, and it did its job twice: it condemned the old board (IDR 1 on the
    internal pull-down with every wire off) and cleared the replacement on
    Sep 19 (IDR 0 at the same step). The new board is verified, so it goes.
    Removes pin_report(), the `pin` branch with its 0/1/pd/af forms, and the
    help line. console.c is left with no direct register or HAL-GPIO access
    at all — GPIOB->, TIM4-> and HAL_GPIO_Init lived only in that block — so
    the file goes back to talking to hardware through the driver modules.
    Builds clean: RAM 4.11%, flash 22.84%.
    Note for whoever flashes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
    [console.c]
2026-09-20 docs: PMODE confirmed in PWM mode, ground return rebuilt, rail at 12 V
    Task 19 is cleared. The mode question was settled by scoping both motor
    outputs at 13% duty: one carries PWM, the other sits at GND all period.
    The quiet channel is the proof — independent half-bridge parks it at the
    rail, since each output follows its own input, while only PWM mode's
    IN1=1, IN2=1 -> OUT1 L, OUT2 L low-side decay pulls it to ground. Roles
    swap cleanly at -13%.
    Also corrects this file's own instruction, which told the reader to scope
    IN1/IN2. Those are MCU outputs and are identical in all three PMODE
    modes, so they could never have answered the question.
    Ground return is now three thick conductors from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
2026-09-21 docs: plateau sweep settles k=3 — every drv trip is 3x too high
    The DRV8874 compares IPROPI against VREF/3, not VREF. Confirmed
    predictively: two plateaus at trip 2997 held still (933, 911 mA) across
    a 7.6% shift in unregulated demand. k=1 and k=2 are refuted outright.
    Consequences recorded: the real trip range is ~100-1558 mA, the 3000 mA
    boot default is really 1000 mA, and the maximum trip is structurally one
    third of the ADC ceiling whatever R_IPROPI is — an HW1 trade, not a
    firmware fix.
    The current-sense chain is calibrated against physics for the first
    time: 1290 mA measured vs 1263 predicted at 20% duty stalled, 2%.
    Retracts the Sep 12 "the reading is SUPPLY current" conclusion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
2026-09-21 fw(isense): apply k=3, sample the settled tail, apply measured constants
    The Sep 20 plateau sweep established that the DRV8874 compares IPROPI
    against VREF/3, not VREF. Task 20, all items.
    - k=3 applied in the mA<->VREF conversion pair only, as a config key
    (cfg vref_div, 1..4, default 3) so a second-source part with a
    different divider is a console command rather than a rebuild. Every
    derived trip function follows; isense_raw_to_ma() is untouched because
    the ADC reads the resistor directly and never sees the divider.
    - Both conversion functions moved to uint64. Tripling the multiply made
    it wrap three times sooner: drv trip 3000 - the old boot default, and
    what habit types - ov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
2026-09-21 docs: close W4, open W5, record task 20's implementation
    W4's acceptance criterion (encoder counts match physical rotation) was
    met Aug 26. What kept it open for three weeks was current-sense work,
    and closing on the letter of the criterion would have handed W5 a plant
    model measured through an uncalibrated sensor on a driver that was not
    in the commanded mode. All four remaining items are now resolved: real
    drive current measured, plateau sweep run, the two constants applied,
    task 20 landed.
    W5 opened as task 21 with its acceptance criterion, what carries over
    from W4 (plant linear to +/-1.5% so no gain scheduling, sign convention,
    3.5% direction asymmetry, 32-bit TIM2), the one measuremen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
2026-09-22 Task 20 verified on the bench: drv current is +0.4% on physics
    12.0 V, 20% duty, shaft stalled: drv current = 1268 mA against
    D x Vm / R_motor = 1263 mA. The sync: line read "64 samples over 4
    ticks in 4100..4348" - the spread live, the 500-tick settle floor
    honoured, and the end-relative trigger exactly where the desk check
    put it.
    The same two traces re-reproduced the bug that was fixed: the old
    midpoint tick 4050 read 14.3% and 16.1% below the settled tail of its
    own run. Two iscans at an identical operating point differed by 9.3%,
    so the +-8% rotor-position floor is now the dominant uncertainty in
    the current path.
    Console: "1 code = 1 ADC LSB" -> "1 DAC code = 1/3 ADC LSB (VREF/3)".
    A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
    [console.c]
2026-09-25 fw+tools: telem stream, command watchdog, and the bench runner
    Ends the hand-transcription era: every plant number on record so far
    passed through a human reading four lines and typing them into a table.
    Firmware:
    - `telem on|off|rate <1..100>` emits T,seq,ms,duty,count,milli_rpm,mA,flags
    from the main loop beside console_report_encoder(). Integer fields only —
    %f pulls in newlib float printf and is far too slow at 50-100 Hz, so rpm
    travels as milli-rpm. Capped at 100 Hz: 115200 8N1 is 11520 byte/s and a
    ~55-byte line at 100 Hz is under half the wire.
    - `drv timeout <ms>` — a command watchdog, which drive.c simply did not
    have. It COASTS on expiry (braking a loaded rig from a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
    [bench.py, console.c, console.h, drive.c, drive.h, main.c, node.py]
2026-09-25 docs: 12 V free-wheel plant re-taken by tool, CCW closed
    Four sweeps via tools/bench/bench.py, enc window 100, trip 1580 mA set
    explicitly at run start, watchdog 2000 ms. All four integrity-clean:
    0 sequence gaps, 0 echo mismatches, 0 tx_dropped.
    The fixture changed this session — the wheel is now CLAMPED TO THE TABLE,
    where every Sep 23 figure was taken with the operator holding the wheel in
    their hands. That is a different plant, and it is why the intercept moved.
    CW ascending 11-39% rpm = 0.8327 d - 1.524 R2 0.99993 max|res| 0.117
    CW descending 11-39% rpm = 0.8187 d - 0.752 R2 0.99993 max|res| 0.134
    CCW ascending 11-39% rpm = 0.8618 d - 1.164 R2 0.99999 max|res|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
2026-09-26 bench: host-side entry/exit ramps, 30% duty ceiling, crash-safe run records
    The rover runs slow, so characterisation stops at 30% duty. Above ~31% the
    wheel starts to bounce on the rig belt and the points measure the rig, not the
    plant. Default sweep walks 5-29% in 2% steps so breakaway and the band's
    curvature are resolved rather than bracketed.
    ramp() is a host-side stand-in for the firmware slew-rate limiter that is still
    owed. It is what makes a loaded start possible at all: the Sep 23 trips were
    never caused by the duty level, only by the step size. 1% steps hold peak
    current under ~460 mA where a direct step to 29% demanded 12 V / 1.87 Ohm.
    Two crash-safety fixes, both found by SIGKI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
    [bench.py]
2026-09-26 bench: keep the four plant-identification runs as raw data
    runs/ is gitignored because most runs are scratch. These four are not: they are
    the measurement the 12 V plant model rests on, and the rig cannot be put back
    in exactly the same state to retake them.
    18-32-39 free wheel, ascending 5-39%
    18-33-58 free wheel, descending 39-2%
    21-29-48 loaded rig 1047 g, ascending 5-39%, 30 s dwell, 2% steps
    22-00-34 loaded rig 1047 g, descending 29-5%, 30 s dwell, 12->29% entry ramp
    console.log is committed alongside the parsed CSVs on purpose. It is the raw
    byte-for-byte transcript, so a parser bug costs an analysis and never a run.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
    [events.csv, sweep.csv, telemetry.csv]
2026-09-26 docs: loaded-rig plant model, and tau measured twice by independent routes
    Loaded-rig pass on the treadmill belt (1047 g, 12 V, 2% steps, 30 s dwell,
    both runs integrity-clean). Pooled rpm = 0.7993 d - 2.420 over 11-29%; the
    load costs only 4.3% of the free-wheel slope. Breakaway 9-11% duty is the
    same TERMINAL VOLTAGE as Sep 15's 12-14% at 9.35 V, so breakaway is a voltage
    threshold and its duty is not portable across rails. Current separates Coulomb
    (free, flat) from viscous (loaded, +4.4 mA/%). Above ~31% the wheel bounces on
    the belt and the slope lifts 16.3% -- the rig, not the plant.
    Retracts the tau ~ 0.65-0.70 s reported earlier the same day. The plant is
    two-pole: tau_fast 0.219 +/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
2026-09-26 fw(drive): duty slew limiter on the 1 kHz tick, off by default
    A commanded duty becomes a target; the bridge walks to it at a configured
    rate. Nothing in the system can step it any more.
    Placement: this went INSIDE drive.c as mechanism, reversing the "control
    layer, not drive.c" position the context file held. drive_set_duty() calls
    drive_kick() on purpose -- a duty command is evidence of a live host -- so
    a ramp module above drive.c would refresh the command watchdog 1000x/s and
    a dead host would never again be detected. Same mechanism/policy split the
    watchdog itself uses. Secondary: a limiter callers can route around is
    advisory; inside, the invariant is unconditional.
    The accumulator i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
    [config.c, config.h, console.c, drive.c, drive.h]
2026-09-26 docs: task 21 verified on the loaded rig, and the A/B is on record
    Bench pass taken in two stages: everything provable with the driver
    disabled was proven at the desk first, and only then was anything
    energised. The rig run was logged to file at 100 Hz by script rather than
    pasted -- 1462 lines, zero seq gaps, no fault latch, no ADC saturation.
    slew rate 50.00 o/oo/s fitted over 340 samples, against 50 commanded
    climb 120 -> 290 in 3400 ms, against 3400 predicted
    floor 0 -> 120 in one sample, encoder moving 10 ms later
    peak current 581 mA, vs the host prototype's 572, 2.7x under the trip
    The A/B against drv ramp 0 is the evidence the feature works: the same
    0 -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
2026-09-26 fw(velocity): closed-loop wheel speed - the W5 PID module
    A policy layer above drive.c. It owns setpoint, feedforward, PID and the
    setpoint ramp; it never touches TIM4, nSLEEP or the fault latch. The whole
    actuator interface is drive_set_duty() and drive_coast().
    Three decisions worth stating in the log, because they are not obvious from
    the code:
    ENABLING THE LOOP DEFEATS drive.c's COMMAND WATCHDOG. drive_set_duty() kicks
    it deliberately - "a duty command is proof the caller is alive" - which is
    exactly why task 21's slew limiter went inside drive.c. This module is above
    drive.c and calls that function 50x/s forever, so while it is armed the drive
    watchdog can never fire. That is what clo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
2026-09-26 fw+bench(w5): V, telemetry per control step, and a step-response profile
    The velocity loop landed with no way to see inside it. `vel` prints at
    console pace; a step response is a 1-2 s event at 50 Hz. The `T,` line
    says what the bridge and plant did and nothing about what the loop
    decided, so tuning against it means inferring the controller's internals
    from its output.
    Firmware
    - velocity.c: volatile on every ISR-written static. It shipped without
    any, which encoder.c and drive.c both get right. Latent until
    something copied the state out - which is exactly what this change
    does. Cached gain floats stay non-volatile, thread-write/ISR-read.
    - velocity_take_sample(): one slot,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
2026-09-26 The velocity loop holds for 21 minutes; the step metric was measuring vel_slew
    Bench pass on the loaded rig at 12 V with the shipped gains, then a metric
    fix that the pass made necessary.
    The 21-minute staircase (21 setpoints, 10.0 -> 20.0 rpm, 60 s each,
    uninterrupted). A step response says whether the loop is stable and nothing
    about whether it is accurate, drifts, or pays for the 1/4-of-textbook
    derating -- which are the questions that decide whether these gains reach
    the rover.
    - 63,202 V rows, 0 sequence gaps, 0 unpublished steps, 0 tx_dropped.
    - Tracking: mean error +0.0008 rpm, worst 0.015, against a ~0.020 rpm
    per-point standard error. Accurate below the instrument's noise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
    [bench.py, console.c]
2026-09-26 tools(bench): add the stair profile, and keep sign out of its magnitudes
    The forward staircase had been driven by a scratchpad script. Promoting it to
    a real profile is what surfaced the bugs below, which is most of the argument
    for promoting it.
    profile_stair holds a series of setpoints under ONE arming: tearing down and
    re-arming between points would reset the integrator at every point and throw
    away exactly the slow drift a long run exists to capture. Per point it
    discards --hold-settle seconds of vel_slew ramp at the head and takes settled
    statistics over the tail, aborting on --abort-ma or any watchdog fraction.
    stair.csv keeps the column order the existing figure loader already reads.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
    [bench.py]
2026-09-26 bench: keep the two reverse staircase runs
    runs/ is gitignored by default, so a run worth keeping goes in deliberately.
    Both of these are cited by the figure and the log, so both are added.
    - 2026-09-26T11-01-57_stair, 25 s: the short -10 rpm direction check that
    ran before the long one.
    - 2026-09-26T11-02-46_stair, 21 min: 21 points, -10.0 -> -20.0 rpm, 60 s
    each, uninterrupted. outcome=ok, NOT suspect. 63,203 V rows, 0 sequence
    gaps, 0 velocity gaps, 0 unpublished steps, 0 tx_dropped.
    Same profile, same gains, same rig as the forward run already kept here; the
    only argument that differs is --dir ccw. The pair is what the direction
    figure rests on, and a comparison whose i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
2026-09-26 figures: the same staircase both ways, and a ripple claim that was not real
    velocity_loop_stair_direction.png, from the forward and reverse 21-minute
    runs. A separate figure rather than more panels on the forward one: that
    figure's four panels each carry a single-run argument with long annotations
    and have no room, and this data's value is entirely comparative -- every
    interesting number here is a difference, which is a different thesis.
    The headline, panel A: corr(d|out|, di) = 0.9986, the two difference curves
    0.62 o/oo rms apart. The feedforward takes the sign of the SETPOINT
    (velocity.c:346) and is therefore symmetric by construction, so it cannot
    absorb a plant that is not -- every bit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
2026-09-26 docs: the reverse staircase, and four learnings from getting it wrong first
    Records the reverse 21-minute run and the forward/reverse comparison in the
    wheel-firmware context file and its log, and corrects the forward entry's
    ripple figure in place: 11.91 +/- 0.19 is cross-referenced to the refined
    11.998 +/- 0.017 so the two figures do not read as a disagreement.
    The result: tracking is BETTER in reverse (worst settled error 0.006 rpm
    against 0.015), 0% saturation at all 21 holds at a peak of 277 of 300 o/oo,
    and the direction asymmetry is entirely the integrator. This also corrects a
    prediction made earlier in the session -- that the top of the reverse range
    would saturate -- which was ex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
2026-09-26 repo: raw bench CSVs are local-only, and the ignore rules now say so
    A run's CSVs are raw instrument output - tens of thousands of rows, 16 MB
    across the 40 files that were tracked - and they are INPUT to the figure
    scripts in docs/environment/figures/, not a record anyone reads. The repo
    keeps the figure and the numbers quoted in the docs; the rows behind them
    stay on the bench machine.
    - *.csv in the root .gitignore. Every tracked CSV in the repo was bench run
    data, so the blanket rule costs nothing today.
    - tools/bench/.gitignore rewritten. Its old comment told the reader to
    `git add -f tools/bench/runs/<name>`, which would have undone this
    immediately; it now says the opposite, an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
    [events.csv, sweep.csv, telemetry.csv]
2026-09-26 docs(wheel-fw): move context sections verbatim into reference files and the log
2026-09-26 docs(wheel-fw): 10 KB hot context file; detail now lives in the REF files and the log
2026-09-27 docs(wheel-fw): A/B/A staircase separates direction (~5.9 o/oo) from drift (-3.05 o/oo in 42 min)
2026-09-27 docs(wheel-fw): true step response (--slew 0) shows no overshoot above the 12/rev ripple; ripple test flaw noted
2026-09-27 bench: overshoot_above_ripple compares the peak with the settled tail's own worst excursion
    The 2 x sd test assumed Gaussian ripple; the 12-per-rev dips are impulsive,
    so their extremes sit past 2 sd and down-steps were flagged for dips the
    settled hold also shows. The peak now has to beat the tail's worst excursion
    in the same direction plus one encoder count. New column tail_excursion_rpm.
    [bench.py]
2026-09-27 docs(wheel-fw): step re-reduced with the fixed ripple test; reverse down-step undershoot is real (~0.7 rpm)
2026-09-27 docs(wheel-fw): reverse down-step repeated x3, undershoot does not recur; no overshoot above ripple either way
2026-09-27 docs(wheel-fw): decide against a direction-dependent ff_b for now; re-check on the rover on >=2 wheels
2026-09-27 docs(wheel-fw): session summary for the Sep 26 evening; one progress line for the session
2026-09-27 docs(wheel-fw): decay-phase IPROPI validated below the 14.5% floor: 0.690 x I, +/-4% from 6% duty
    Stalled A/B/A iscan series 5-12% duty bracketed by 20% references. Factor
    0.690 (+/-1.5%, 17 refs); valid points 6-12% within +/-4%; 5% invalid.
    Sep 21's 0.670 was sampled 50 ticks before the drive edge (aperture overlap).
    Decision: read low-duty current in the decay phase; Isup and a slower
    carrier are not needed. isense.h: mark the Sep 15 zero-decay note as
    pre-PMODE-strap.
    [isense.h]
2026-09-27 feat(wheel-fw): sample current in the slow-decay brake phase below 14.5% duty
    Below the 652-tick drive-phase floor, slow decay now places the ADC trigger
    in the brake phase (last = ccr - 152, first = max(1000, last - 500)) and
    isense scales the reading x1000/isense_dk. Fast decay, coast, brake and
    duty below isense_dmin still fall back to free-running Isup.
    - drive: drive_sense_t and drive_sense_kind/first/last(); geometry only
    - cfg: new keys isense_dk (690 o/oo) and isense_dmin (60 o/oo). Adding
    keys discards the stored cfg record (never saved on the bench board)
    - console: drv current names the phase/window and the refusal reason;
    telemetry flag 0x20 = brake-phase sample; node.py Tel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
2026-09-27 docs(wheel-fw): DMM supply reference at 20%/15%: drive-phase IPROPI reads low while turning (0.74/0.83, +/-20%)
2026-09-27 docs(wheel-fw): first cfg save on the bench board (trip 1580, duty_limit 300, ramp 50/120), verified across a reset
2026-09-27 docs(wheel-fw): W5 acceptance tolerance stated: 60 s mean <= +/-0.05 rpm, 0% sat, ripple 12/rev, step within ripple
2026-09-27 docs(wheel-fw): 6-10 rpm A/B/A passes (worst -0.019 rpm, 12.00/rev); ripple criterion amended to sd <= 1.5 rpm; W5 met on the rig
2026-09-27 docs(wheel-fw): W5 complete on the rig; rover tau, gain freeze and 2-wheel offset deferred to the rover
2026-09-27 docs(wheel-fw): 12/rev velocity ripple identified as the tyre's 12 tread grooves; item resolved
2026-09-27 task17: 0.5%-step stiction A/B/A (breakaway CW 12.5-13.0%, CCW 10.5-11.0%; dropout 8-9.5%); sweep sends per-mille duty
2026-09-27 docs(wheel-fw): pre-Sep-20 measurements invalid (wrong PMODE), post-Sep-21 all 12 V; voltage-threshold lesson withdrawn
2026-09-27 docs(wheel-fw): task 17 pre-Sep-20 figures marked invalid, stale boxes closed; breakaway-vs-dwell discrepancy recorded
2026-09-27 docs(wheel-fw): drop breakaway-vs-dwell item; task 17 done on the rig
2026-09-27 fix(wheel-fw): drive.c ISR/main-loop shared statics missing volatile
    duty, limit, decay, enabled, phase_ticks, phase_start, phase_trigger,
    sense_kind, sense_first, sense_last are all written from drive_on_tick()
    in the TIM6 ISR and/or read from the console main loop, but lacked the
    volatile qualifier the rest of the module's shared statics carry.
    Flagged by the firmware data-flow survey.
    [drive.c]
2026-09-27 docs(wheel-fw): add firmware module map and data-flow survey
    firmware_map.md: application modules from Core/Inc headers, grouped by
    category, as a Mermaid mindmap plus a table.
    firmware_dataflow.md: full interrupt/tick/main-loop data-flow survey from
    Core/{Inc,Src} — control path (encoder -> velocity -> drive -> PWM ->
    current sense) and command/telemetry path (console/CAN -> cfg/velocity/
    drive, T,/V, telemetry out), with a connection table, ISR/main-loop shared
    variable list, and an Unverified section. Surfaced the missing-volatile
    issue fixed in 5903fbf.
2026-09-28 docs(wheel-fw): add task 6 CAN RX latency reference and ISR-to-ring plan
2026-09-28 feat(wheel-fw): enable CAN1 RX0 interrupt in CubeMX, priority 1 (task 6 step 1)
    CubeMX regeneration only: CAN1_RX0_IRQHandler stub, NVIC enable at
    preemption priority 1 (TIM6/TIM7/USART1/UART4/DMA stay at 0). Notification
    is not armed yet; RX is still polled. Bench check: cansend 123#11 gives
    rx_frames 0 -> 1.
2026-09-28 feat(wheel-fw): single ESR snapshot for errors and heartbeat (task 6 step 2)
    can_bus_errors() reads CAN1->ESR once; cmd_errors and the heartbeat frame
    and log line decode every field from it, fixing the non-atomic read.
    Bench: errors 0x00000000 / TEC 0 / REC 0; candump 0x500 bytes 4-7 all 00,
    sequence 0..16 matches hb 1..17 on the console.
    [can_bus.c, can_bus.h, console.c, main.c]
2026-09-28 feat(wheel-fw): volatile CAN stats, IRQ-masked snapshot/clear, ring counters (task 6 step 3)
    Stats become volatile with a single writer per field; can_bus_stats() is
    replaced by can_bus_stats_snapshot() and clear masks only CAN1_RX0. Adds
    rx_ring_dropped / rx_ring_hwm (0 until the ring exists) and a 'can ring'
    line in stats. Bench: 10 frames from cangen -> rx_frames 10, 0 FIFO-full,
    0 overruns, ring 0/0.
    [can_bus.c, can_bus.h, console.c]
2026-09-28 feat(wheel-fw): interrupt-driven CAN RX into a 32-slot ring (task 6 step 4)
    CAN1 RX0 ISR (HAL_CAN_RxFifo0MsgPendingCallback) drains FIFO0 into an SPSC
    ring; can_bus_receive() pops it from the main loop. Full ring drops and
    counts, never blocks. Notification armed in init and re-armed after the
    loopback Stop/Init. Bench: orion frame -> 1 rx line, rx_frames 1, ring
    hwm 1; loopback on/off -> both frames received, tx 1 / rx 2, 0 dropped.
2026-09-28 feat(wheel-fw): canhold test command to overflow the CAN RX ring (task 6 step 6)
    Bench: canhold 100 under -g 0.45 saturation gave ring high-water 32/32,
    165 dropped, 0 FIFO-full, 0 overrun events, console live, heartbeat
    sequence consecutive across the hold, TEC/REC/LEC clean. Orion TX packet
    count for this run was not captured, so rx_frames == TX delta is not
    confirmed for step 6.
2026-09-28 docs(wheel-fw): log task 6 ISR-to-ring bench results, no merge decision yet
2026-09-28 claude: wheel-fw skill — build and flash with short verdicts
2026-09-28 claude: wheel-fw skill — console.py over node.py, motor-command safety rule
2026-09-28 docs(wheel-fw): task 6 closed, ISR-to-ring accepted; re-run results, ESR fixed
2026-09-28 docs(wheel-fw): record W6 corner-node integration as done (user-stated), W7 next
2026-09-28 docs(wheel-fw): correct W6 to the CAN RX work (task 6); W5 open item is the rover tau; W7 started
2026-09-28 docs(roadmap): status as of Sep 28 — W5 done on the rig (rover tau open), W6 CAN RX done, W7 started
2026-09-28 docs: W6 partial — CAN RX done, absolute positioning and corner-node integration still open (hot file, roadmap)
2026-09-28 docs(wheel-fw): close tasks 17, 18, 20 (moved verbatim to the LOG); renumber the open list 1-4
2026-09-28 docs(wheel-fw): move closed task 6 from _REF_TASKS to the LOG, verbatim
2026-09-28 docs: W6 CAN command set spec (draft) — ID scheme, frames, counter + CRC-8, safety; CANopen conflict open
2026-09-28 docs(wheel-fw): log the W6 CAN command spec; hot-file progress line
2026-09-28 docs: W6 CANopen interface spec (draft) — CiA 402 drive + mfr steering, OD, PDOs, NMT, safety, stack; alternative to can_cmds.md
2026-09-28 docs(wheel-fw): log the W6 CANopen spec; hot-file progress line
2026-09-28 docs(wheel-fw): next tasks reordered — CAN vs CANopen decision first, then one corner node
2026-10-04 feat(wheel-fw): 4-bit module ID on PB12-PB15, nFAULT moved to PB0
    CubeMX: PB12-PB15 relabelled DIP_SW_0..3, PB0 = DRV_nFAULT (input,
    pull-up). Plain binary ID: 0 = broadcast address and 15 = unfitted are
    both refused; 1-4 corner, 5-6 center, 7-14 reserved. Heartbeat CAN IDs
    0x501-0x50E. Bench-verified: nFAULT latch on PB0, IDs 0/1/2/9/15.
2026-10-04 docs(wheel-fw): 4-bit DIP ID and nFAULT on PB0 — pin table, identity section, log, hot file
2026-10-04 docs(wheel-fw): W6 protocol = plain CAN; can_cmds.md to 4-bit addr, 0 = broadcast
    ID = (type << 4) | addr. ESTOP broadcast at 0x000; CMD_RESULT moved to
    type 0x08 to keep the priority order. canopen_cmds.md marked not selected;
    REST KEY DECISIONS notes the wheel-node override. Hot file and LOG updated.
2026-10-04 docs(wheel-fw): W6 CAN command implementation plan (7 phases); Q3/Q13/Q18 decided
2026-10-04 feat(wheel-fw): W6 phase 1 — can_cmd + motion modules, ESTOP/STOP over CAN
    - motion.c: ESTOP latch (vel off -> coast -> mks stop, retried until sent),
    estop clear refused while the loop is armed.
    - can_cmd.c: O->N type + address filter (own or broadcast), ESTOP and STOP
    on the ID alone, CMD_RESULT, rate-limited FAULT, CRC-8/SAE-J1850.
    - console: `estop [clear]`, `can [crc]`; motion commands refused while latched.
    - main.c (USER CODE only): init, drain-loop dispatch, polls.
    Bench, node 2: broadcast ESTOP coasts a 15% duty run, latches, CMD_RESULT
    and FAULT ESTOP within 0.6 ms; STOP modes and address filter as specified.
2026-10-04 docs(wheel-fw): W6 phase 1 bench results — log entry, hot file
2026-10-04 feat(wheel-fw): W6 phase 2 — ARM, SPEED, STATUS_DRIVE, rolling counter, vel_tmo FAULT
    ARM actions 0-3, SPEED (±100 rpm, NOT_ARMED while the vel_tmo latch is set),
    §5.1 counter windows per type (own/broadcast, commit only on accept),
    STATUS_DRIVE per control step, FAULT VEL_WD_EXPIRED and SKIPPED_CTR.
    Host tool tools/bench/cancmd.py + canproto.py over kernel SocketCAN.
    [can_cmd.c, can_cmd.h, cancmd.py, canproto.py, console.c]
2026-10-04 docs(wheel-fw): W6 phase 2 bench results — log entry, hot file, plan host-tool note
2026-10-04 feat(wheel-fw): W6 phase 3 — UART/CAN ownership of motion (§7.3)
    motion_may/claim/release in motion.c: the source that armed owns motion,
    stops and disarms from either side release it. Console motion commands
    refused while CAN owns; CAN ARM 1/SPEED answered UART_OWNS while the
    console owns. STATUS_DRIVE bit 7, owner in console 'can'.
2026-10-04 docs(wheel-fw): W6 phase 3 bench results — log entry, hot file
2026-10-04 refactor(wheel-fw): W6 phase 4 — config_apply_live() shared by cfg and CAN
    Move the per-key live apply out of cmd_cfg into config_apply_live(key) in
    config.c, and cfg_apply_live() into config_apply_limits(). The console keeps
    only the "applied now" prints, read back from the modules.
    Checked on the bench: a 32-command cfg transcript (every key set, get,
    out of range, unknown key, default key/all, revert, save) is byte-identical
    before and after.
    [config.c, config.h, console.c]
2026-10-04 feat(wheel-fw): W6 phase 4 — LIMITS, RAMP, CFG_REQ/CFG_RESP
    - LIMITS (0x06x) and RAMP (0x07x): one handler, counted and CRC-checked;
    every masked field range-checked before anything applies (RANGE, detail =
    mask bit, never clamped); empty/unknown mask -> BAD_ACTION; ownership gate
    only (UART_OWNS), as the console's limit commands. Live only.
    - CFG_REQ (0x52x) -> CFG_RESP (0x53x): ops 0-9, tag echoed, no counter. CRC
    over bytes 0-2 and 4-7. SET goes through config_apply_live(); REVERT and
    DEFAULT through config_apply_limits(); SAVE BUSY while the bridge is
    enabled or the loop armed. DLC < 8 is answered with status CRC.
    - cancmd.py: limits, ramp and cfg subcommands; canproto.py f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
    [can_cmd.c, can_cmd.h, cancmd.py, canproto.py]
2026-10-04 docs(wheel-fw): W6 phase 4 bench results — log entry, hot file
2026-10-04 fix(wheel-fw): revert/default re-apply every config key
    config_apply_limits() (trip + duty_limit only) becomes config_apply_all(),
    which runs config_apply_live() over every key in index order. Before, after
    a revert `cfg vel_kp` read 3000 while the loop still ran 2500; ramp keys the
    same. Used by console `cfg revert`/`cfg default` and CAN CFG REVERT/DEFAULT.
    Console text "both re-applied" -> "all keys re-applied"; otherwise the cfg
    transcript is unchanged.
    can_cmds.md §4.8/§7.1: vel_tmo SET, REVERT and DEFAULT re-arm the setpoint
    countdown (not a keep-alive); CFG_REQ with DLC < 8 is answered with CRC.
    [can_cmd.c, config.c, config.h, console.c]
2026-10-04 docs(wheel-fw): W6 phase 4 follow-up — revert re-applies all keys, spec notes
2026-10-04 feat(wheel-fw): W6 phase 5 — STEER, STATUS_STEER, PA1 pull-up
    - steer.c: absolute steering on top of the relative FD move. Position is
    the sum of completed moves' commanded pulses, zeroed at STEER_ENABLE.
    A STEER during a move is deferred to its end (one FD for the
    difference); any other ending invalidates the position.
    - can_cmd: STEER handler (RANGE, ESTOP, UART_OWNS, NOT_ARMED), ARM
    steeron/steeroff, STATUS_STEER at 10 Hz, steer errors -> FAULT
    MKS_ERROR. Corner/reserved nodes only.
    - mks_servo: transaction sequence number and completion_pending() so
    steer takes only its own completions.
    - console: `steer` command; console moves/enables drop CAN steering.
    - CubeMX: PA1 (UART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
    [RobertUN_ModuleNode.ioc, can_cmd.c, can_cmd.h, cancmd.py, canproto.py, console.c, main.c, mks_servo.c]
2026-10-04 docs(wheel-fw): W6 phase 5 bench results — log entry, hot file, SERVO42C pull-up/echo note
2026-10-04 docs(wheel-fw): W6 phase 5 extra CAN checks — rejections, ESTOP mid-move
2026-10-04 docs(wheel-fw): fix spec section ref in phase 5 log entry
2026-10-04 feat(wheel-fw): W6 phase 6 — bus-off stop, ERROR_PASSIVE/RX_RING/DRV_FAULT FAULTs
    - velocity_expire_now(): the next tick runs the vel_tmo expiry path (works
    with vel_tmo 0); bus-off on a CAN-armed loop calls it at once (§7.2).
    - can_cmd_poll: one ESR read per pass; FAULT BUS_OFF_RECOVERED on rejoin,
    ERROR_PASSIVE on entry, RX_RING_DROPPED on any ring drop, DRV_FAULT on
    the nFAULT latch edge. `can` prints bus-off/error-passive entry counts.
    - can_bus_tx_free(): pending FAULTs wait for a free mailbox instead of
    counting a drop every main-loop pass (36 M after one bench short).
    - cancmd.py: ENOBUFS no longer aborts a speed run; refused frames counted.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
    [can_bus.c, can_bus.h, can_cmd.c, can_cmd.h, cancmd.py, console.c, velocity.c, velocity.h]
2026-10-04 docs(wheel-fw): W6 phase 6 bench results — log entry, hot file, spec §7.2
2026-10-04 feat(wheel-fw): cancmd.py corner mode — SPEED + STEER together, measured bus load
    W6 phase 7 host tool: SPEED at --rate and a STEER triangle at --steer-rate
    (sent on change) in one loop, frame census with worst-case stuffed bits,
    optional ARM 1 just before the stream, closing STOP coast.
2026-10-04 docs(wheel-fw): W6 phase 7 bench results — spec §5.2/§6.3, Q13/17/18, REF_MCU can_cmd
    One corner node at SPEED 50 Hz + STEER 10 Hz: 130 f/s, 6.9 % load, ring hwm
    2/32, zero drops. §6.3 adds STEER's CMD_RESULT: six nodes 732 f/s, 39.5 %.
    §5.2 gains the CRC check value 0x4B and the CFG_REQ CRC input order.
2026-10-04 docs(wheel-fw): HEARTBEAT stays off at boot (decided); PR #1 noted
2026-10-04 docs(wheel-fw): W6 merged to main; hot file points at W7
2026-10-08 docs(wheel-fw): annotated photo of the first wheel-driver prototype
    Prototype_DriverWheels_boxes.jpg: 12 numbered connector/element boxes,
    pin tags relating each connector to its MCU pin, the 3V3 rail, and
    coloured dots on the STM32F446RE core-board headers. Generated by
    docs/figures/driverwheels_boxes.py (GrabCut mask from
    driverwheels_mask.py). Original photo added unchanged.
2026-10-08 docs(wheel-fw): servo connector tags GND_1/GND_2 -> GND
2026-10-08 docs(wheel-fw): annotated bottom photo of the wheel-driver prototype
    Prototype_DriverWheels_Bottom_boxes.jpg: battery terminal (V_bat/GND),
    12 V and 3V3 buck converters with IN+/IN-/OUT+/OUT- pads tagged and
    net-coloured dots, black traces marked as GND. Generated by
    docs/figures/driverwheels_bottom_boxes.py (mask from
    driverwheels_bottom_mask.py). Original photo added unchanged.
2026-10-08 docs(wheel-fw): pin-connection table as HTML (MCU pins, connectors, power rails)
2026-10-08 docs(wheel-fw): servo RX->PA0 tag notes its 10k pull-up (photo + pin table)
2026-10-08 docs(wheel-fw): pull-up tag moves to servo TX->PA1 (5.1k), not RX->PA0
2026-10-08 refactor: move repo into the rover_UN layout
    The working tree now lives at ~/rover_UN with a top-level split by kind:
    BoardRover2/ -> hardware/BoardRover2/
    firmware/RobertUN_ModuleNode -> firmware/projects/RobertUN_ModuleNode
    docs/{environment,plans,linux} -> docs/dev/
    docs/other_rovers_images -> docs/images/other_rovers/
    docs/Prototype_*.jpg -> docs/images/prototype/
    Pure renames plus path fixes in the wheel-fw skill scripts, CLAUDE.md, the
    context files, the figure scripts (one level deeper on both sides) and the
    bench docs. Historical command transcripts in docs/dev/linux are left as
    recorded. .gitignore now keeps local/, logs/, docs/reference/ and l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
    [BoardRover2-B_Cu.gbr, BoardRover2-B_Mask.gbr, BoardRover2-B_Paste.gbr, BoardRover2-B_Silkscreen.gbr, BoardRover2-Edge_Cuts.gbr, BoardRover2-F_Cu.gbr, BoardRover2-F_Mask.gbr, BoardRover2-F_Paste.gbr]
2026-10-08 chore(hardware): stop tracking KiCad lock, autosave, cache and backup files
    The 19 timestamped backup zips (3.5 MB), the two ~*.lck lock files, the
    #auto_saved_files# pointer (it held another user's home path) and
    fp-info-cache are machine-local KiCad state, not design data. They stay on
    disk and are now git-ignored; the schematic, PCB, project and Gerbers remain
    tracked. History keeps the old copies.
2026-10-08 docs(wheel-fw): log the move to ~/rover_UN and the new layout
